kemomi/Btai-AR/眼镜板子/眼镜板子/_左镜腿主板下层/BOM_左镜腿主板下层V1.1_左镜腿主板下层_2026-10-14.xlsx

No. | Quantity | Comment | Designator | Footprint | Value | Manufacturer Part | Manufacturer | Supplier Part | Supplier | Add into BOM | Convert to PCB | 3D Model Title | Device | Name | Symbol | Unique ID | Category | Primary Category | Secondary Category | Category3 | Category4 | Category5 | Pin Count | drawing:Y Region Count | drawing:X Region Count | drawing:Width | drawing:Version | drawing:Title Block Position | drawing:Title Block | drawing:Symbol | drawing:Size | drawing:Reviewed | drawing:Region Start | drawing:Part Number | drawing:Page Size | drawing:Name | drawing:Height | drawing:Footprint | drawing:Drawed | drawing:Description | drawing:Device | drawing:Company | drawing:Color | drawing:Border | drawing:Blade Width
1 | 1 | 10NF | C1 | C0201 | 10NF | GRM033R61E104KE14D | muRata(村田) |  | LCSC | yes |  | C0201_L0.6-W0.3-H0.3 | GRM033R61E104KE14D | 10NF |  | gge14823 |  |  |  |  |  |  | 2
2 | 6 | 10UF | C2,C5,C7,C8,C29,C37 | C0402 | 10UF | CL05B104KO5NNNC | SAMSUNG(三星) |  | LCSC | yes |  | C0402_L1.0-W0.5-H0.5 | CL05B104KO5NNNC | 10UF |  | gge187,gge188,gge14821,gge14824,gge14824_0,gge14838 |  |  |  |  |  |  | 2
3 | 5 | 22UF | C3,C4,C23,C24,C208 | C0603 | 22UF |  |  |  |  | yes |  | C0603_L1.6-W0.8-H0.8 | CAP_0603 | 22UF |  | gge14755,gge14755_0,gge14755_1,gge14828,gge14829 |  |  |  |  |  |  | 2
4 | 16 | 100nF | C6,C9,C12,C14,C15,C16,C17,C20,C25,C26,C27,C28,C30,C31,C44,C45 | C0201 | 100nF | GRM033R61E104KE14D | muRata(村田) | C76939 | LCSC | yes |  | C0201_L0.6-W0.3-H0.3 | GRM033R61E104KE14D | 100nF |  | gge189,gge14782,gge14782_0,gge14783,gge14783_0,gge14842,gge14843,gge14844,gge14845,gge14849,gge14853_0,gge14854,gge14855,gge14859,gge14860,gge14864 |  |  |  |  |  |  | 2
5 | 5 | 1UF | C10,C11,C13,C21,C22 | C0201 | 1UF | GRM033R61E104KE14D | muRata(村田) |  | LCSC | yes |  | C0201_L0.6-W0.3-H0.3 | GRM033R61E104KE14D | 1UF |  | gge190,gge14832,gge14834,gge14850,gge14851 |  |  |  |  |  |  | 2
6 | 2 | 2.7PF | C18,C19 | C0201 | 2.7PF | GRM033R61E104KE14D | muRata(村田) |  | LCSC | yes |  | C0201_L0.6-W0.3-H0.3 | GRM033R61E104KE14D | 2.7PF |  | gge14846,gge14847 |  |  |  |  |  |  | 2
7 | 6 | 22uF | C72,C73,C74,C75,C76,C77 | C0603-NSK | 22uF |  |  |  |  | yes |  | C0603_L1.6-W0.8-H0.8 | CAP_0603 | 22uF |  | gge208_6,gge208_7,gge209_2,gge209_3,gge210_2,gge210_3 |  |  |  |  |  |  | 2
8 | 1 | GT-B0354FSV06-16B1202 | CN2 | CONN-SMD_16P-P0.35_GT-B0354FSV06-16B1202 |  | GT-B0354FSV06-16B1202 | G-Switch(品赞) | C53222297 | LCSC | yes |  | CONN-SMD_16P-P0.35_GT-B0354FSV06-16B1202 | GT-B0354FSV06-16B1202 | GT-B0354FSV06-16B1202 |  | gge14891 |  |  |  |  |  |  | 22
9 | 1 | X0813FVS-06A-LPV01 | CN4 | CONN-SMD_XKB_X0813FVS-06A-LPV01 |  | X0813FVS-06A-LPV01 | XKB Connection(中国星坤) | C3020508 | LCSC | yes |  | CONN-SMD_XKB_X0813FVS-06A-LPV01 | X0813FVS-06A-LPV01 | X0813FVS-06A-LPV01 |  | gge4_6 |  |  |  |  |  |  | 10
10 | 1 | 1uH | L1 | IND-SMD_L2.0-W1.6-B | 1uH | FTC201610S1R0MBCA | cjiang(长江微电) | C5832342 | LCSC | yes |  | IND-SMD_L2.0-W1.6-B | FTC201610S1R0MBCA | 1uH |  | gge14827 |  |  |  |  |  |  | 2
11 | 1 | 2nH | L2 | L0201 | 2nH | SDCL0603Q2N0CT02B01 | Sunlord(顺络) | C370136 | LCSC | yes |  | L0201-RD | SDCL0603Q2N0CT02B01 | 2nH |  | gge14848 |  |  |  |  |  |  | 2
12 | 1 | 10uH | L3 | L0603 | 10uH | XRTC160808S100MBCA | XR(祥如) | C39846679 | LCSC | yes |  | L0603_L1.6-W0.8-H0.5_BEAD | XRTC160808S100MBCA | 10uH |  | gge194 |  |  |  |  |  |  | 2
13 | 3 | 2.2uH | L4,L5,L6 | IND-SMD_L2.0-W1.6 | 2.2uH | CKCS201610-2.2uH/M | CENKER(岑科) | C354533 | LCSC | yes |  | IND-SMD_L2.0-W1.6-H1.1 | CKCS201610-2.2uH/M | 2.2uH |  | gge4_3,gge4_4,gge4_5 |  |  |  |  |  |  | 2
14 | 1 | 2.2UH | L16 | IND-SMD_L2.0-W1.6 | 2.2UH | WPN201610H100MT | Sunlord(顺络) |  | LCSC | yes |  | IND-SMD_L2.0-W1.6-H1.1 | WPN201610H100MT | 2.2UH |  | gge14832_1 |  |  |  |  |  |  | 2
15 | 1 | LED_0603-R | LED8 | LED_0603 |  |  |  |  |  | yes |  | LED-0603_R | LED_0603-R |  |  | gge14754 |  |  |  |  |  |  | 2
16 | 1 | LED_0402-R | LED10 | LED_0402 |  |  |  |  |  | yes |  | LED0402-FD_YELLOW | LED_0402-R |  |  | gge38_4 |  |  |  |  |  |  | 2
17 | 1 | WMM7027ATSN1-4/TR | MIC6 | MIC-SMD_4P-L2.8-W1.9-P1.84-TL |  | WMM7027ATSN1-4/TR | WILLSEMI(韦尔) | C2931973 | LCSC | yes |  | MIC-SMD_4P-L2.8-W1.9-H1.0-P1.84-TL | WMM7027ATSN1-4/TR | WMM7027ATSN1-4/TR |  | gge14751_3 |  |  |  |  |  |  | 4
18 | 1 | 316K | R1 | R0201 | 316K | 0201WMF1002TEE | UNI-ROYAL(厚声) |  | LCSC | yes |  | R0201_L0.6-W0.3-H0.3 | 0201WMF1002TEE | 316K |  | gge14825 |  |  |  |  |  |  | 2
19 | 1 | 100K | R2 | R0201 | 100K | 0201WMF1002TEE | UNI-ROYAL(厚声) |  | LCSC | yes |  | R0201_L0.6-W0.3-H0.3 | 0201WMF1002TEE | 100K |  | gge14826 |  |  |  |  |  |  | 2
20 | 1 | 0R | R3 | R0201 | 0R | 0201WMF1002TEE | UNI-ROYAL(厚声) |  | LCSC | yes |  | R0201_L0.6-W0.3-H0.3 | 0201WMF1002TEE | 0R |  | gge14856 |  |  |  |  |  |  | 2
21 | 1 | 100kΩ | R4 | R0201 | 100kΩ | 0201WMF1002TEE | UNI-ROYAL(厚声) |  | LCSC | yes |  | R0201_L0.6-W0.3-H0.3 | 0201WMF1002TEE | 100kΩ |  | gge14863 |  |  |  |  |  |  | 2
22 | 1 | 1M | R11 | R0201 | 1M | 0201WMF1002TEE | UNI-ROYAL(厚声) |  | LCSC | yes |  | R0201_L0.6-W0.3-H0.3 | 0201WMF1002TEE | 1M |  | gge14831 |  |  |  |  |  |  | 2
23 | 1 | 470R | R12 | R0201 | 470R | 0201WMF1002TEE | UNI-ROYAL(厚声) |  | LCSC | yes |  | R0201_L0.6-W0.3-H0.3 | 0201WMF1002TEE | 470R |  | gge14833 |  |  |  |  |  |  | 2
24 | 3 | 4.7K | R13,R14,R15 | R0201 | 4.7K | 0201WMF1002TEE | UNI-ROYAL(厚声) |  | LCSC | yes |  | R0201_L0.6-W0.3-H0.3 | 0201WMF1002TEE | 4.7K |  | gge14835,gge14836,gge14837 |  |  |  |  |  |  | 2
25 | 1 | 500R | R20 | R0201 | 500R | 0201WMF1002TEE | UNI-ROYAL(厚声) |  | LCSC | yes |  | R0201_L0.6-W0.3-H0.3 | 0201WMF1002TEE | 500R |  | gge14816 |  |  |  |  |  |  | 2
26 | 1 | 2K | R21 | R0201 | 2K | 0201WMF1002TEE | UNI-ROYAL(厚声) |  | LCSC | yes |  | R0201_L0.6-W0.3-H0.3 | 0201WMF1002TEE | 2K |  | gge14817 |  |  |  |  |  |  | 2
27 | 1 | 1K | R22 | R0201 | 1K | 0201WMF1002TEE | UNI-ROYAL(厚声) |  | LCSC | yes |  | R0201_L0.6-W0.3-H0.3 | 0201WMF1002TEE | 1K |  | gge14819 |  |  |  |  |  |  | 2
28 | 1 | 680K | R36 | R0201 NSK | 680K |  |  |  |  | yes |  | R0201_L0.6-W0.3-H0.3 | Res_0201 | 680K |  | gge159_1 |  |  |  |  |  |  | 2
29 | 2 | 150K | R37,R38 | R0201 NSK | 150K |  |  |  |  | yes |  | R0201_L0.6-W0.3-H0.3 | Res_0201 | 150K |  | gge161_1,gge164_1 |  |  |  |  |  |  | 2
30 | 2 | 100K | R39,R41 | R0201 NSK | 100K |  |  |  |  | yes |  | R0201_L0.6-W0.3-H0.3 | Res_0201 | 100K |  | gge162_1,gge166_1 |  |  |  |  |  |  | 2
31 | 1 | 75K | R40 | R0201 NSK | 75K |  |  |  |  | yes |  | R0201_L0.6-W0.3-H0.3 | Res_0201 | 75K |  | gge167_1 |  |  |  |  |  |  | 2
32 | 1 | 10K | R42 | R0201 NSK | 10K |  |  |  |  | yes |  | R0201_L0.6-W0.3-H0.3 | Res_0201 | 10K |  | gge144_2 |  |  |  |  |  |  | 2
33 | 1 | HC-PBB40C-40DP-0.4V-02 | U1 | CONN-SMD_40P-P0.40_HCTL_HC-PBB40C-40DP-0.4V-02 |  | HC-PBB40C-40DP-0.4V-02 | HCTL(华灿天禄) | C19089232 | LCSC | yes |  | CONN-SMD_40P-P0.40_HCTL_HC-PBB40C-40DP-0.4V-02 | HC-PBB40C-40DP-0.4V-02 | HC-PBB40C-40DP-0.4V-02 |  | gge14890 |  |  |  |  |  |  | 44
34 | 1 | HC-PBB40C-30DP-0.4V-02 | U2 | CONN-SMD_30P-P0.40_HCTL_HC-PBB40C-30DP-0.4V-02 |  | HC-PBB40C-30DP-0.4V-02 | HCTL(华灿天禄) | C19089230 | LCSC | yes |  | CONN-SMD_30P-P0.40_HCTL_HC-PBB40C-30DP-0.4V-02 | HC-PBB40C-30DP-0.4V-02 | HC-PBB40C-30DP-0.4V-02 |  | gge2 |  |  |  |  |  |  | 33
35 | 2 | ANT3216LL00R2400A | U3,U9 | ANT-SMD_L3.2-W1.6 |  | ANT3216LL00R2400A | YAGEO(国巨) | C293767 | LCSC | yes |  | ANT-SMD_L3.2-W1.6-H1.3 | ANT3216LL00R2400A | ANT3216LL00R2400A |  | gge14857,gge14858 |  |  |  |  |  |  | 2
36 | 1 | TPS61230ARNSR | U4 | VQFN-7_L2.1-W2.1-P0.50-BL |  | TPS61230ARNSR | TI(德州仪器) | C376005 | LCSC | yes |  | VQFN-7_L2.0-W2.0-H1.0-P0.50-BL | TPS61230ARNSR | TPS61230ARNSR |  | gge14822 |  |  |  |  |  |  | 7
37 | 1 | 9H03200083 | U5 | CRYSTAL-SMD_L1.6-W1.0 |  | 9H03200083 | TXC(晶技) | C5203623 | LCSC | yes |  | CRYSTAL-SMD_L1.6-W1.0 | 9H03200083 | 9H03200083 |  | gge192 |  |  |  |  |  |  | 2
38 | 1 | CH582F | U6 | QFN-28_L4.0-W4.0-P0.40-BL-EP2.8 |  | CH582F | WCH(南京沁恒) | C3001175 | LCSC | yes |  | QFN-28_L4.0-W4.0-P0.40-BL-EP2.8 | CH582F | CH582F |  | gge186 |  |  |  |  |  |  | 29
39 | 1 | CW2015CHBD | U8 | TDFN-8_L3.0-W2.0-P0.50-BL-EP |  | CW2015CHBD | Cellwise(赛微) | C881838 | LCSC | yes |  | TDFN-8_L3.0-W2.0-H0.8-P0.50 | CW2015CHBD | CW2015CHBD |  | gge14830 |  |  |  |  |  |  | 9
40 | 1 | EA3036CQBR | U10 | WQFN-20_L3.0-W3.0-P0.40-BL-EP |  | EA3036CQBR | everanalog(申风) | C570857 | LCSC | yes |  | WQFN-20_L3.0-W3.0-H0.8-P0.40 | EA3036CQBR | EA3036CQBR |  | gge158_1 |  |  |  |  |  |  | 21
41 | 2 | WAFER-MX1.25-3PWB | U11,U12 | CONN-SMD_3P-P1.25_WAFER-MX1.25-3PWB |  | WAFER-MX1.25-3PWB | XUNPU(讯普) | C3029360 | LCSC | yes |  |  | WAFER-MX1.25-3PWB | WAFER-MX1.25-3PWB |  | gge14861,gge14862 |  |  |  |  |  |  | 3
42 | 2 | XTP2038-300AD1CT | U13,U14 | UDFN-4_L1.0-W1.0-P0.65-TL |  | XTP2038-300AD1CT | XTX(芯天下) | C7422344 | LCSC | yes |  | UDFN-4_L1.0-W1.0-P0.65-TL | XTP2038-300AD1CT | XTP2038-300AD1CT |  | gge12_2,gge12_3 |  |  |  |  |  |  | 5
43 | 1 | JL7016G8 | U19 | QFN-32_L4.0-W4.0-P0.40-TL-EP2.7 |  | JL7016G8 | JL(杰理) | C22440782 | LCSC | yes |  | QFN-32_L4.0-W4.0-P0.40-TL-EP2.7 | JL7016G8 | JL7016G8 |  | gge60 |  |  |  |  |  |  | 33
44 | 1 | ETA6003Q3Q | U105 | QFN-16_L3.0-W3.0-P0.50-TL-EP1.7-2 |  | ETA6003Q3Q |  | C9900015321 | LCSC | yes |  | QFN-16_L3.0-W3.0-P0.50-TL-EP1.7-2 | ETA6003Q3Q | ETA6003Q3Q |  | gge14748 |  |  |  |  |  |  | 17
45 | 1 | 2.2uH | U106 | IND-SMD_L2.0-W1.6 | 2.2uH | FTC201612S2R2MBCA | cjiang(长江微电) | C18724414 | LCSC | yes |  | IND-SMD_L2.0-W1.6-H1.1 | FTC201612S2R2MBCA | 2.2uH |  | gge14758 |  |  |  |  |  |  | 2
46 | 1 | 32MHz | X4 | CRYSTAL-SMD_4P-L2.0-W1.6-BL | 32MHz | XL7EL89CKI-111YLC-32M | YXC(扬兴晶振) | C2965582 | LCSC | yes |  | CRYSTAL-SMD_4P-L2.0-W1.6-BL | XL7EL89CKI-111YLC-32M | 32MHz |  | gge14828_1 |  |  |  |  |  |  | 4
47 | 1 | 24MHz | X8 | CRYSTAL-SMD_4P-L2.0-W1.6-BL | 24MHz | XTM20024000JT00351001 | 同晶 | C37635323 | LCSC | yes |  | CRYSTAL-SMD_4P-L2.0-W1.6-BL | XTM20024000JT00351001 | 24MHz |  | gge48_4 |  |  |  |  |  |  | 4
