kemomi/Btai-AR/眼镜板子/眼镜板子/jbd_测试/BOM_jbd_测试V1.0_jbd_测试V1.0_2026-10-14.xlsx

No. | Quantity | Comment | Designator | Footprint | Value | Manufacturer Part | Manufacturer | Supplier Part | Supplier | Add into BOM | Convert to PCB | 3D Model Title | Device | Name | Symbol | Unique ID | Category | Primary Category | Secondary Category | Category3 | Category4 | Category5 | Pin Count | drawing:Y Region Count | drawing:X Region Count | drawing:Width | drawing:Version | drawing:Title Block Position | drawing:Title Block | drawing:Symbol | drawing:Size | drawing:Reviewed | drawing:Region Start | drawing:Part Number | drawing:Page Size | drawing:Name | drawing:Height | drawing:Footprint | drawing:Drawed | drawing:Description | drawing:Device | drawing:Company | drawing:Color | drawing:Border | drawing:Blade Width
1 | 1 | X3500FVS-40A-LPV01 | CN3 | CONN-SMD_40P-P0.35_XKB_X3500FVS-40A-LPV01 |  | X3500FVS-40A-LPV01 | XKB Connection(中国星坤) | C3020514 | LCSC | yes |  | CONN-SMD_40P-P0.35_XKB_X3500FVS-40A-LPV01 | X3500FVS-40A-LPV01 | X3500FVS-40A-LPV01 |  | gge14871 |  |  |  |  |  |  | 44
2 | 1 | X3500WVS-40A-LPV01 | CN4 | CONN-SMD_40P-P0.35_XKB_X3500WVS-40A-LPV01 |  | X3500WVS-40A-LPV01 | XKB Connection(中国星坤) | C3020515 | LCSC | yes |  | CONN-SMD_40P-P0.35_XKB_X3500WVS-40A-LPV01 | X3500WVS-40A-LPV01 | X3500WVS-40A-LPV01 |  | gge14872 |  |  |  |  |  |  | 44
3 | 1 | ZX-PZ2.54-1-15PZZ | U1 | HDR-TH_15P-P2.54-V-M |  | ZX-PZ2.54-1-15PZZ | Megastar(兆星) | C7501269 | LCSC | yes |  | HDR-TH_15P-P2.54-M-LI-1X15P | ZX-PZ2.54-1-15PZZ | ZX-PZ2.54-1-15PZZ |  | gge14873 |  |  |  |  |  |  | 15
