kemomi/Btai-AR/眼镜板子/眼镜板子/主电源排线/BOM_主电源FPC_1V1.1_主电源排线_1_2026-10-14.xlsx

No. | Quantity | Comment | Designator | Footprint | Value | Manufacturer Part | Manufacturer | Supplier Part | Supplier | Add into BOM | Convert to PCB | 3D Model Title | Device | Name | Symbol | Unique ID | Category | Primary Category | Secondary Category | Category3 | Category4 | Category5 | Pin Count | drawing:Y Region Count | drawing:X Region Count | drawing:Width | drawing:Version | drawing:Title Block Position | drawing:Title Block | drawing:Symbol | drawing:Size | drawing:Reviewed | drawing:Region Start | drawing:Part Number | drawing:Page Size | drawing:Name | drawing:Height | drawing:Footprint | drawing:Drawed | drawing:Description | drawing:Device | drawing:Company | drawing:Color | drawing:Border | drawing:Blade Width
1 | 1 | X0813WVS-06A-LPV01 | CN3 | CONN-SMD_XKB_X0813WVS-06A-LPV01 |  | X0813WVS-06A-LPV01 | XKB Connection(中国星坤) | C3020509 | LCSC | yes |  | CONN-SMD_XKB_X0813WVS-06A-LPV01 | X0813WVS-06A-LPV01 | X0813WVS-06A-LPV01 |  | gge14811 |  |  |  |  |  |  | 10
2 | 1 | PZ150V-05P | H1 | HDR-TH_PZ150V-05P |  | PZ150V-05P | XFCN(兴飞) | C7496731 | LCSC | yes |  | HDR-TH_PZ150V-05P | PZ150V-05P | PZ150V-05P |  | gge14827 |  |  |  |  |  |  | 5
