kemomi/Btai-AR/眼镜板子/眼镜板子/左侧单目光波导排线/BOM_左侧单目光波导排线V1.2_左侧单目光波导排线V1.2_2026-10-14.xlsx

No. | Quantity | Comment | Designator | Footprint | Value | Manufacturer Part | Manufacturer | Supplier Part | Supplier | Add into BOM | Convert to PCB | 3D Model Title | Device | Name | Symbol | Unique ID | Category | Primary Category | Secondary Category | Category3 | Category4 | Category5 | Pin Count | drawing:Y Region Count | drawing:X Region Count | drawing:Width | drawing:Version | drawing:Title Block Position | drawing:Title Block | drawing:Symbol | drawing:Size | drawing:Reviewed | drawing:Region Start | drawing:Part Number | drawing:Page Size | drawing:Name | drawing:Height | drawing:Footprint | drawing:Drawed | drawing:Description | drawing:Device | drawing:Company | drawing:Color | drawing:Border | drawing:Blade Width
1 | 1 | 505066-1422 | CN1 | CONN-SMD_5050661422 |  | 505066-1422 | MOLEX | C5346838 | LCSC | yes |  | CONN-SMD_5050661422 | 505066-1422 | 505066-1422 |  | gge14760_1 |  |  |  |  |  |  | 18
2 | 1 | 5050701422 | CN6 | CONN-SMD_14P-P0.35_5050701422 |  | 5050701422 | MOLEX | C6071717 | LCSC | yes |  | CONN-SMD_14P-P0.35_5050701422 | 5050701422_C6071717 | 5050701422 |  | gge14895 |  |  |  |  |  |  | 18
