kemomi/Btai-AR/眼镜板子/眼镜板子/左镜腿主板上层/BOM_左镜腿主板上层V1.1_左镜腿主板上层_2026-10-14.xlsx

No. | Quantity | Comment | Designator | Footprint | Value | Manufacturer Part | Manufacturer | Supplier Part | Supplier | Add into BOM | Convert to PCB | 3D Model Title | Device | Name | Symbol | Unique ID | Category | Primary Category | Secondary Category | Category3 | Category4 | Category5 | Pin Count | drawing:Y Region Count | drawing:X Region Count | drawing:Width | drawing:Version | drawing:Title Block Position | drawing:Title Block | drawing:Symbol | drawing:Size | drawing:Reviewed | drawing:Region Start | drawing:Part Number | drawing:Page Size | drawing:Name | drawing:Height | drawing:Footprint | drawing:Drawed | drawing:Description | drawing:Device | drawing:Company | drawing:Color | drawing:Border | drawing:Blade Width
1 | 1 | KH-1608-H08 | ANT2 | ANT-SMD_L1.7-W0.9 |  | KH-1608-H08 | kinghelm(金航标) | C2925416 | LCSC | yes |  | ANT-SMD_L1.7-W0.9 | KH-1608-H08 | KH-1608-H08 |  | gge14865 |  |  |  |  |  |  | 2
2 | 11 | 100nF | C1,C2,C10,C26,C43,C44,C45,C48,C50,C51,C64 | C0201 | 100nF | GRM033R61E104KE14D | muRata(村田) | C76939 | LCSC | yes |  | C0201_L0.6-W0.3-H0.3 | GRM033R61E104KE14D | 100nF |  | gge14759,gge14782,gge14783,gge14786,gge14787,gge14790,gge14791,gge14878,gge14879,gge14880,gge14881 |  |  |  |  |  |  | 2
3 | 9 | 100nF | C3,C4,C53,C56,C57,C58,C59,C60,C61 | C0402-NSK | 100nF |  |  |  |  | yes |  | C0402_L1.0-W0.5-H0.5 | CAP_0402 | 100nF |  | gge214,gge216_0,gge216_1,gge217,gge218,gge219,gge220,gge221,gge222 |  |  |  |  |  |  | 2
4 | 3 | 1UF | C5,C49,C85 | C0201 | 1UF | GRM033R61E104KE14D | muRata(村田) |  | LCSC | yes |  | C0201_L0.6-W0.3-H0.3 | GRM033R61E104KE14D | 1UF |  | gge14802,gge14803,gge14804 |  |  |  |  |  |  | 2
5 | 2 | 4.7uF | C6,C29 | C0201 NSK | 4.7uF | CL03A104KQ3NNNC | SAMSUNG(三星) |  | LCSC | yes |  | C0201_L0.6-W0.3-H0.3 | CL03A104KQ3NNNC | 4.7uF |  | gge178,gge199 |  |  |  |  |  |  | 2
6 | 3 | 1uF | C7,C8,C9 | C0201 NSK | 1uF | CL03A104KQ3NNNC | SAMSUNG(三星) |  | LCSC | yes |  | C0201_L0.6-W0.3-H0.3 | CL03A104KQ3NNNC | 1uF |  | gge168,gge179,gge180 |  |  |  |  |  |  | 2
7 | 2 | 10uf | C11,C84 | C0402 | 10uf | CL05B104KO5NNNC | SAMSUNG(三星) |  | LCSC | yes |  | C0402_L1.0-W0.5-H0.5 | CL05B104KO5NNNC | 10uf |  | gge14885,gge14886 |  |  |  |  |  |  | 2
8 | 30 | 100nF | C12,C13,C14,C15,C16,C17,C19,C20,C21,C22,C23,C24,C25,C27,C28,C32,C33,C34,C35,C36,C37,C38,C39,C40,C41,C42,C46,C47,C62,C78 | C0201 NSK | 100nF | CL03A104KQ3NNNC | SAMSUNG(三星) | C160831 | LCSC | yes |  | C0201_L0.6-W0.3-H0.3 | CL03A104KQ3NNNC | 100nF |  | gge141_1,gge141_3,gge141_4,gge147_5,gge169,gge181,gge181_1,gge181_2,gge182,gge182_1,gge182_2,gge182_3,gge182_4,gge183,gge183_1,gge183_2,gge183_3,gge183_4,gge184,gge185,gge185_1,gge186_1,gge187,gge188,gge189,gge190,gge191,gge192,gge195,gge196 |  |  |  |  |  |  | 2
9 | 2 | 33pF | C30,C31 | C0201 NSK | 33pF | CL03A104KQ3NNNC | SAMSUNG(三星) |  | LCSC | yes |  | C0201_L0.6-W0.3-H0.3 | CL03A104KQ3NNNC | 33pF |  | gge204,gge205 |  |  |  |  |  |  | 2
10 | 2 | 10pF | C70,C71 | C0201 NSK | 10pF | CL03A104KQ3NNNC | SAMSUNG(三星) |  | LCSC | yes |  | C0201_L0.6-W0.3-H0.3 | CL03A104KQ3NNNC | 10pF |  | gge147_3,gge147_4 |  |  |  |  |  |  | 2
11 | 1 | 2.2uF | C79 | C0201 NSK | 2.2uF | CL03A104KQ3NNNC | SAMSUNG(三星) |  | LCSC | yes |  | C0201_L0.6-W0.3-H0.3 | CL03A104KQ3NNNC | 2.2uF |  | gge193_1 |  |  |  |  |  |  | 2
12 | 1 | 470nF | C80 | C0201 NSK | 470nF | CL03A104KQ3NNNC | SAMSUNG(三星) |  | LCSC | yes |  | C0201_L0.6-W0.3-H0.3 | CL03A104KQ3NNNC | 470nF |  | gge194_1 |  |  |  |  |  |  | 2
13 | 1 | DF37NC-30DS-0.4V(51) | CN2 | CONN-SMD_DF37NC-30DS-0.4V-51 |  | DF37NC-30DS-0.4V(51) | HRS(广濑) | C424634 | LCSC | yes |  | CONN-SMD_DF37NC-30DS-0.4V-51 | DF37NC-30DS-0.4V(51) | DF37NC-30DS-0.4V(51) |  | gge598 |  |  |  |  |  |  | 30
14 | 1 | X3500FVS-40A-LPV01 | CN3 | CONN-SMD_40P-P0.35_XKB_X3500FVS-40A-LPV01 |  | X3500FVS-40A-LPV01 | XKB Connection(中国星坤) | C3020514 | LCSC | yes |  | CONN-SMD_40P-P0.35_XKB_X3500FVS-40A-LPV01 | X3500FVS-40A-LPV01 | X3500FVS-40A-LPV01 |  | gge14871 |  |  |  |  |  |  | 44
15 | 1 | X0813FVS-06A-LPV01 | CN4 | CONN-SMD_XKB_X0813FVS-06A-LPV01 |  | X0813FVS-06A-LPV01 | XKB Connection(中国星坤) | C3020508 | LCSC | yes |  | CONN-SMD_XKB_X0813FVS-06A-LPV01 | X0813FVS-06A-LPV01 | X0813FVS-06A-LPV01 |  | gge4_6 |  |  |  |  |  |  | 10
16 | 2 | PESD3V3Z1BSFYL-ES | D2,D9 | WLCSP-2_L0.6-W0.3-BI |  | PESD3V3Z1BSFYL-ES | ElecSuper(静芯) | C22464605 | LCSC | yes |  | WLCSP-2_L0.6-W0.3-BI | PESD3V3Z1BSFYL-ES | PESD3V3Z1BSFYL-ES |  | gge14731_2,gge14731_3 |  |  |  |  |  |  | 2
17 | 2 | ESD5V0L | D5,D10 | DFN1006-2L_L1.0-W0.6-P0.65-RD |  | ESD5V0L | YANGJIE(扬杰) | C20600744 | LCSC | yes |  | DFN1006-2L_L1.0-W0.6-P0.65-RD | ESD5V0L | ESD5V0L |  | gge14814_1,gge14814_2 |  |  |  |  |  |  | 2
18 | 1 | MIC-4013-G-G00 | MIC1 | MIC-SMD_BD4.0-4013_SMDA |  | MIC-4013-G-G00 | SAMZO(三佐) | C42371093 | LCSC | yes |  | MIC-SMD_BD4.0-4013_SMDA | MIC-4013-G-G00 | MIC-4013-G-G00 |  | gge206 |  |  |  |  |  |  | 3
19 | 3 | 4.7K | R1,R24,R25 | R0201 | 4.7K | 0201WMF1002TEE | UNI-ROYAL(厚声) |  | LCSC | yes |  | R0201_L0.6-W0.3-H0.3 | 0201WMF1002TEE | 4.7K |  | gge14874,gge14875,gge14882 |  |  |  |  |  |  | 2
20 | 3 | 1R | R2,R3,R10 | R0201 | 1R | 0201WMF1002TEE | UNI-ROYAL(厚声) |  | LCSC | yes |  | R0201_L0.6-W0.3-H0.3 | 0201WMF1002TEE | 1R |  | gge14882_0,gge14882_1,gge14882_2 |  |  |  |  |  |  | 2
21 | 4 | 33 | R4,R5,R20,R21 | R0201 NSK | 33 |  |  |  |  | yes |  | R0201_L0.6-W0.3-H0.3 | Res_0201 | 33 |  | gge170,gge171,gge200,gge201 |  |  |  |  |  |  | 2
22 | 2 | 10K | R6,R7 | R0201 | 10K | 0201WMF1002TEE | UNI-ROYAL(厚声) |  | LCSC | yes |  | R0201_L0.6-W0.3-H0.3 | 0201WMF1002TEE | 10K |  | gge14876,gge14877 |  |  |  |  |  |  | 2
23 | 2 | 2K | R8,R9 | R0201 NSK | 2K |  |  |  |  | yes |  | R0201_L0.6-W0.3-H0.3 | Res_0201 | 2K |  | gge201_1,gge201_2 |  |  |  |  |  |  | 2
24 | 2 | 5.1K | R12,R13 | R0201 NSK | 5.1K |  |  |  |  | yes |  | R0201_L0.6-W0.3-H0.3 | Res_0201 | 5.1K |  | gge145_2,gge145_3 |  |  |  |  |  |  | 2
25 | 2 | 100R | R15,R16 | R0201 | 100R | 0201WMF1002TEE | UNI-ROYAL(厚声) |  | LCSC | yes |  | R0201_L0.6-W0.3-H0.3 | 0201WMF1002TEE | 100R |  | gge14761,gge14888 |  |  |  |  |  |  | 2
26 | 2 | 1.5K | R18,R19 | R0201 NSK | 1.5K |  |  |  |  | yes |  | R0201_L0.6-W0.3-H0.3 | Res_0201 | 1.5K |  | gge197,gge198 |  |  |  |  |  |  | 2
27 | 2 | 1K | R22,R23 | R0201 NSK | 1K |  |  |  |  | yes |  | R0201_L0.6-W0.3-H0.3 | Res_0201 | 1K |  | gge202,gge203 |  |  |  |  |  |  | 2
28 | 1 | NC | R28 | R0201 NSK | NC |  |  |  |  | yes |  | R0201_L0.6-W0.3-H0.3 | Res_0201 | NC |  | gge174 |  |  |  |  |  |  | 2
29 | 2 | 0 | R29,R30 | R0201 NSK | 0 |  |  |  |  | yes |  | R0201_L0.6-W0.3-H0.3 | Res_0201 | 0 |  | gge172,gge173 |  |  |  |  |  |  | 2
30 | 2 | 10K | R43,R45 | R0201 NSK | 10K |  |  |  |  | yes |  | R0201_L0.6-W0.3-H0.3 | Res_0201 | 10K |  | gge144_3,gge148_1 |  |  |  |  |  |  | 2
31 | 1 | TS-1088-AR02016 | SW1 | SW-SMD_L3.9-W3.0-P4.45 |  | TS-1088-AR02016 | XUNPU(讯普) | C720477 | LCSC | yes |  | SW-SMD_L3.9-W2.9-H2.0-LS4.8 | TS-1088-AR02016 | TS-1088-AR02016 |  | gge14887 |  |  |  |  |  |  | 2
32 | 1 | SGM5223YWQ10/TR | U1 | UTQFN-10L_L1.8-W1.4-P0.40-BL |  | SGM5223YWQ10/TR | SGMICRO(圣邦微) | C201207 | LCSC | yes |  | UTQFN-10L_L1.8-W1.4-H0.8-P0.40-BL | SGM5223YWQ10/TR | SGM5223YWQ10/TR |  | gge10 |  |  |  |  |  |  | 10
33 | 1 | HC-PBB40C-40DS-0.4V-2.0-02 | U2 | CONN-SMD_40P-P0.40_HC-PBB40C-40DS-0.4V-2.0-02 |  | HC-PBB40C-40DS-0.4V-2.0-02 | HCTL(华灿天禄) | C19089258 | LCSC | yes |  | CONN-SMD_40P-P0.40_HC-PBB40C-40DS-0.4V-2.0-02 | HC-PBB40C-40DS-0.4V-2.0-02 | HC-PBB40C-40DS-0.4V-2.0-02 |  | gge14889 |  |  |  |  |  |  | 40
34 | 1 | V821X2-XXX | U5 | QFN-88_L9.0-W9.0-P0.35-BL-EP5.26 |  |  |  |  |  | yes |  | QFN-88_L9.0-W9.0-P0.35-BL-EP5.26 | V821X2-XXX | V821X2-XXX |  | gge102 |  |  |  |  |  |  | 89
35 | 1 | XTP2038-120AD1CT | U7 | UDFN-4_L1.0-W1.0-P0.65-TL |  | XTP2038-120AD1CT | XTX(芯天下) | C7422344 | LCSC | yes |  | UDFN-4_L1.0-W1.0-P0.65-TL | XTP2038-300AD1CT | XTP2038-120AD1CT |  | gge12_5 |  |  |  |  |  |  | 5
36 | 1 | PY25Q256HB | U11 | WSON-8_L6.0-W5.0-P1.27-BL-EP |  | PY25Q256HB | PUYA(普冉) | C559229 | LCSC | yes |  | WSON-8_L6.0-W5.0-H0.7-P1.27 | P25Q128L-WXH-IR | PY25Q256HB |  | gge14866 |  |  |  |  |  |  | 9
37 | 1 | XTP2038-280AD1CT | U14 | UDFN-4_L1.0-W1.0-P0.65-TL |  | XTP2038-280AD1CT | XTX(芯天下) | C7422344 | LCSC | yes |  | UDFN-4_L1.0-W1.0-P0.65-TL | XTP2038-300AD1CT | XTP2038-280AD1CT |  | gge12_2 |  |  |  |  |  |  | 5
38 | 1 | KLM8G1GETF-B041 | U16 | FBGA-153_L13.0-W11.5-P0.50_KLMAG1JETD-B041 |  | KLM8G1GETF-B041 | SAMSUNG(三星半导体) | C499918 | LCSC | yes |  | FBGA-153_L13.0-W11.5-H1.1-P0.50_KLMAG1JETD-B041 | KLM8G1GETF-B041 | KLM8G1GETF-B041 |  | gge1_1 |  |  |  |  |  |  | 153
39 | 1 | HC-PBB40C-30DS-0.4V-2.0-02 | U17 | CONN-SMD_30P-P0.40_HC-PBB40C-30DS-0.4V-2.0-02 |  | HC-PBB40C-30DS-0.4V-2.0-02 | HCTL(华灿天禄) | C19089256 | LCSC | yes |  | CONN-SMD_30P-P0.40_HC-PBB40C-30DS-0.4V-2.0-02 | HC-PBB40C-30DS-0.4V-2.0-02 | HC-PBB40C-30DS-0.4V-2.0-02 |  | gge14872 |  |  |  |  |  |  | 30
40 | 1 | XTP2038-180AD1CT | U18 | UDFN-4_L1.0-W1.0-P0.65-TL |  | XTP2038-180AD1CT | XTX(芯天下) | C7422344 | LCSC | yes |  | UDFN-4_L1.0-W1.0-P0.65-TL | XTP2038-300AD1CT | XTP2038-180AD1CT |  | gge12_4 |  |  |  |  |  |  | 5
41 | 1 | LSM6DSOXTR | U27 | LGA-14L_L3.0-W2.5-P0.50-TL |  | LSM6DSOXTR | ST(意法半导体) | C481766 | LCSC | yes |  | LGA-14_L2.5-W3.0-H0.9-P0.50 | LSM6DSOXTR | LSM6DSOXTR |  | gge590 |  |  |  |  |  |  | 14
42 | 1 | GT-USB-7095D | USB2 | TYPE-C-SMD_GT-USB-7095D |  | GT-USB-7095D | G-Switch(品赞) | C22387148 | LCSC | yes |  | TYPE-C-SMD_GT-USB-7095D | GT-USB-7095D | GT-USB-7095D |  | gge2 |  |  |  |  |  |  | 20
43 | 1 | 40MHz | X2 | osc-smd_4p-l2.0-w1.6-bl | 40MHz | Q22FA12800489 | EPSON(爱普生) |  | LCSC | yes |  | OSC-SMD_4P-L2.0-W1.6-H0.8 | Q22FA12800489 | 40MHz |  | gge40_1 |  |  |  |  |  |  | 4
