kemomi/Btai-AR/眼镜板子/眼镜板子/电池磁吸保护板/BOM_电池磁吸保护板V1.1_电池磁吸保护板_2026-10-14.xlsx

No. | Quantity | Comment | Designator | Footprint | Value | Manufacturer Part | Manufacturer | Supplier Part | Supplier | Add into BOM | Convert to PCB | 3D Model Title | Device | Name | Symbol | Unique ID | Category | Primary Category | Secondary Category | Category3 | Category4 | Category5 | Pin Count | drawing:Y Region Count | drawing:X Region Count | drawing:Width | drawing:Version | drawing:Title Block Position | drawing:Title Block | drawing:Symbol | drawing:Size | drawing:Reviewed | drawing:Region Start | drawing:Part Number | drawing:Page Size | drawing:Name | drawing:Height | drawing:Footprint | drawing:Drawed | drawing:Description | drawing:Device | drawing:Company | drawing:Color | drawing:Border | drawing:Blade Width
1 | 3 | BWCD-L5.0W2.0H2.5 | +,-,G | CONN-SMD_BWCD-L5.0W2.0H2.5 |  | BWCD-L5.0W2.0H2.5 | BAT WIRELESS(蝙蝠无线) | C2826549 | LCSC | yes |  | CONN-SMD_BWCD-L5.0W2.0H2.5 | BWCD-L5.0W2.0H2.5 | BWCD-L5.0W2.0H2.5 |  | gge1,gge1_1,gge1_2 |  |  |  |  |  |  | 1
2 | 1 | 100nF | C35 | C0201 | 100nF | GRM033R61E104KE14D | muRata(村田) | C76939 | LCSC | yes |  | C0201_L0.6-W0.3-H0.3 | GRM033R61E104KE14D | 100nF |  | gge14818 |  |  |  |  |  |  | 2
3 | 1 | AP6683 | U7 | DFN-4_L1.0-W1.0-P0.65-BL-EP |  | AP6683 | ALLPOWER(铨力) | C2849565 | LCSC | yes |  | DFN-4_L1.0-W1.0-H0.5-P0.65-BL-EP | AP6683 | AP6683 |  | gge14729 |  |  |  |  |  |  | 5
