kemomi/Btai-AR/眼镜板子/眼镜板子/触摸排线/BOM_触摸_按键排线V1.1_触摸排线_2026-10-14.xlsx

No. | Quantity | Comment | Designator | Footprint | Value | Manufacturer Part | Manufacturer | Supplier Part | Supplier | Add into BOM | Convert to PCB | 3D Model Title | Device | Name | Symbol | Unique ID | Category | Primary Category | Secondary Category | Category3 | Category4 | Category5 | Pin Count | drawing:Y Region Count | drawing:X Region Count | drawing:Width | drawing:Version | drawing:Title Block Position | drawing:Title Block | drawing:Symbol | drawing:Size | drawing:Reviewed | drawing:Region Start | drawing:Part Number | drawing:Page Size | drawing:Name | drawing:Height | drawing:Footprint | drawing:Drawed | drawing:Description | drawing:Device | drawing:Company | drawing:Color | drawing:Border | drawing:Blade Width
1 | 3 | 10PF | C4,C6,C28 | C0201 | 10PF | GRM033R61E104KE14D | muRata(村田) |  | LCSC | yes |  | C0201_L0.6-W0.3-H0.3 | GRM033R61E104KE14D | 10PF |  | gge14803,gge14803_0,gge14803_1 |  |  |  |  |  |  | 2
2 | 3 | 100nF | C5,C7,C29 | C0201 | 100nF | GRM033R61E104KE14D | muRata(村田) | C76939 | LCSC | yes |  | C0201_L0.6-W0.3-H0.3 | GRM033R61E104KE14D | 100nF |  | gge14804,gge14804_0,gge14804_1 |  |  |  |  |  |  | 2
3 | 1 | GT-B0354MSV05-06B1202 | CN1 | CONN-SMD_GT-B0354MSV05-10B1202 |  | GT-B0354MSV05-06B1202 | G-Switch(品赞) | C53222286 | LCSC | yes |  | CONN-SMD_GT-B0354MSV05-10B1202 | GT-B0354MSV05-10B1202 | GT-B0354MSV05-06B1202 |  | gge1_4 |  |  |  |  |  |  | 12
4 | 3 | 2K | R6,R7,R16 | R0201 | 2K | 0201WMF1002TEE | UNI-ROYAL(厚声) |  | LCSC | yes |  | R0201_L0.6-W0.3-H0.3 | 0201WMF1002TEE | 2K |  | gge14802,gge14802_0,gge14802_1 |  |  |  |  |  |  | 2
5 | 3 | touch | TP1,TP2,TP3 | touch |  |  |  |  |  | yes |  |  | touch |  |  | gge14826,gge14826_1,gge14826_2 |  |  |  |  |  |  | 1
6 | 3 | PT2051AD4 | U4,U5,U14 | DFN-4_L1.0-W1.0-P0.65-BL-EP-A |  | PT2051AD4 | PinTENG(品腾) | C2914243 | LCSC | yes |  | DFN-4_L1.0-W1.0-P0.65-BL-EP-A | PT2051AD4 | PT2051AD4 |  | gge14726,gge14726_0,gge14726_1 |  |  |  |  |  |  | 5
