kemomi/Btai-AR/眼镜板子/眼镜板子/钢网-主板/BOM_钢网-主板_2026-10-14.xlsx

No. | Quantity | Comment | Designator | Footprint | Value | Manufacturer Part | Manufacturer | Supplier Part | Supplier | Add into BOM | Convert to PCB | 3D Model Title | Device | Name | Symbol | Unique ID | Category | Primary Category | Secondary Category | Category3 | Category4 | Category5 | Pin Count | drawing:Y Region Count | drawing:X Region Count | drawing:Width | drawing:Version | drawing:Title Block Position | drawing:Title Block | drawing:Symbol | drawing:Size | drawing:Reviewed | drawing:Region Start | drawing:Part Number | drawing:Page Size | drawing:Name | drawing:Height | drawing:Footprint | drawing:Drawed | drawing:Description | drawing:Device | drawing:Company | drawing:Color | drawing:Border | drawing:Blade Width
1 | 1 | KH-1608-H08 | ANT2 | ANT-SMD_L1.7-W0.9 |  | KH-1608-H08 | kinghelm(金航标) | C2925416 | LCSC | yes |  | ANT-SMD_L1.7-W0.9 | KH-1608-H08 | KH-1608-H08 |  | gge14865 |  |  |  |  |  |  | 2
2 | 30 | 100nF | C1,C2,C10,C26,C43,C44,C45,C48,C50,C51,C52,C54,C63,C64,C67,C68,C69,C81,C82,C83,C86,C87,C88,C89,C90,C95,C98,C108,C110,C112 | C0201 | 100nF | GRM033R61E104KE14D | muRata(村田) | C76939 | LCSC | yes |  | C0201_L0.6-W0.3-H0.3 | GRM033R61E104KE14D | 100nF |  | gge189_1,gge14759,gge14782,gge14782_0,gge14782_1,gge14783,gge14783_0,gge14783_1,gge14786,gge14787,gge14790,gge14791,gge14804_0,gge14804_1,gge14804_2,gge14842,gge14843,gge14844,gge14845,gge14849,gge14853_0,gge14854,gge14855,gge14859,gge14860,gge14864,gge14878,gge14879,gge14880,gge14881 |  |  |  |  |  |  | 2
3 | 9 | 100nF | C3,C4,C53,C56,C57,C58,C59,C60,C61 | C0402-NSK | 100nF |  |  |  |  | yes |  | C0402_L1.0-W0.5-H0.5 | CAP_0402 | 100nF |  | gge214,gge216_0,gge216_1,gge217,gge218,gge219,gge220,gge221,gge222 |  |  |  |  |  |  | 2
4 | 8 | 1UF | C5,C49,C65,C66,C85,C91,C92,C93 | C0201 | 1UF | GRM033R61E104KE14D | muRata(村田) |  | LCSC | yes |  | C0201_L0.6-W0.3-H0.3 | GRM033R61E104KE14D | 1UF |  | gge190_1,gge14802,gge14803,gge14804,gge14832,gge14834,gge14850,gge14851 |  |  |  |  |  |  | 2
5 | 2 | 4.7uF | C6,C29 | C0201 NSK | 4.7uF | CL03A104KQ3NNNC | SAMSUNG(三星) |  | LCSC | yes |  | C0201_L0.6-W0.3-H0.3 | CL03A104KQ3NNNC | 4.7uF |  | gge178,gge199 |  |  |  |  |  |  | 2
6 | 3 | 1uF | C7,C8,C9 | C0201 NSK | 1uF | CL03A104KQ3NNNC | SAMSUNG(三星) |  | LCSC | yes |  | C0201_L0.6-W0.3-H0.3 | CL03A104KQ3NNNC | 1uF |  | gge168,gge179,gge180 |  |  |  |  |  |  | 2
7 | 2 | 10uf | C11,C84 | C0402 | 10uf | CL05B104KO5NNNC | SAMSUNG(三星) |  | LCSC | yes |  | C0402_L1.0-W0.5-H0.5 | CL05B104KO5NNNC | 10uf |  | gge14885,gge14886 |  |  |  |  |  |  | 2
8 | 30 | 100nF | C12,C13,C14,C15,C16,C17,C19,C20,C21,C22,C23,C24,C25,C27,C28,C32,C33,C34,C35,C36,C37,C38,C39,C40,C41,C42,C46,C47,C62,C78 | C0201 NSK | 100nF | CL03A104KQ3NNNC | SAMSUNG(三星) | C160831 | LCSC | yes |  | C0201_L0.6-W0.3-H0.3 | CL03A104KQ3NNNC | 100nF |  | gge141_1,gge141_3,gge141_4,gge147_5,gge169,gge181,gge181_1,gge181_2,gge182,gge182_1,gge182_2,gge182_3,gge182_4,gge183,gge183_1,gge183_2,gge183_3,gge183_4,gge184,gge185,gge185_1,gge186_1,gge187,gge188,gge189,gge190,gge191,gge192,gge195,gge196 |  |  |  |  |  |  | 2
9 | 2 | 2.7PF | C18,C55 | C0201 | 2.7PF | GRM033R61E104KE14D | muRata(村田) |  | LCSC | yes |  | C0201_L0.6-W0.3-H0.3 | GRM033R61E104KE14D | 2.7PF |  | gge14846,gge14847 |  |  |  |  |  |  | 2
10 | 2 | 33pF | C30,C31 | C0201 NSK | 33pF | CL03A104KQ3NNNC | SAMSUNG(三星) |  | LCSC | yes |  | C0201_L0.6-W0.3-H0.3 | CL03A104KQ3NNNC | 33pF |  | gge204,gge205 |  |  |  |  |  |  | 2
11 | 2 | 10pF | C70,C71 | C0201 NSK | 10pF | CL03A104KQ3NNNC | SAMSUNG(三星) |  | LCSC | yes |  | C0201_L0.6-W0.3-H0.3 | CL03A104KQ3NNNC | 10pF |  | gge147_3,gge147_4 |  |  |  |  |  |  | 2
12 | 6 | 22uF | C72,C73,C74,C75,C76,C77 | C0603-NSK | 22uF |  |  |  |  | yes |  | C0603_L1.6-W0.8-H0.8 | CAP_0603 | 22uF |  | gge208_6,gge208_7,gge209_2,gge209_3,gge210_2,gge210_3 |  |  |  |  |  |  | 2
13 | 1 | 2.2uF | C79 | C0201 NSK | 2.2uF | CL03A104KQ3NNNC | SAMSUNG(三星) |  | LCSC | yes |  | C0201_L0.6-W0.3-H0.3 | CL03A104KQ3NNNC | 2.2uF |  | gge193_1 |  |  |  |  |  |  | 2
14 | 1 | 470nF | C80 | C0201 NSK | 470nF | CL03A104KQ3NNNC | SAMSUNG(三星) |  | LCSC | yes |  | C0201_L0.6-W0.3-H0.3 | CL03A104KQ3NNNC | 470nF |  | gge194_1 |  |  |  |  |  |  | 2
15 | 5 | 22UF | C94,C97,C105,C106,C208 | C0603 | 22UF |  |  |  |  | yes |  | C0603_L1.6-W0.8-H0.8 | CAP_0603 | 22UF |  | gge14755,gge14755_0,gge14755_1,gge14828,gge14829 |  |  |  |  |  |  | 2
16 | 1 | 10NF | C96 | C0201 | 10NF | GRM033R61E104KE14D | muRata(村田) |  | LCSC | yes |  | C0201_L0.6-W0.3-H0.3 | GRM033R61E104KE14D | 10NF |  | gge14823 |  |  |  |  |  |  | 2
17 | 6 | 10UF | C99,C100,C101,C102,C103,C104 | C0402 | 10UF | CL05B104KO5NNNC | SAMSUNG(三星) |  | LCSC | yes |  | C0402_L1.0-W0.5-H0.5 | CL05B104KO5NNNC | 10UF |  | gge187_1,gge188_1,gge14821,gge14824,gge14824_0,gge14838 |  |  |  |  |  |  | 2
18 | 3 | 10PF | C107,C109,C111 | C0201 | 10PF | GRM033R61E104KE14D | muRata(村田) |  | LCSC | yes |  | C0201_L0.6-W0.3-H0.3 | GRM033R61E104KE14D | 10PF |  | gge14803_0,gge14803_1,gge14803_2 |  |  |  |  |  |  | 2
19 | 1 | GT-B0354FSV06-16B1202 | CN1 | CONN-SMD_16P-P0.35_GT-B0354FSV06-16B1202 |  | GT-B0354FSV06-16B1202 | G-Switch(品赞) | C53222297 | LCSC | yes |  | CONN-SMD_16P-P0.35_GT-B0354FSV06-16B1202 | GT-B0354FSV06-16B1202 | GT-B0354FSV06-16B1202 |  | gge14891 |  |  |  |  |  |  | 22
20 | 1 | DF37NC-30DS-0.4V(51) | CN2 | CONN-SMD_DF37NC-30DS-0.4V-51 |  | DF37NC-30DS-0.4V(51) | HRS(广濑) | C424634 | LCSC | yes |  | CONN-SMD_DF37NC-30DS-0.4V-51 | DF37NC-30DS-0.4V(51) | DF37NC-30DS-0.4V(51) |  | gge598 |  |  |  |  |  |  | 31
21 | 1 | X3500FVS-40A-LPV01 | CN3 | CONN-SMD_40P-P0.35_XKB_X3500FVS-40A-LPV01 |  | X3500FVS-40A-LPV01 | XKB Connection(中国星坤) | C3020514 | LCSC | yes |  | CONN-SMD_40P-P0.35_XKB_X3500FVS-40A-LPV01 | X3500FVS-40A-LPV01 | X3500FVS-40A-LPV01 |  | gge14871 |  |  |  |  |  |  | 44
22 | 2 | X0813FVS-06A-LPV01 | CN4,CN5 | CONN-SMD_XKB_X0813FVS-06A-LPV01 |  | X0813FVS-06A-LPV01 | XKB Connection(中国星坤) | C3020508 | LCSC | yes |  | CONN-SMD_XKB_X0813FVS-06A-LPV01 | X0813FVS-06A-LPV01 | X0813FVS-06A-LPV01 |  | gge4_6,gge4_7 |  |  |  |  |  |  | 10
23 | 1 | GT-B0354MSV05-06B1202 | CN6 | CONN-SMD_GT-B0354MSV05-10B1202 |  | GT-B0354MSV05-06B1202 | G-Switch(品赞) | C53222286 | LCSC | yes |  | CONN-SMD_GT-B0354MSV05-10B1202 | GT-B0354MSV05-10B1202 | GT-B0354MSV05-06B1202 |  | gge1_4 |  |  |  |  |  |  | 12
24 | 2 | PESD3V3Z1BSFYL-ES | D2,D9 | WLCSP-2_L0.6-W0.3-BI |  | PESD3V3Z1BSFYL-ES | ElecSuper(静芯) | C22464605 | LCSC | yes |  | WLCSP-2_L0.6-W0.3-BI | PESD3V3Z1BSFYL-ES | PESD3V3Z1BSFYL-ES |  | gge14731_2,gge14731_3 |  |  |  |  |  |  | 2
25 | 2 | ESD5V0L | D5,D10 | DFN1006-2L_L1.0-W0.6-P0.65-RD |  | ESD5V0L | YANGJIE(扬杰) | C20600744 | LCSC | yes |  | DFN1006-2L_L1.0-W0.6-P0.65-RD | ESD5V0L | ESD5V0L |  | gge14814_1,gge14814_2 |  |  |  |  |  |  | 2
26 | 1 | 1uH | L1 | IND-SMD_L2.0-W1.6-B | 1uH | FTC201610S1R0MBCA | cjiang(长江微电) | C5832342 | LCSC | yes |  | IND-SMD_L2.0-W1.6-B | FTC201610S1R0MBCA | 1uH |  | gge14827 |  |  |  |  |  |  | 2
27 | 1 | 2nH | L2 | L0201 | 2nH | SDCL0603Q2N0CT02B01 | Sunlord(顺络) | C370136 | LCSC | yes |  | L0201-RD | SDCL0603Q2N0CT02B01 | 2nH |  | gge14848 |  |  |  |  |  |  | 2
28 | 1 | 10uH | L3 | L0603 | 10uH | XRTC160808S100MBCA | XR(祥如) | C39846679 | LCSC | yes |  | L0603_L1.6-W0.8-H0.5_BEAD | XRTC160808S100MBCA | 10uH |  | gge194 |  |  |  |  |  |  | 2
29 | 3 | 2.2uH | L4,L5,L6 | IND-SMD_L2.0-W1.6 | 2.2uH | CKCS201610-2.2uH/M | CENKER(岑科) | C354533 | LCSC | yes |  | IND-SMD_L2.0-W1.6-H1.1 | CKCS201610-2.2uH/M | 2.2uH |  | gge4_3,gge4_4,gge4_5 |  |  |  |  |  |  | 2
30 | 1 | 2.2UH | L16 | IND-SMD_L2.0-W1.6 | 2.2UH | WPN201610H100MT | Sunlord(顺络) |  | LCSC | yes |  | IND-SMD_L2.0-W1.6-H1.1 | WPN201610H100MT | 2.2UH |  | gge14832_1 |  |  |  |  |  |  | 2
31 | 1 | LED_0603-R | LED8 | LED_0603 |  |  |  |  |  | yes |  | LED-0603_R | LED_0603-R |  |  | gge14754 |  |  |  |  |  |  | 2
32 | 1 | LED_0402-R | LED10 | LED_0402 |  |  |  |  |  | yes |  |  | LED_0402-R |  |  | gge38_4 |  |  |  |  |  |  | 2
33 | 1 | MIC-4013-G-G00 | MIC1 | MIC-SMD_BD4.0-4013_SMDA |  | MIC-4013-G-G00 | SAMZO(三佐) | C42371093 | LCSC | yes |  | MIC-SMD_BD4.0-4013_SMDA | MIC-4013-G-G00 | MIC-4013-G-G00 |  | gge206 |  |  |  |  |  |  | 0
34 | 1 | WMM7027ATSN1-4/TR | MIC6 | MIC-SMD_4P-L2.8-W1.9-P1.84-TL |  | WMM7027ATSN1-4/TR | WILLSEMI(韦尔) | C2931973 | LCSC | yes |  | MIC-SMD_4P-L2.8-W1.9-H1.0-P1.84-TL | WMM7027ATSN1-4/TR | WMM7027ATSN1-4/TR |  | gge14751_3 |  |  |  |  |  |  | 4
35 | 6 | 4.7K | R1,R14,R24,R25,R31,R32 | R0201 | 4.7K | 0201WMF1002TEE | UNI-ROYAL(厚声) |  | LCSC | yes |  | R0201_L0.6-W0.3-H0.3 | 0201WMF1002TEE | 4.7K |  | gge14835,gge14836,gge14837,gge14874,gge14875,gge14882 |  |  |  |  |  |  | 2
36 | 3 | 1R | R2,R3,R10 | R0201 | 1R | 0201WMF1002TEE | UNI-ROYAL(厚声) |  | LCSC | yes |  | R0201_L0.6-W0.3-H0.3 | 0201WMF1002TEE | 1R |  | gge14882_0,gge14882_1,gge14882_2 |  |  |  |  |  |  | 2
37 | 4 | 33 | R4,R5,R20,R21 | R0201 NSK | 33 |  |  |  |  | yes |  | R0201_L0.6-W0.3-H0.3 | Res_0201 | 33 |  | gge170,gge171,gge200,gge201 |  |  |  |  |  |  | 2
38 | 2 | 10K | R6,R7 | R0201 | 10K | 0201WMF1002TEE | UNI-ROYAL(厚声) |  | LCSC | yes |  | R0201_L0.6-W0.3-H0.3 | 0201WMF1002TEE | 10K |  | gge14876,gge14877 |  |  |  |  |  |  | 2
39 | 2 | 2K | R8,R9 | R0201 NSK | 2K |  |  |  |  | yes |  | R0201_L0.6-W0.3-H0.3 | Res_0201 | 2K |  | gge201_1,gge201_2 |  |  |  |  |  |  | 2
40 | 1 | 1M | R11 | R0201 | 1M | 0201WMF1002TEE | UNI-ROYAL(厚声) |  | LCSC | yes |  | R0201_L0.6-W0.3-H0.3 | 0201WMF1002TEE | 1M |  | gge14831 |  |  |  |  |  |  | 2
41 | 2 | 5.1K | R12,R13 | R0201 NSK | 5.1K |  |  |  |  | yes |  | R0201_L0.6-W0.3-H0.3 | Res_0201 | 5.1K |  | gge145_2,gge145_3 |  |  |  |  |  |  | 2
42 | 2 | 100R | R15,R16 | R0201 | 100R | 0201WMF1002TEE | UNI-ROYAL(厚声) |  | LCSC | yes |  | R0201_L0.6-W0.3-H0.3 | 0201WMF1002TEE | 100R |  | gge14761,gge14888 |  |  |  |  |  |  | 2
43 | 1 | 1K | R17 | R0201 | 1K | 0201WMF1002TEE | UNI-ROYAL(厚声) |  | LCSC | yes |  | R0201_L0.6-W0.3-H0.3 | 0201WMF1002TEE | 1K |  | gge14819 |  |  |  |  |  |  | 2
44 | 2 | 1.5K | R18,R19 | R0201 NSK | 1.5K |  |  |  |  | yes |  | R0201_L0.6-W0.3-H0.3 | Res_0201 | 1.5K |  | gge197,gge198 |  |  |  |  |  |  | 2
45 | 2 | 1K | R22,R23 | R0201 NSK | 1K |  |  |  |  | yes |  | R0201_L0.6-W0.3-H0.3 | Res_0201 | 1K |  | gge202,gge203 |  |  |  |  |  |  | 2
46 | 1 | 100kΩ | R26 | R0201 | 100kΩ | 0201WMF1002TEE | UNI-ROYAL(厚声) |  | LCSC | yes |  | R0201_L0.6-W0.3-H0.3 | 0201WMF1002TEE | 100kΩ |  | gge14863 |  |  |  |  |  |  | 2
47 | 1 | 0R | R27 | R0201 | 0R | 0201WMF1002TEE | UNI-ROYAL(厚声) |  | LCSC | yes |  | R0201_L0.6-W0.3-H0.3 | 0201WMF1002TEE | 0R |  | gge14856 |  |  |  |  |  |  | 2
48 | 1 | NC | R28 | R0201 NSK | NC |  |  |  |  | yes |  | R0201_L0.6-W0.3-H0.3 | Res_0201 | NC |  | gge174 |  |  |  |  |  |  | 2
49 | 2 | 0 | R29,R30 | R0201 NSK | 0 |  |  |  |  | yes |  | R0201_L0.6-W0.3-H0.3 | Res_0201 | 0 |  | gge172,gge173 |  |  |  |  |  |  | 2
50 | 1 | 470R | R33 | R0201 | 470R | 0201WMF1002TEE | UNI-ROYAL(厚声) |  | LCSC | yes |  | R0201_L0.6-W0.3-H0.3 | 0201WMF1002TEE | 470R |  | gge14833 |  |  |  |  |  |  | 2
51 | 1 | 316K | R34 | R0201 | 316K | 0201WMF1002TEE | UNI-ROYAL(厚声) |  | LCSC | yes |  | R0201_L0.6-W0.3-H0.3 | 0201WMF1002TEE | 316K |  | gge14825 |  |  |  |  |  |  | 2
52 | 1 | 100K | R35 | R0201 | 100K | 0201WMF1002TEE | UNI-ROYAL(厚声) |  | LCSC | yes |  | R0201_L0.6-W0.3-H0.3 | 0201WMF1002TEE | 100K |  | gge14826 |  |  |  |  |  |  | 2
53 | 1 | 680K | R36 | R0201 NSK | 680K |  |  |  |  | yes |  | R0201_L0.6-W0.3-H0.3 | Res_0201 | 680K |  | gge159_1 |  |  |  |  |  |  | 2
54 | 2 | 150K | R37,R38 | R0201 NSK | 150K |  |  |  |  | yes |  | R0201_L0.6-W0.3-H0.3 | Res_0201 | 150K |  | gge161_1,gge164_1 |  |  |  |  |  |  | 2
55 | 2 | 100K | R39,R41 | R0201 NSK | 100K |  |  |  |  | yes |  | R0201_L0.6-W0.3-H0.3 | Res_0201 | 100K |  | gge162_1,gge166_1 |  |  |  |  |  |  | 2
56 | 1 | 75K | R40 | R0201 NSK | 75K |  |  |  |  | yes |  | R0201_L0.6-W0.3-H0.3 | Res_0201 | 75K |  | gge167_1 |  |  |  |  |  |  | 2
57 | 3 | 10K | R42,R43,R45 | R0201 NSK | 10K |  |  |  |  | yes |  | R0201_L0.6-W0.3-H0.3 | Res_0201 | 10K |  | gge144_2,gge144_3,gge148_1 |  |  |  |  |  |  | 2
58 | 1 | 500R | R44 | R0201 | 500R | 0201WMF1002TEE | UNI-ROYAL(厚声) |  | LCSC | yes |  | R0201_L0.6-W0.3-H0.3 | 0201WMF1002TEE | 500R |  | gge14816 |  |  |  |  |  |  | 2
59 | 4 | 2K | R46,R47,R48,R49 | R0201 | 2K | 0201WMF1002TEE | UNI-ROYAL(厚声) |  | LCSC | yes |  | R0201_L0.6-W0.3-H0.3 | 0201WMF1002TEE | 2K |  | gge14802_0,gge14802_1,gge14802_2,gge14817 |  |  |  |  |  |  | 2
60 | 1 | TS-1088-AR02016 | SW1 | SW-SMD_L3.9-W3.0-P4.45 |  | TS-1088-AR02016 | XUNPU(讯普) | C720477 | LCSC | yes |  | SW-SMD_L3.9-W2.9-H2.0-LS4.8 | TS-1088-AR02016 | TS-1088-AR02016 |  | gge14887 |  |  |  |  |  |  | 2
61 | 1 | SGM5223YWQ10/TR | U1 | UTQFN-10L_L1.8-W1.4-P0.40-BL |  | SGM5223YWQ10/TR | SGMICRO(圣邦微) | C201207 | LCSC | yes |  | UTQFN-10L_L1.8-W1.4-H0.8-P0.40-BL | SGM5223YWQ10/TR | SGM5223YWQ10/TR |  | gge10 |  |  |  |  |  |  | 10
62 | 1 | HC-PBB40C-40DS-0.4V-2.0-02 | U2 | CONN-SMD_40P-P0.40_HC-PBB40C-40DS-0.4V-2.0-02 |  | HC-PBB40C-40DS-0.4V-2.0-02 | HCTL(华灿天禄) | C19089258 | LCSC | yes |  | CONN-SMD_40P-P0.40_HC-PBB40C-40DS-0.4V-2.0-02 | HC-PBB40C-40DS-0.4V-2.0-02 | HC-PBB40C-40DS-0.4V-2.0-02 |  | gge14889 |  |  |  |  |  |  | 40
63 | 2 | ANT3216LL00R2400A | U3,U9 | ANT-SMD_L3.2-W1.6 |  | ANT3216LL00R2400A | YAGEO(国巨) | C293767 | LCSC | yes |  | ANT-SMD_L3.2-W1.6-H1.3 | ANT3216LL00R2400A | ANT3216LL00R2400A |  | gge14857,gge14858 |  |  |  |  |  |  | 2
64 | 1 | TPS61230ARNSR | U4 | VQFN-7_L2.1-W2.1-P0.50-BL |  | TPS61230ARNSR | TI(德州仪器) | C376005 | LCSC | yes |  | VQFN-7_L2.0-W2.0-H1.0-P0.50-BL | TPS61230ARNSR | TPS61230ARNSR |  | gge14822 |  |  |  |  |  |  | 7
65 | 1 | V821X2-XXX | U5 | QFN-88_L9.0-W9.0-P0.35-BL-EP5.26 |  |  |  |  |  | yes |  | QFN-88_L9.0-W9.0-P0.35-BL-EP5.26 | V821X2-XXX | V821X2-XXX |  | gge102 |  |  |  |  |  |  | 89
66 | 1 | CH582F | U6 | QFN-28_L4.0-W4.0-P0.40-BL-EP2.8 |  | CH582F | WCH(南京沁恒) | C3001175 | LCSC | yes |  | QFN-28_L4.0-W4.0-P0.40-BL-EP2.8 | CH582F | CH582F |  | gge186 |  |  |  |  |  |  | 29
67 | 1 | XTP2038-120AD1CT | U7 | UDFN-4_L1.0-W1.0-P0.65-TL |  | XTP2038-120AD1CT | XTX(芯天下) | C7422344 | LCSC | yes |  | UDFN-4_L1.0-W1.0-P0.65-TL | XTP2038-300AD1CT | XTP2038-120AD1CT |  | gge12_5 |  |  |  |  |  |  | 5
68 | 1 | CW2015CHBD | U8 | TDFN-8_L3.0-W2.0-P0.50-BL-EP |  | CW2015CHBD | Cellwise(赛微) | C881838 | LCSC | yes |  | TDFN-8_L3.0-W2.0-H0.8-P0.50 | CW2015CHBD | CW2015CHBD |  | gge14830 |  |  |  |  |  |  | 9
69 | 1 | EA3036CQBR | U10 | WQFN-20_L3.0-W3.0-P0.40-BL-EP |  | EA3036CQBR | everanalog(申风) | C570857 | LCSC | yes |  | WQFN-20_L3.0-W3.0-H0.8-P0.40 | EA3036CQBR | EA3036CQBR |  | gge158_1 |  |  |  |  |  |  | 21
70 | 1 | PY25Q256HB | U11 | WSON-8_L6.0-W5.0-P1.27-BL-EP |  | PY25Q256HB | PUYA(普冉) | C559229 | LCSC | yes |  | WSON-8_L6.0-W5.0-H0.7-P1.27 | P25Q128L-WXH-IR | PY25Q256HB |  | gge14866 |  |  |  |  |  |  | 0
71 | 2 | WAFER-MX1.25-3PWB | U12,U15 | CONN-SMD_3P-P1.25_WAFER-MX1.25-3PWB |  | WAFER-MX1.25-3PWB | XUNPU(讯普) | C3029360 | LCSC | yes |  |  | WAFER-MX1.25-3PWB | WAFER-MX1.25-3PWB |  | gge14861,gge14862 |  |  |  |  |  |  | 3
72 | 2 | XTP2038-300AD1CT | U13,U20 | UDFN-4_L1.0-W1.0-P0.65-TL |  | XTP2038-300AD1CT | XTX(芯天下) | C7422344 | LCSC | yes |  | UDFN-4_L1.0-W1.0-P0.65-TL | XTP2038-300AD1CT | XTP2038-300AD1CT |  | gge12_3,gge12_6 |  |  |  |  |  |  | 5
73 | 1 | XTP2038-280AD1CT | U14 | UDFN-4_L1.0-W1.0-P0.65-TL |  | XTP2038-280AD1CT | XTX(芯天下) | C7422344 | LCSC | yes |  | UDFN-4_L1.0-W1.0-P0.65-TL | XTP2038-300AD1CT | XTP2038-280AD1CT |  | gge12_2 |  |  |  |  |  |  | 5
74 | 1 | KLM8G1GETF-B041 | U16 | FBGA-153_L13.0-W11.5-P0.50_KLMAG1JETD-B041 |  | KLM8G1GETF-B041 | SAMSUNG(三星半导体) | C499918 | LCSC | yes |  | FBGA-153_L13.0-W11.5-H1.1-P0.50_KLMAG1JETD-B041 | KLM8G1GETF-B041 | KLM8G1GETF-B041 |  | gge1_1 |  |  |  |  |  |  | 153
75 | 1 | HC-PBB40C-30DS-0.4V-2.0-02 | U17 | CONN-SMD_30P-P0.40_HC-PBB40C-30DS-0.4V-2.0-02 |  | HC-PBB40C-30DS-0.4V-2.0-02 | HCTL(华灿天禄) | C19089256 | LCSC | yes |  | CONN-SMD_30P-P0.40_HC-PBB40C-30DS-0.4V-2.0-02 | HC-PBB40C-30DS-0.4V-2.0-02 | HC-PBB40C-30DS-0.4V-2.0-02 |  | gge14872 |  |  |  |  |  |  | 30
76 | 1 | XTP2038-180AD1CT | U18 | UDFN-4_L1.0-W1.0-P0.65-TL |  | XTP2038-180AD1CT | XTX(芯天下) | C7422344 | LCSC | yes |  | UDFN-4_L1.0-W1.0-P0.65-TL | XTP2038-300AD1CT | XTP2038-180AD1CT |  | gge12_4 |  |  |  |  |  |  | 5
77 | 1 | JL7016G8 | U19 | QFN-32_L4.0-W4.0-P0.40-TL-EP2.7 |  | JL7016G8 | JL(杰理) | C22440782 | LCSC | yes |  | QFN-32_L4.0-W4.0-P0.40-TL-EP2.7 | JL7016G8 | JL7016G8 |  | gge60 |  |  |  |  |  |  | 33
78 | 1 | 9H03200083 | U21 | CRYSTAL-SMD_L1.6-W1.0 |  | 9H03200083 | TXC(晶技) | C5203623 | LCSC | yes |  | CRYSTAL-SMD_L1.6-W1.0 | 9H03200083 | 9H03200083 |  | gge192_1 |  |  |  |  |  |  | 2
79 | 1 | HC-PBB40C-40DP-0.4V-02 | U22 | CONN-SMD_40P-P0.40_HCTL_HC-PBB40C-40DP-0.4V-02 |  | HC-PBB40C-40DP-0.4V-02 | HCTL(华灿天禄) | C19089232 | LCSC | yes |  | CONN-SMD_40P-P0.40_HCTL_HC-PBB40C-40DP-0.4V-02 | HC-PBB40C-40DP-0.4V-02 | HC-PBB40C-40DP-0.4V-02 |  | gge14890 |  |  |  |  |  |  | 44
80 | 1 | HC-PBB40C-30DP-0.4V-02 | U23 | CONN-SMD_30P-P0.40_HCTL_HC-PBB40C-30DP-0.4V-02 |  | HC-PBB40C-30DP-0.4V-02 | HCTL(华灿天禄) | C19089230 | LCSC | yes |  | CONN-SMD_30P-P0.40_HCTL_HC-PBB40C-30DP-0.4V-02 | HC-PBB40C-30DP-0.4V-02 | HC-PBB40C-30DP-0.4V-02 |  | gge2_1 |  |  |  |  |  |  | 33
81 | 3 | PT2051AD4 | U24,U25,U26 | DFN-4_L1.0-W1.0-P0.65-BL-EP-A |  | PT2051AD4 | PinTENG(品腾) | C2914243 | LCSC | yes |  | DFN-4_L1.0-W1.0-P0.65-BL-EP-A | PT2051AD4 | PT2051AD4 |  | gge14726,gge14726_0,gge14726_1 |  |  |  |  |  |  | 5
82 | 1 | LSM6DSOXTR | U27 | LGA-14L_L3.0-W2.5-P0.50-TL |  | LSM6DSOXTR | ST(意法半导体) | C481766 | LCSC | yes |  | LGA-14_L2.5-W3.0-H0.9-P0.50 | LSM6DSOXTR | LSM6DSOXTR |  | gge590 |  |  |  |  |  |  | 14
83 | 3 | touch | U28,U29,U30 | touch |  |  |  |  |  | yes |  |  | touch |  |  | gge14826_1,gge14826_2,gge14826_3 |  |  |  |  |  |  | 1
84 | 1 | ETA6003Q3Q | U105 | QFN-16_L3.0-W3.0-P0.50-TL-EP1.7-2 |  | ETA6003Q3Q |  | C9900015321 | LCSC | yes |  | QFN-16_L3.0-W3.0-P0.50-TL-EP1.7-2 | ETA6003Q3Q | ETA6003Q3Q |  | gge14748 |  |  |  |  |  |  | 17
85 | 1 | 2.2uH | U106 | IND-SMD_L2.0-W1.6 | 2.2uH | FTC201612S2R2MBCA | cjiang(长江微电) | C18724414 | LCSC | yes |  | IND-SMD_L2.0-W1.6-H1.1 | FTC201612S2R2MBCA | 2.2uH |  | gge14758 |  |  |  |  |  |  | 2
86 | 1 | GT-USB-7095D | USB2 | TYPE-C-SMD_GT-USB-7095D |  | GT-USB-7095D | G-Switch(品赞) | C22387148 | LCSC | yes |  | TYPE-C-SMD_GT-USB-7095D | GT-USB-7095D | GT-USB-7095D |  | gge2 |  |  |  |  |  |  | 20
87 | 1 | 40MHz | X2 | osc-smd_4p-l2.0-w1.6-bl | 40MHz | Q22FA12800489 | EPSON(爱普生) |  | LCSC | yes |  | OSC-SMD_4P-L2.0-W1.6-H0.8 | Q22FA12800489 | 40MHz |  | gge40_1 |  |  |  |  |  |  | 4
88 | 1 | 32MHz | X4 | CRYSTAL-SMD_4P-L2.0-W1.6-BL | 32MHz | XL7EL89CKI-111YLC-32M | YXC(扬兴晶振) | C2965582 | LCSC | yes |  | CRYSTAL-SMD_4P-L2.0-W1.6-BL | XL7EL89CKI-111YLC-32M | 32MHz |  | gge14828_1 |  |  |  |  |  |  | 4
89 | 1 | 24MHz | X8 | CRYSTAL-SMD_4P-L2.0-W1.6-BL | 24MHz | XTM20024000JT00351001 | 同晶 | C37635323 | LCSC | yes |  | CRYSTAL-SMD_4P-L2.0-W1.6-BL | XTM20024000JT00351001 | 24MHz |  | gge48_4 |  |  |  |  |  |  | 4
