kemomi/Btai-AR/BOM_光波导AR眼镜_Btai1.xlsx

Sheet: sheet
ID | Name | Designator | Footprint | Quantity | Manufacturer Part | Manufacturer | Supplier | Supplier Part
1 | GT-B0354MSV05-06B1202 | CN1 | CONN-SMD_GT-B0354MSV05-10B1202 | 1 | GT-B0354MSV05-06B1202 | G-Switch(品赞) | LCSC | C53222286

Sheet: Sheet1
ID | Name | Designator | Footprint | Quantity | Manufacturer Part | Manufacturer | Supplier | Supplier Part
1 | GT-B0354MSV05-06B1202 | CN1,CN5,CN10,CN11,CN12 | CONN-SMD_GT-B0354MSV05-10B1202 | 5 | GT-B0354MSV05-06B1202 | G-Switch(品赞) | LCSC | C53222286
2 | BWCD-L5.0W2.0H2.5 | -,+,G,-1,+1,G1,-2,+2,G2,U32,U33,U34,U49,U50,U51 | CONN-SMD_BWCD-L5.0W2.0H2.5 | 15 | BWCD-L5.0W2.0H2.5 | BAT WIRELESS(蝙蝠无线) | LCSC | C2826549
3 | AP6683 | U7,U2,U3,U30,U47 | DFN-4_L1.0-W1.0-P0.65-BL-EP | 5 | AP6683 | ALLPOWER(铨力) | LCSC | C2849565
4 | 100nF | C35,C4,C1,C5,C3,C82,C81,C8,C14,C63,C52,C18,C13,C15,C17,C11,C7,C175,C174,C2,C6,C29,C16,C20,C22,C31,C33,C36,C37,C38,C41,C42,C64,C46,C50,C55,C56,C57,C60,C61,C62,C68,C72 | C0201 | 43 | GRM033R61E104KE14D | muRata(村田) | LCSC | C76939
5 | DF37NC-30DS-0.4V(51) | CN2 | CONN-SMD_DF37NC-30DS-0.4V-51 | 1 | DF37NC-30DS-0.4V(51) | HRS(广濑) | LCSC | C424634
6 | DF37C-30DP-0.4V(51) | CN3 | CONN-SMD_DF37C-30DP-0.4V-51 | 1 | DF37C-30DP-0.4V(51) | HRS(广濑) | LCSC | C324722
7 | GT-B0354MSV05-16B1202 | GT-B0354MSV05-10B1202,GT-B0354MSV05-10B1 | GT-B0354MSV05-10B1202 | 2
8 | X0813WVS-06A-LPV01 | CN4 | CONN-SMD_XKB_X0813WVS-06A-LPV01 | 1 | X0813WVS-06A-LPV01 | XKB Connection(中国星坤) | LCSC | C3020509
9 | PZ150V-05P | H1 | HDR-TH_PZ150V-05P | 1 | PZ150V-05P | XFCN(兴飞) | LCSC | C7496731
10 | X3500WVS-40A-LPV01 | CN6,CN13,CN14 | CONN-SMD_40P-P0.35_XKB_X3500WVS-40A-LPV01 | 3 | X3500WVS-40A-LPV01 | XKB Connection(中国星坤) | LCSC | C3020515
11 | 10kΩ | R2,R9,R8,R1,R3,R19,R23,R42 | R0201 | 8 | 0201WMF1002TEE | UNI-ROYAL(厚声) | LCSC | C473048
12 | 10UF | C25,C45,C49,C67,C71 | C0402 | 5 | CL05B104KO5NNNC | SAMSUNG(三星) | LCSC
13 | 10uH | L1 | L0603 | 1 | SLM1608100MIT | Sunltech(顺磁) | LCSC | C2831366
14 | K3-1386S-F1 | SW3 | SW-SMD_K3-1386S-F1 | 1 | K3-1386S-F1 | 韩国韩荣 | LCSC | C502345
15 | 10K | R15,R31,R33,R48,R49 | R0201 | 5 | 0201WMF1002TEE | UNI-ROYAL(厚声) | LCSC
16 | 0R | R14,R7 | R0201 | 2 | 0201WMF1002TEE | UNI-ROYAL(厚声) | LCSC
17 | 47K | R12,R13 | R0201 | 2 | 0201WMF1002TEE | UNI-ROYAL(厚声) | LCSC
18 | 33NF | C24,C23 | C0201 | 2 | GRM033R61E104KE14D | muRata(村田) | LCSC
19 | GT-B0354FSV06-06B1202 | CN7 | CONN-SMD_6P-P0.35_GT-B0354FSV06-06B1202 | 1 | GT-B0354FSV06-06B1202 | G-Switch(品赞) | LCSC | C53222295
20 | 22PF | C27,C26 | C0201 | 2 | GRM033R61E104KE14D | muRata(村田) | LCSC
21 | AW8010AFCR | U102 | FC-9_L1.5-W1.5-R3-C3-P0.50-BL | 1 | AW8010AFCR | AWINIC(艾为) | LCSC | C164085
22 | PESD3V3Z1BSFYL-ES | D4,D1 | WLCSP-2_L0.6-W0.3-BI | 2 | PESD3V3Z1BSFYL-ES | ElecSuper(静芯) | LCSC | C22464605
23 | K3-1392M-E1 | SW1 | SW-SMD_K3-1392M-E1 | 1 | K3-1392M-E1 | 韩国韩荣 | LCSC | C2911491
24 | 505066-1422 | CN8,CN9,CN16 | CONN-SMD_5050661422 | 3 | 505066-1422 | MOLEX | LCSC | C5346838
25 | 1K | R22,R27 | R0201 | 2 | 0201WMF1002TEE | UNI-ROYAL(厚声) | LCSC
26 | LED_0603-R | LED8 | LED_0603 | 1
27 | XTP2038-120AD1CT | U9 | UDFN-4_L1.0-W1.0-P0.65-TL | 1 | XTP2038-120AD1CT | XTX(芯天下) | LCSC | C7422344
28 | LM27761DSGR | U1 | WSON-8_L2.0-W2.0-P0.65-BL-EP | 1 | LM27761DSGR | TI(德州仪器) | LCSC | C129351
29 | 158K | R5 | R0201 | 1 | 0201WMF1002TEE | UNI-ROYAL(厚声) | LCSC
30 | RS0108YTQC20 | U103 | QFN-20_L3.0-W3.0-P0.40-BL-EP1.7 | 1 | RS0108YTQC20 | RUNIC(润石) | LCSC | C5129983
31 | XTP2038-250AD1CT | U15 | UDFN-4_L1.0-W1.0-P0.65-TL | 1 | XTP2038-250AD1CT | XTX(芯天下) | LCSC | C7422344
32 | 4.7UF | C227,C223,C226 | C0402 | 3 | CL05B104KO5NNNC | SAMSUNG(三星) | LCSC
33 | 10NF | C9,C10 | C0201 | 2 | GRM033R61E104KE14D | muRata(村田) | LCSC
34 | 33R | R10 | R0201 | 1 | 0201WMF1002TEE | UNI-ROYAL(厚声) | LCSC
35 | 100K | R4 | R0201 | 1 | 0201WMF1002TEE | UNI-ROYAL(厚声) | LCSC
36 | 24MHz | X5 | OSC-SMD_4P-L2.0-W1.6-BL_SIT1602BI | 1 | OT201624MJBA4SL | YXC(扬兴晶振) | LCSC | C725986
37 | 4.7K | R26,R32,R17,R25,R24,R45,R46 | R0201 | 7 | 0201WMF1002TEE | UNI-ROYAL(厚声) | LCSC
38 | BH1750FVI-TR | U52 | WSOF-6_L2.6-W1.6-P0.50-TL-EP | 1 | BH1750FVI-TR | ROHM(罗姆) | LCSC | C78960
39 | touch | CH1,CH2,CH3,CH1,CH2,CH3,U21,U22,U24,U38,U39,U41 | touch | 12
40 | PT2051AD4 | U14,U4,U5,U12,U13,U16,U25,U26,U28,U42,U43,U45 | DFN-4_L1.0-W1.0-P0.65-BL-EP-A | 12 | PT2051AD4 | PinTENG(品腾) | LCSC | C2914243
41 | 10PF | C28,C12,C19,C21,C30,C32,C39,C40,C43,C58,C59,C65 | C0201 | 12 | GRM033R61E104KE14D | muRata(村田) | LCSC
42 | 2K | R16,R6,R11,R18,R20,R21,R28,R29,R30,R43,R44,R47 | R0201 | 12 | 0201WMF1002TEE | UNI-ROYAL(厚声) | LCSC
43 | 100nF | C34,C54 | C0402 | 2 | CL05B104KO5NNNC | SAMSUNG(三星) | LCSC | C1525
44 | T3C4QR | SW2,SW4 | SW-SMD_L3.0-W2.0-LS3.5 | 2 | T3C4QR | Diptronics(圜达) | LCSC | C483795
45 | XL-1010RGBC-2812B | U17,U36 | LED-SMD_4P-L1.0-W1.0-TL_XL-1010RGBC-WS2812B | 2 | XL-1010RGBC-2812B | XINGLIGHT(成兴光) | LCSC | C5349953
46 | ANT3216LL00R2400A | U18,U37 | ANT-SMD_L3.2-W1.6 | 2 | ANT3216LL00R2400A | YAGEO(国巨) | LCSC | C293767
47 | LSM6DSOXTR | U23,U40 | LGA-14L_L3.0-W2.5-P0.50-TL | 2 | LSM6DSOXTR | ST(意法半导体) | LCSC | C481766
48 | CH582F | U27,U44 | QFN-28_L4.0-W4.0-P0.40-BL-EP2.8 | 2 | CH582F | WCH(南京沁恒) | LCSC | C3001175
49 | 1UF | C44,C47,C48,C66,C69,C70 | C0201 | 6 | GRM033R61E104KE14D | muRata(村田) | LCSC
50 | 32MHz | X4,X1 | CRYSTAL-SMD_4P-L2.0-W1.6-BL | 2 | XL7EL89CKI-111YLC-32M | YXC(扬兴晶振) | LCSC | C2965582
51 | 32.768kHz | X3,X2 | OSC-SMD_L3.2-W1.5 | 2 | X321532768KGD2SI | YXC(扬兴晶振) | LCSC | C620155
52 | 10uH | L3,L2 | L0603 | 2 | XRTC160808S100MBCA | XR(祥如) | LCSC | C39846679
53 | MG6228D4-33 | U29,U46 | DFN-4_L1.0-W1.0-P0.65-BL-EP | 2 | MG6228D4-33 | Megain(美佳音) | LCSC | C48678124
54 | WAFER-MX1.25-3PWB | U31,U48 | CONN-SMD_3P-P1.25_WAFER-MX1.25-3PWB | 2 | WAFER-MX1.25-3PWB | XUNPU(讯普) | LCSC | C3029360
55 | HC-FPC-05-09-6RLTAG | FPC3 | FPC-SMD_6P-P0.50_HC-FPC-05-09-6RLTAG | 1 | HC-FPC-05-09-6RLTAG | HCTL(华灿天禄) | LCSC | C5213748
56 | F0502-B-24-10G-R | FPC4 | FPC-SMD_F0502-B-24-10G-R | 1 | F0502-B-24-10G-R | XFCN(兴飞) | LCSC | C512913
57 | 10K | R34,R39 | R0603 | 2
58 | 10R | R35,R41 | R0603 | 2
59 | FPC10-S1.0-10AH2.5 | U35 | FPC-SMD_10P-P1.00_XYECONN_FPC10-S1.0-10AH2.5 | 1 | FPC10-S1.0-10AH2.5 | XYECONN(辛译) | LCSC | C19269874
60 | 4.7K | R36,R37 | R0402 | 2 | 0402WGF1002TCE | UNI-ROYAL(厚声) | LCSC
61 | 1K | R38,R40 | R0603 | 2
62 | 100nF | C51,C53 | C0603 | 2
63 | S8050_SOT_NPN | Q1,Q2 | S8050_SOT-23 | 2
64 | 5050701422 | CN15 | CONN-SMD_14P-P0.35_5050701422 | 1 | 5050701422 | MOLEX | LCSC | C6071717
