kemomi/Btai-AR/眼镜板子/眼镜板子/右镜腿小板V1.1_右镜腿小板/BOM_右镜腿小板V1.1_右镜腿小板_2026-10-14.xlsx

No. | Quantity | Comment | Designator | Footprint | Value | Manufacturer Part | Manufacturer | Supplier Part | Supplier | Add into BOM | Convert to PCB | 3D Model Title | Device | Name | Symbol | Unique ID | Category | Primary Category | Secondary Category | Category3 | Category4 | Category5 | Pin Count | drawing:Y Region Count | drawing:X Region Count | drawing:Width | drawing:Version | drawing:Title Block Position | drawing:Title Block | drawing:Symbol | drawing:Size | drawing:Reviewed | drawing:Region Start | drawing:Part Number | drawing:Page Size | drawing:Name | drawing:Height | drawing:Footprint | drawing:Drawed | drawing:Description | drawing:Device | drawing:Company | drawing:Color | drawing:Border | drawing:Blade Width
1 | 5 | 100nF | C1,C2,C8,C17,C18 | C0201 | 100nF | GRM033R61E104KE14D | muRata(村田) | C76939 | LCSC | yes |  | C0201_L0.6-W0.3-H0.3 | GRM033R61E104KE14D | 100nF |  | gge14786,gge14787,gge14806,gge14808,gge14810 |  |  |  |  |  |  | 2
2 | 2 | 33NF | C23,C24 | C0201 | 33NF | GRM033R61E104KE14D | muRata(村田) |  | LCSC | yes |  | C0201_L0.6-W0.3-H0.3 | GRM033R61E104KE14D | 33NF |  | gge14794,gge14795 |  |  |  |  |  |  | 2
3 | 1 | 10UF | C25 | C0402 | 10UF | CL05B104KO5NNNC | SAMSUNG(三星) |  | LCSC | yes |  | C0402_L1.0-W0.5-H0.5 | CL05B104KO5NNNC | 10UF |  | gge14796 |  |  |  |  |  |  | 2
4 | 2 | 22PF | C26,C27 | C0201 | 22PF | GRM033R61E104KE14D | muRata(村田) |  | LCSC | yes |  | C0201_L0.6-W0.3-H0.3 | GRM033R61E104KE14D | 22PF |  | gge14797,gge14798 |  |  |  |  |  |  | 2
5 | 1 | 1UF | C109 | C0402 | 1UF | CL05B104KO5NNNC | SAMSUNG(三星) |  | LCSC | yes |  | C0402_L1.0-W0.5-H0.5 | CL05B104KO5NNNC | 1UF |  | gge422 |  |  |  |  |  |  | 2
6 | 1 | GT-B0354FSV06-16B1202 | CN1 | CONN-SMD_16P-P0.35_GT-B0354FSV06-16B1202 |  | GT-B0354FSV06-16B1202 | G-Switch(品赞) | C53222297 | LCSC | yes |  | CONN-SMD_16P-P0.35_GT-B0354FSV06-16B1202 | GT-B0354FSV06-16B1202 | GT-B0354FSV06-16B1202 |  | gge14891 |  |  |  |  |  |  | 22
7 | 3 | GT-B0354FSV06-06B1202 | CN2,CN3,CN5 | CONN-SMD_6P-P0.35_GT-B0354FSV06-06B1202 |  | GT-B0354FSV06-06B1202 | G-Switch(品赞) | C53222295 | LCSC | yes |  | CONN-SMD_6P-P0.35_2153600064 | GT-B0354FSV06-06B1202 | GT-B0354FSV06-06B1202 |  | gge14894,gge14894_0,gge14894_1 |  |  |  |  |  |  | 12
8 | 3 | PESD3V3Z1BSFYL-ES | D1,D2,D4 | WLCSP-2_L0.6-W0.3-BI |  | PESD3V3Z1BSFYL-ES | ElecSuper(静芯) | C22464605 | LCSC | yes |  | WLCSP-2_L0.6-W0.3-BI | PESD3V3Z1BSFYL-ES | PESD3V3Z1BSFYL-ES |  | gge14731,gge14731_0,gge14731_1 |  |  |  |  |  |  | 2
9 | 1 | 10uH | L1 | L0603 | 10uH | SLM1608100MIT | Sunltech(顺磁) | C2831366 | LCSC | yes |  | L0603_L1.6-W0.8-H0.5_BEAD | SLM1608100MIT | 10uH |  | gge14801 |  |  |  |  |  |  | 2
10 | 2 | 2.2K | R1,R2 | R0201 | 2.2K | 0201WMF1002TEE | UNI-ROYAL(厚声) |  | LCSC | yes |  | R0201_L0.6-W0.3-H0.3 | 0201WMF1002TEE | 2.2K |  | gge423,gge424 |  |  |  |  |  |  | 2
11 | 3 | 10kΩ | R3,R4,R8 | R0201 | 10kΩ | 0201WMF1002TEE | UNI-ROYAL(厚声) | C473048 | LCSC | yes |  | R0201_L0.6-W0.3-H0.3 | 0201WMF1002TEE | 10kΩ |  | gge14805,gge14807,gge14809 |  |  |  |  |  |  | 2
12 | 2 | 47K | R12,R13 | R0201 | 47K | 0201WMF1002TEE | UNI-ROYAL(厚声) |  | LCSC | yes |  | R0201_L0.6-W0.3-H0.3 | 0201WMF1002TEE | 47K |  | gge14792,gge14793 |  |  |  |  |  |  | 2
13 | 1 | 0R | R14 | R0201 | 0R | 0201WMF1002TEE | UNI-ROYAL(厚声) |  | LCSC | yes |  | R0201_L0.6-W0.3-H0.3 | 0201WMF1002TEE | 0R |  | gge14799 |  |  |  |  |  |  | 2
14 | 1 | 10K | R15 | R0201 | 10K | 0201WMF1002TEE | UNI-ROYAL(厚声) |  | LCSC | yes |  | R0201_L0.6-W0.3-H0.3 | 0201WMF1002TEE | 10K |  | gge14800 |  |  |  |  |  |  | 2
15 | 3 | TCF3QR | SW1,SW2,SW3 | KEY-SMD_TCF3QR |  | TCF3QR | Diptronics(圜达) | C495937 | LCSC | yes |  | KEY-SMD_TCF3QR | TCF3QR | TCF3QR |  | gge14895,gge14896,gge14897 |  |  |  |  |  |  | 3
16 | 2 | BW0031AG-L3.5W1.0H3.0 | U1,U2 | ANT-SMD_L3.5-W1.0_BW0031AG |  | BW0031AG-L3.5W1.0H3.0 | BAT WIRELESS(蝙蝠无线) | C2826528 | LCSC | yes |  | ANT-SMD_L3.5-W1.0_BW0031AG | BW0031AG-L3.5W1.0H3.0 | BW0031AG-L3.5W1.0H3.0 |  | gge14892,gge14893 |  |  |  |  |  |  | 1
17 | 1 | XTP2038-180AD1CT | U18 | UDFN-4_L1.0-W1.0-P0.65-TL |  | XTP2038-180AD1CT | XTX(芯天下) | C7422344 | LCSC | yes |  | UDFN-4_L1.0-W1.0-P0.65-TL | XTP2038-300AD1CT | XTP2038-180AD1CT |  | gge12_4 |  |  |  |  |  |  | 5
18 | 1 | DRV2605YZFR | U77 | DSBGA-9_L1.5-W1.5-R3-C3-P0.50-BL |  | DRV2605YZFR | TI(德州仪器) | C81079 | LCSC | yes |  | DSBGA-9_L1.5-W1.5-H0.6-R3-C3-P0.50-BL | DRV2605YZFR | DRV2605YZFR |  | gge418 |  |  |  |  |  |  | 8
19 | 1 | AW8010AFCR | U102 | FC-9_L1.5-W1.5-R3-C3-P0.50-BL |  | AW8010AFCR | AWINIC(艾为) | C164085 | LCSC | yes |  | FC-9_L1.5-W1.5-H0.55-R3-C3-P0.51-BL | AW8010AFCR | AW8010AFCR |  | gge14711 |  |  |  |  |  |  | 9
