kemomi/Btai-AR/3D模型/右镜腿V1.5.STEP

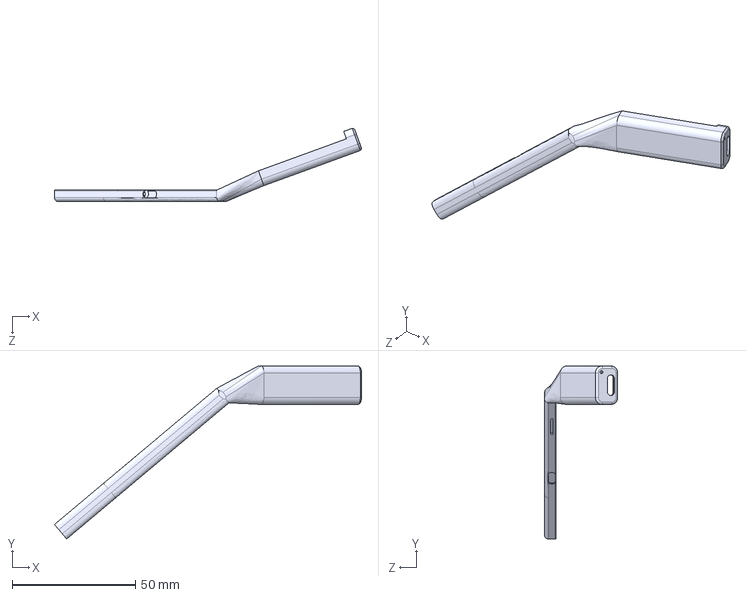
[picture p1: CAD file, 2026-10-20]
3D模型/右镜腿V1.5.STEP
124.7 x 70.3 x 29.8 mm
