kemomi/Btai-AR/3D模型/左镜腿V1.5.STEP

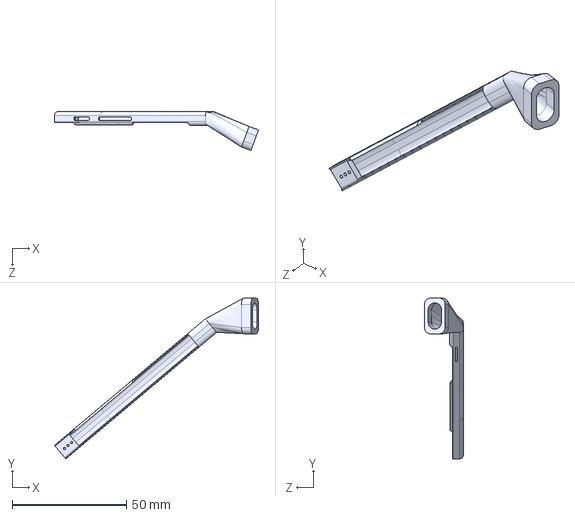
[picture p2: CAD file, 2026-10-20]
3D模型/左镜腿V1.5.STEP
89.2 x 70.3 x 17.1 mm
