kemomi/Btai-AR/3D模型/右镜腿盖V1.6.STEP

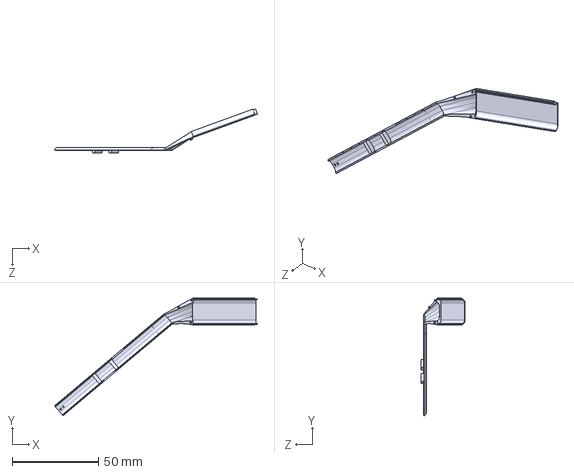
[picture p3: CAD file, 2026-10-20]
3D模型/右镜腿盖V1.6.STEP
117.8 x 68.3 x 25.7 mm
