kemomi/Btai-AR/3D模型/镜尾电池仓V1.1.STEP

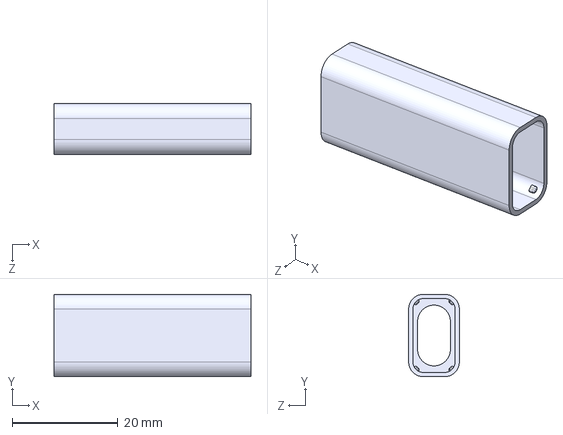
[picture p4: CAD file, 2026-10-20]
3D模型/镜尾电池仓V1.1.STEP
37.3 x 15.6 x 9.60 mm
