kemomi/Btai-AR/3D模型/左镜腿镜盖v1.0.STEP

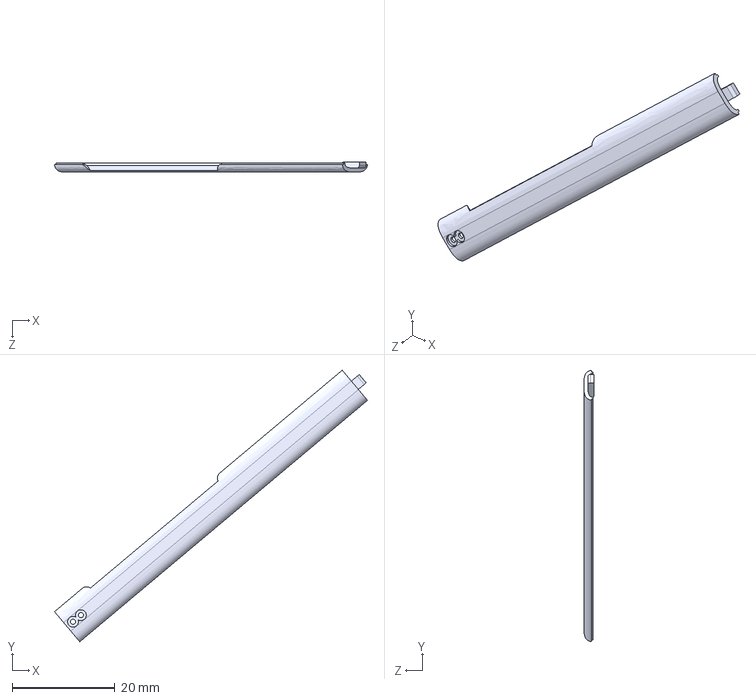
[picture p5: CAD file, 2026-10-20]
3D模型/左镜腿镜盖v1.0.STEP
60.8 x 52.8 x 2.00 mm
