kemomi/Btai-AR/3D模型/滑动按键V1.4.STEP

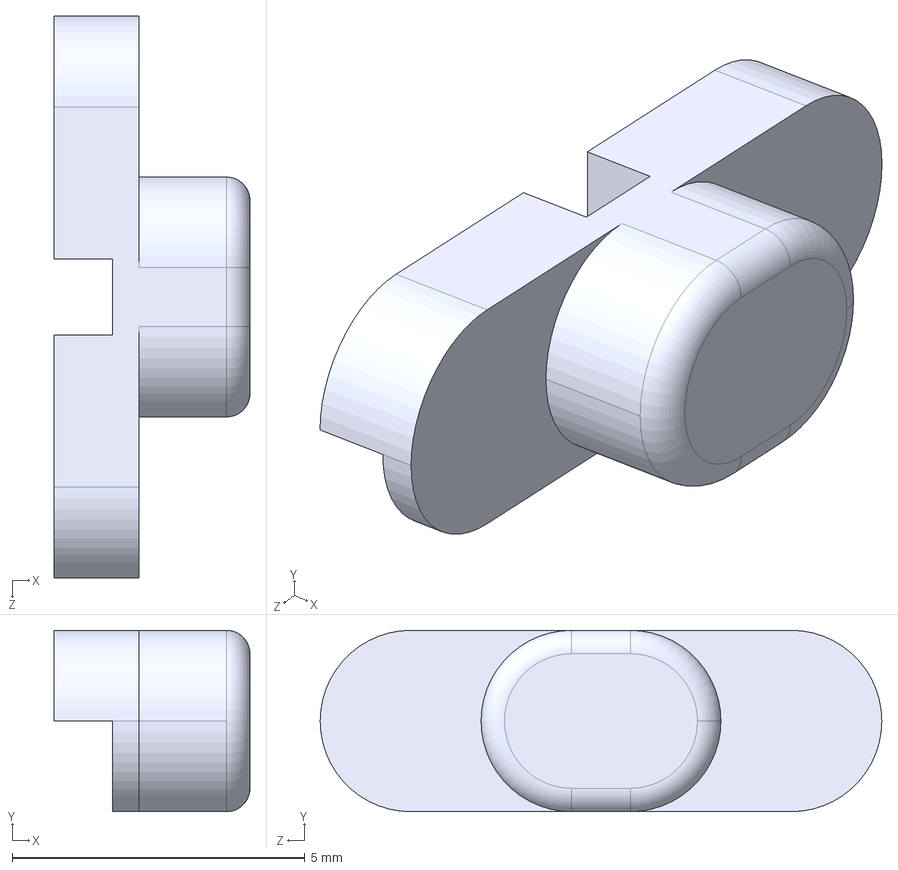
[picture p6: CAD file, 2026-10-20]
3D模型/滑动按键V1.4.STEP
3.35 x 3.10 x 9.60 mm
