kemomi/Btai-AR/3D模型/镜架前框盖.STEP

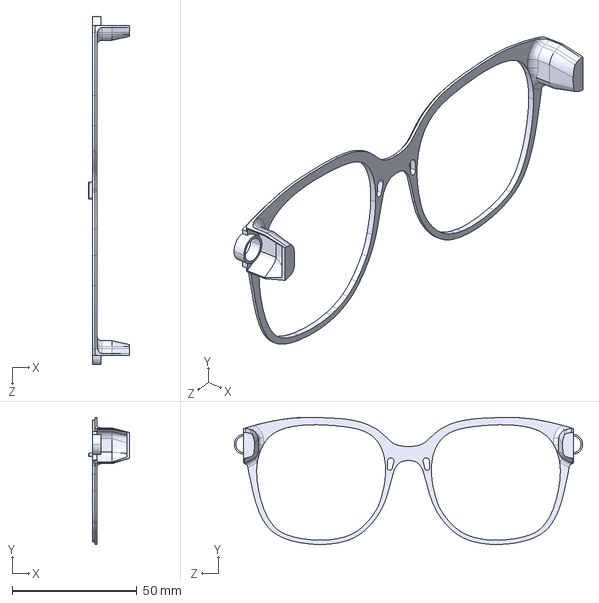
[picture p7: CAD file, 2026-10-20]
3D模型/镜架前框盖.STEP
16.3 x 50.8 x 139.5 mm
