kemomi/Btai-AR/3D模型/电池仓盖V1.1.STEP

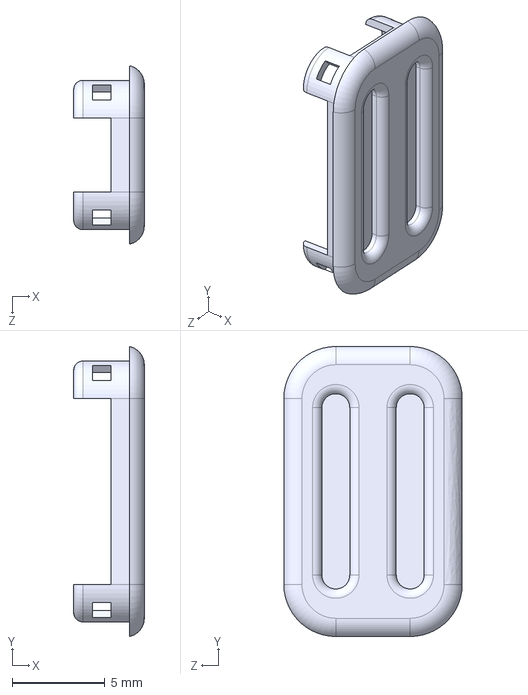
[picture p8: CAD file, 2026-10-20]
3D模型/电池仓盖V1.1.STEP
3.80 x 15.6 x 9.60 mm
