kemomi/Btai-AR/3D模型/镜架前框.STEP

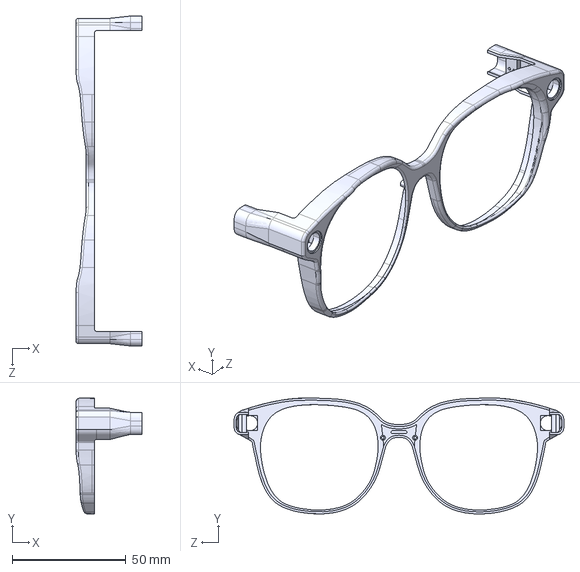
[picture p9: CAD file, 2026-10-20]
3D模型/镜架前框.STEP
28.9 x 50.8 x 144.8 mm
