kemomi/Btai-AR/PDF_光波导AR眼镜_Btai1_PCB/SCH_Schematic11_2026-10-13.pdf

# 1.Microled

1.8V1.8V

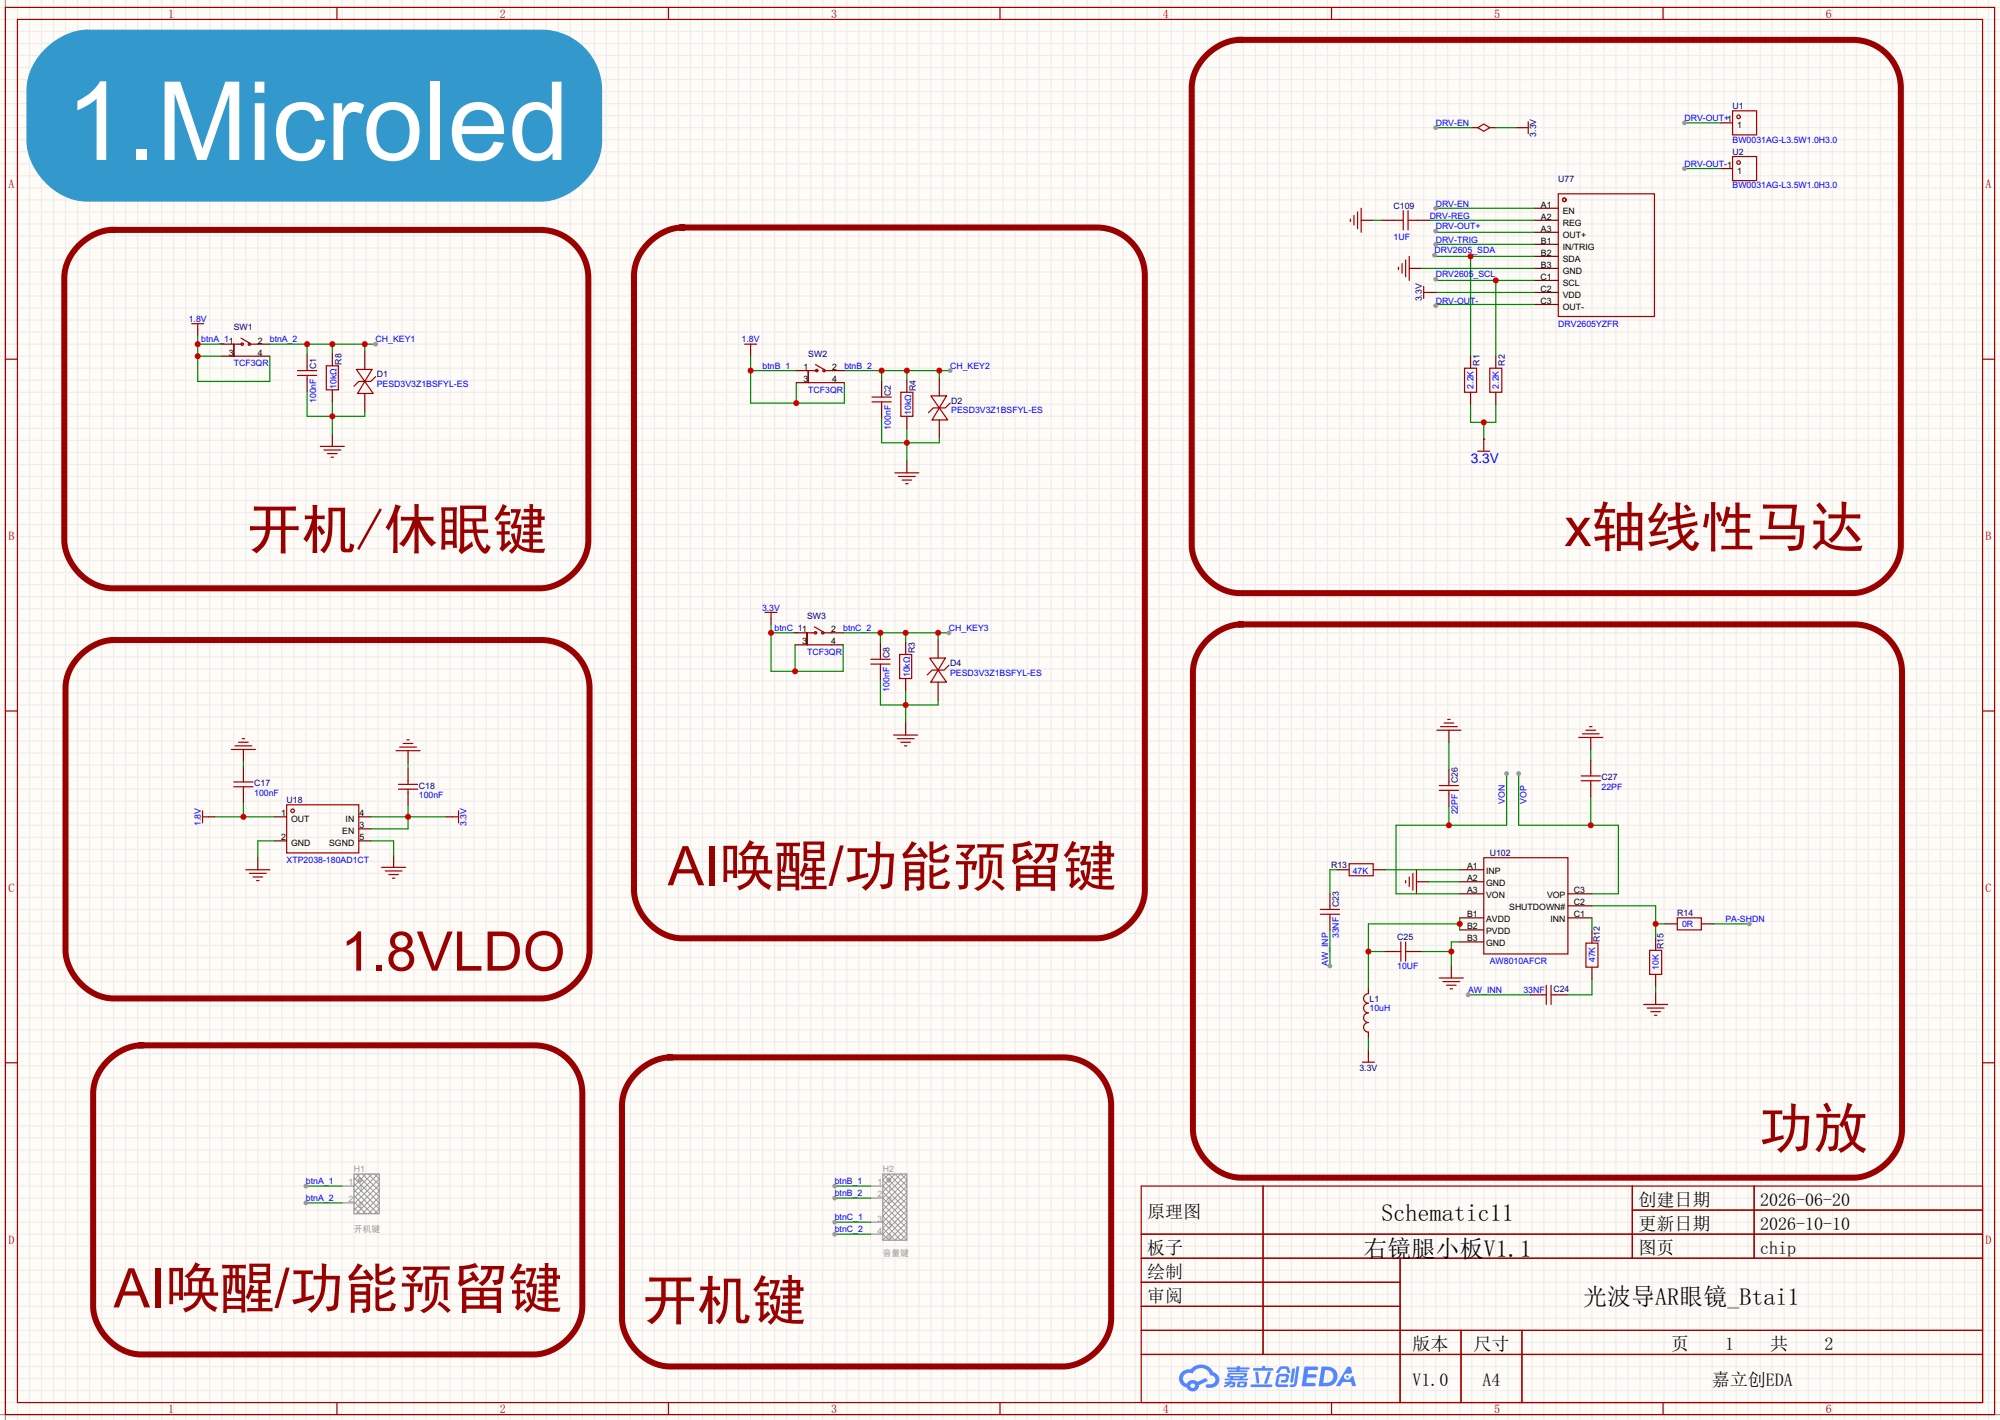
[picture p10: page 1]

DRV-OUT+ | OUT+ A3
DRV-TRIG | IN/TRIG B1
DRV2605_SDA | SDA B2

GND B3

DRV2605_SCL | SCL C1

VDD C2

DRV-OUT-

GND A2
VON A3

AVDD B1
PVDD B2

AW_INN

# 2.连接器

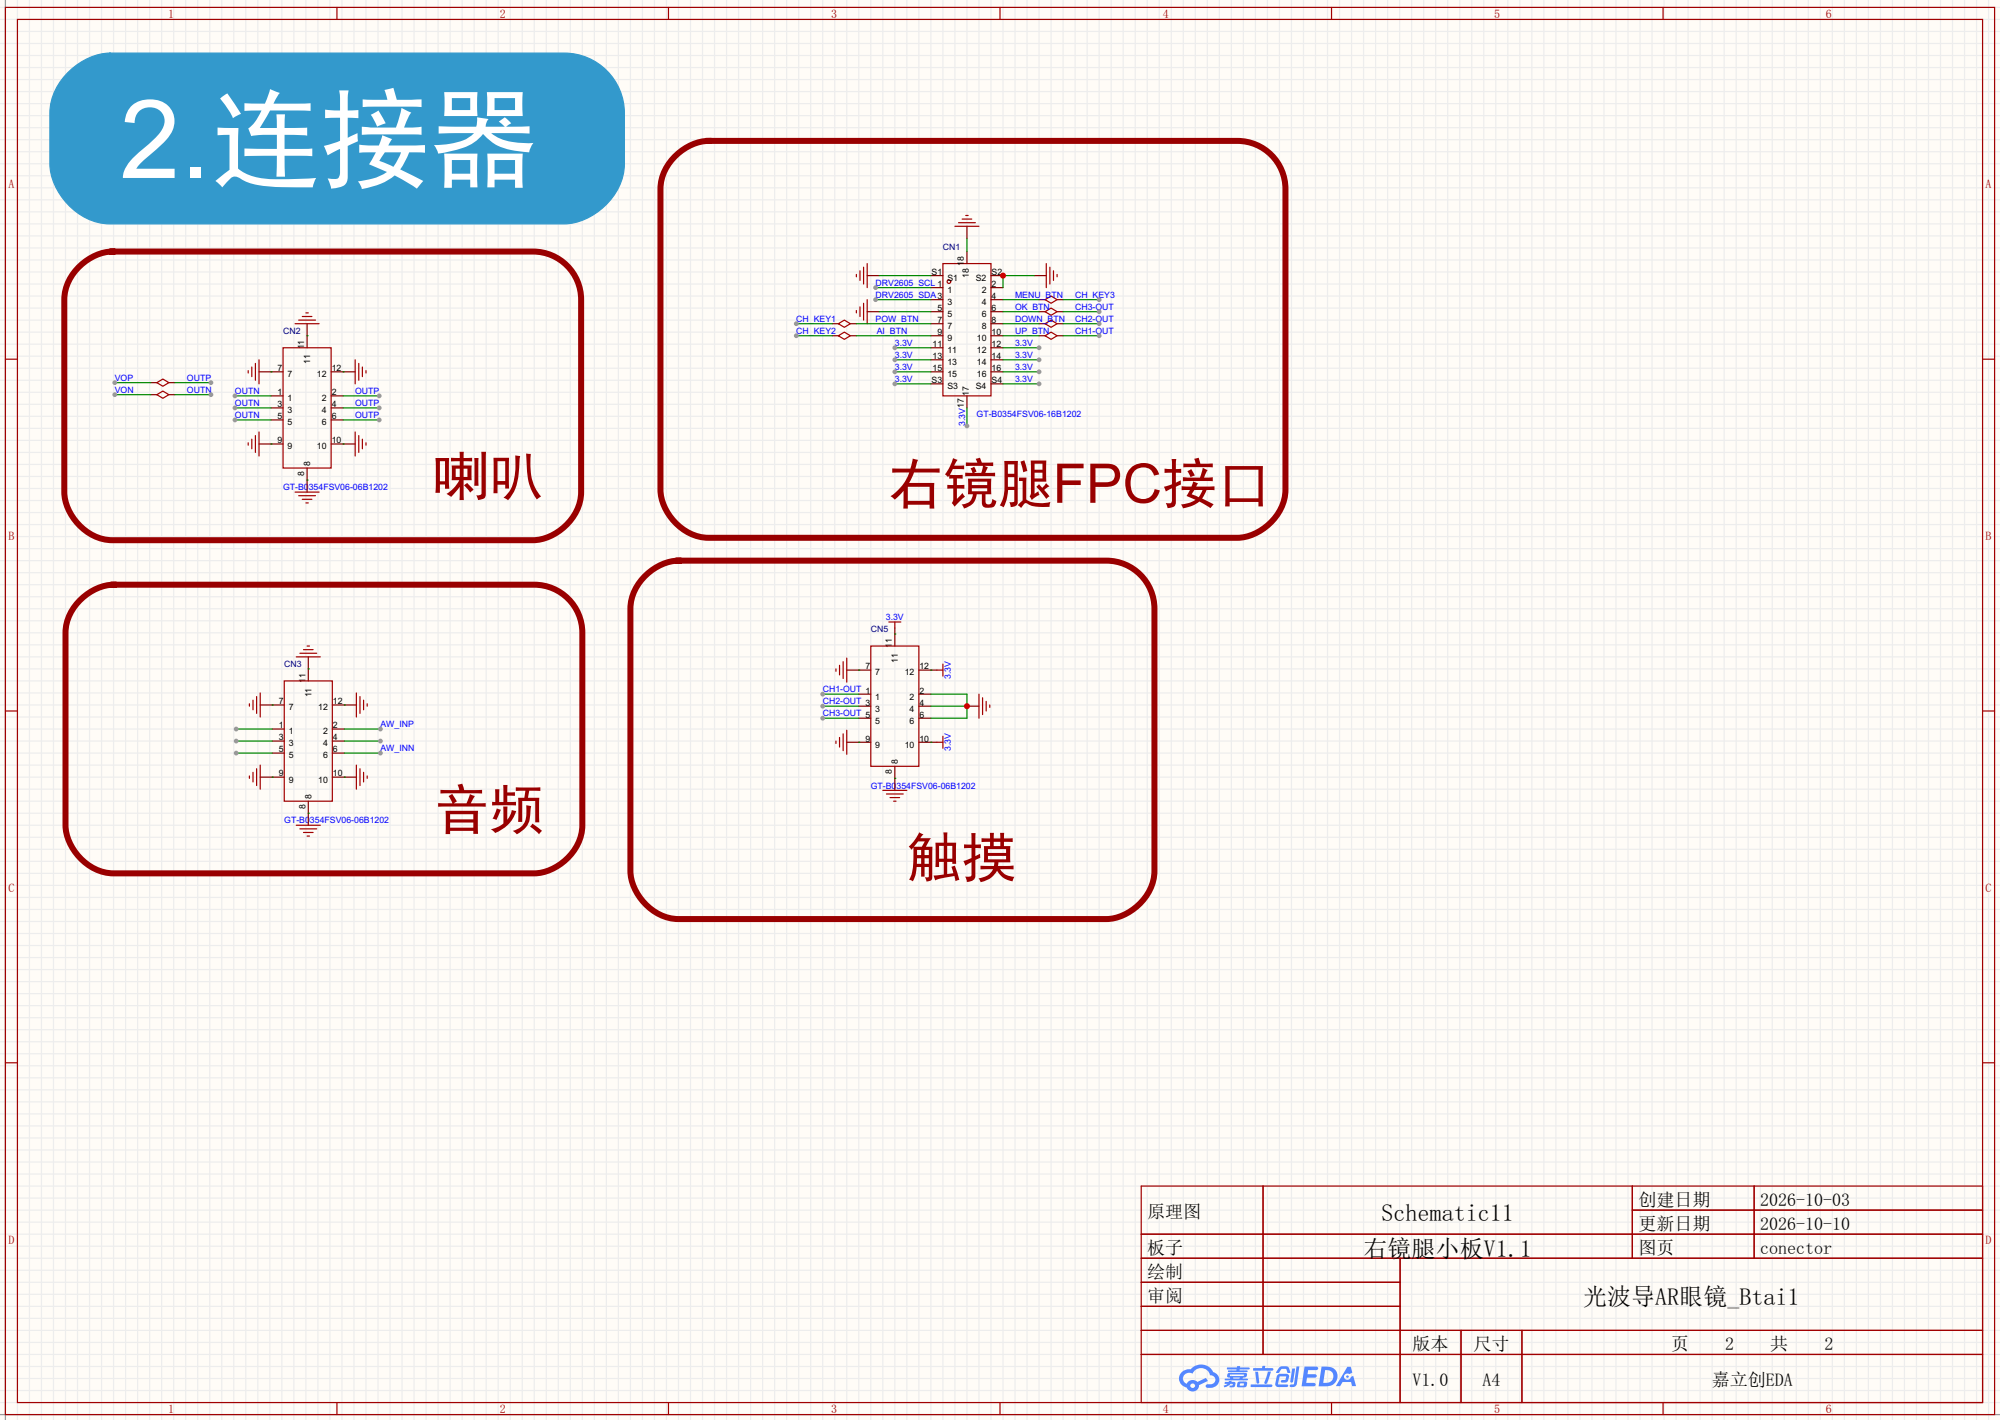
[picture p11: page 2]
