kemomi/Btai-AR/PDF_光波导AR眼镜_Btai1_PCB/SCH_Schematic13_2026-10-13.pdf

# 1.开关/按钮

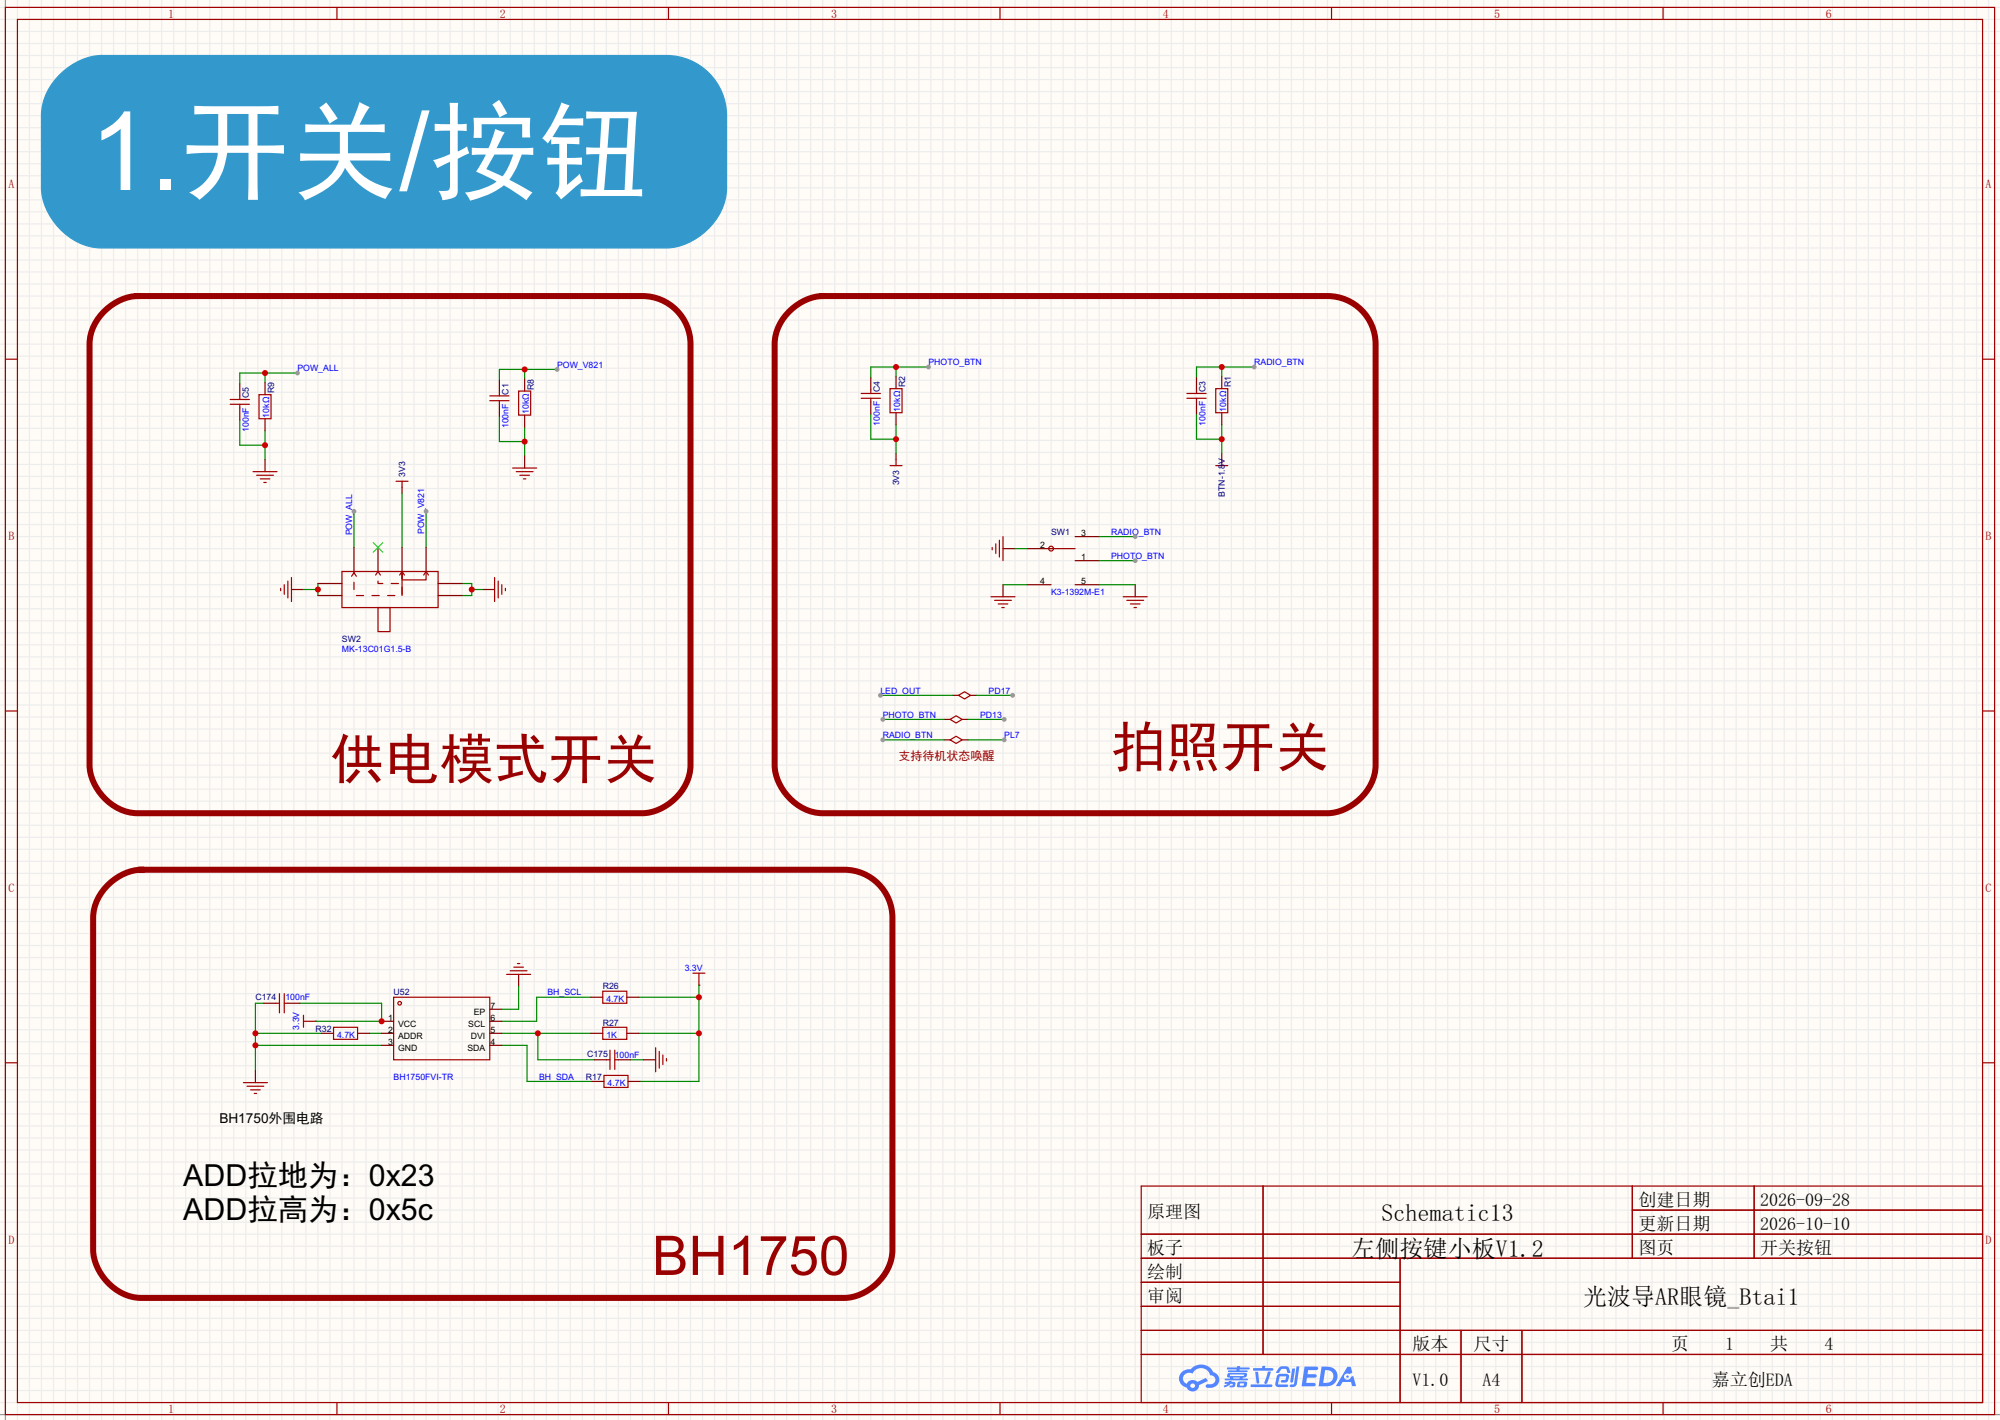
[picture p12: page 1]

喇叭

# 2.conector

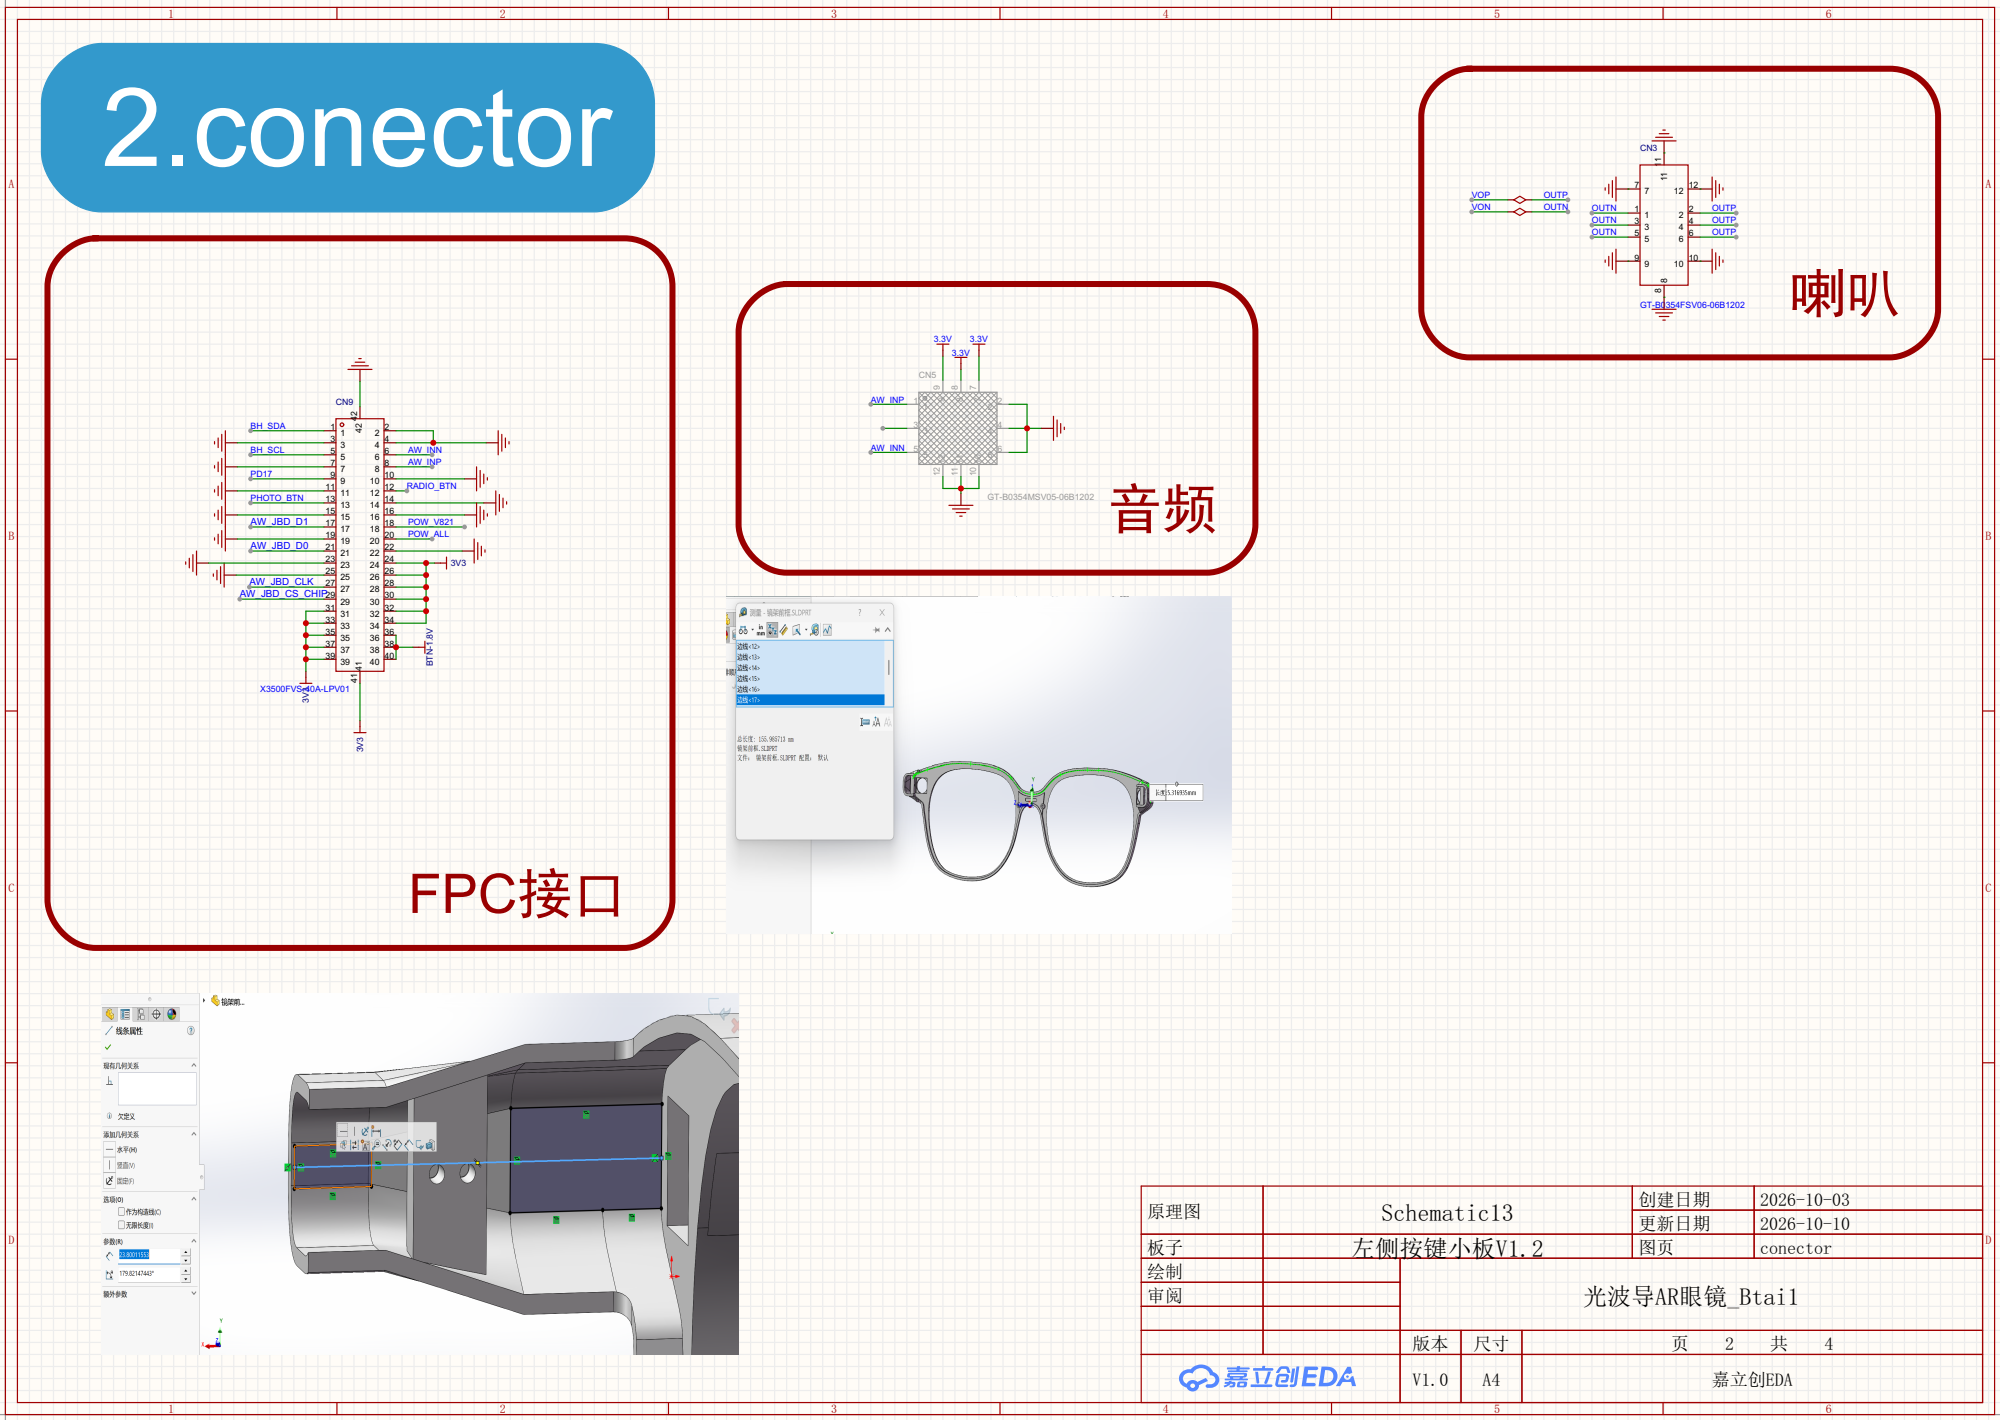
[picture p13: page 2]

BH_SCL | 5 7

PHOTO_BTN

AW_JBD_D1

AW_JBD_D0

# 3.Audio

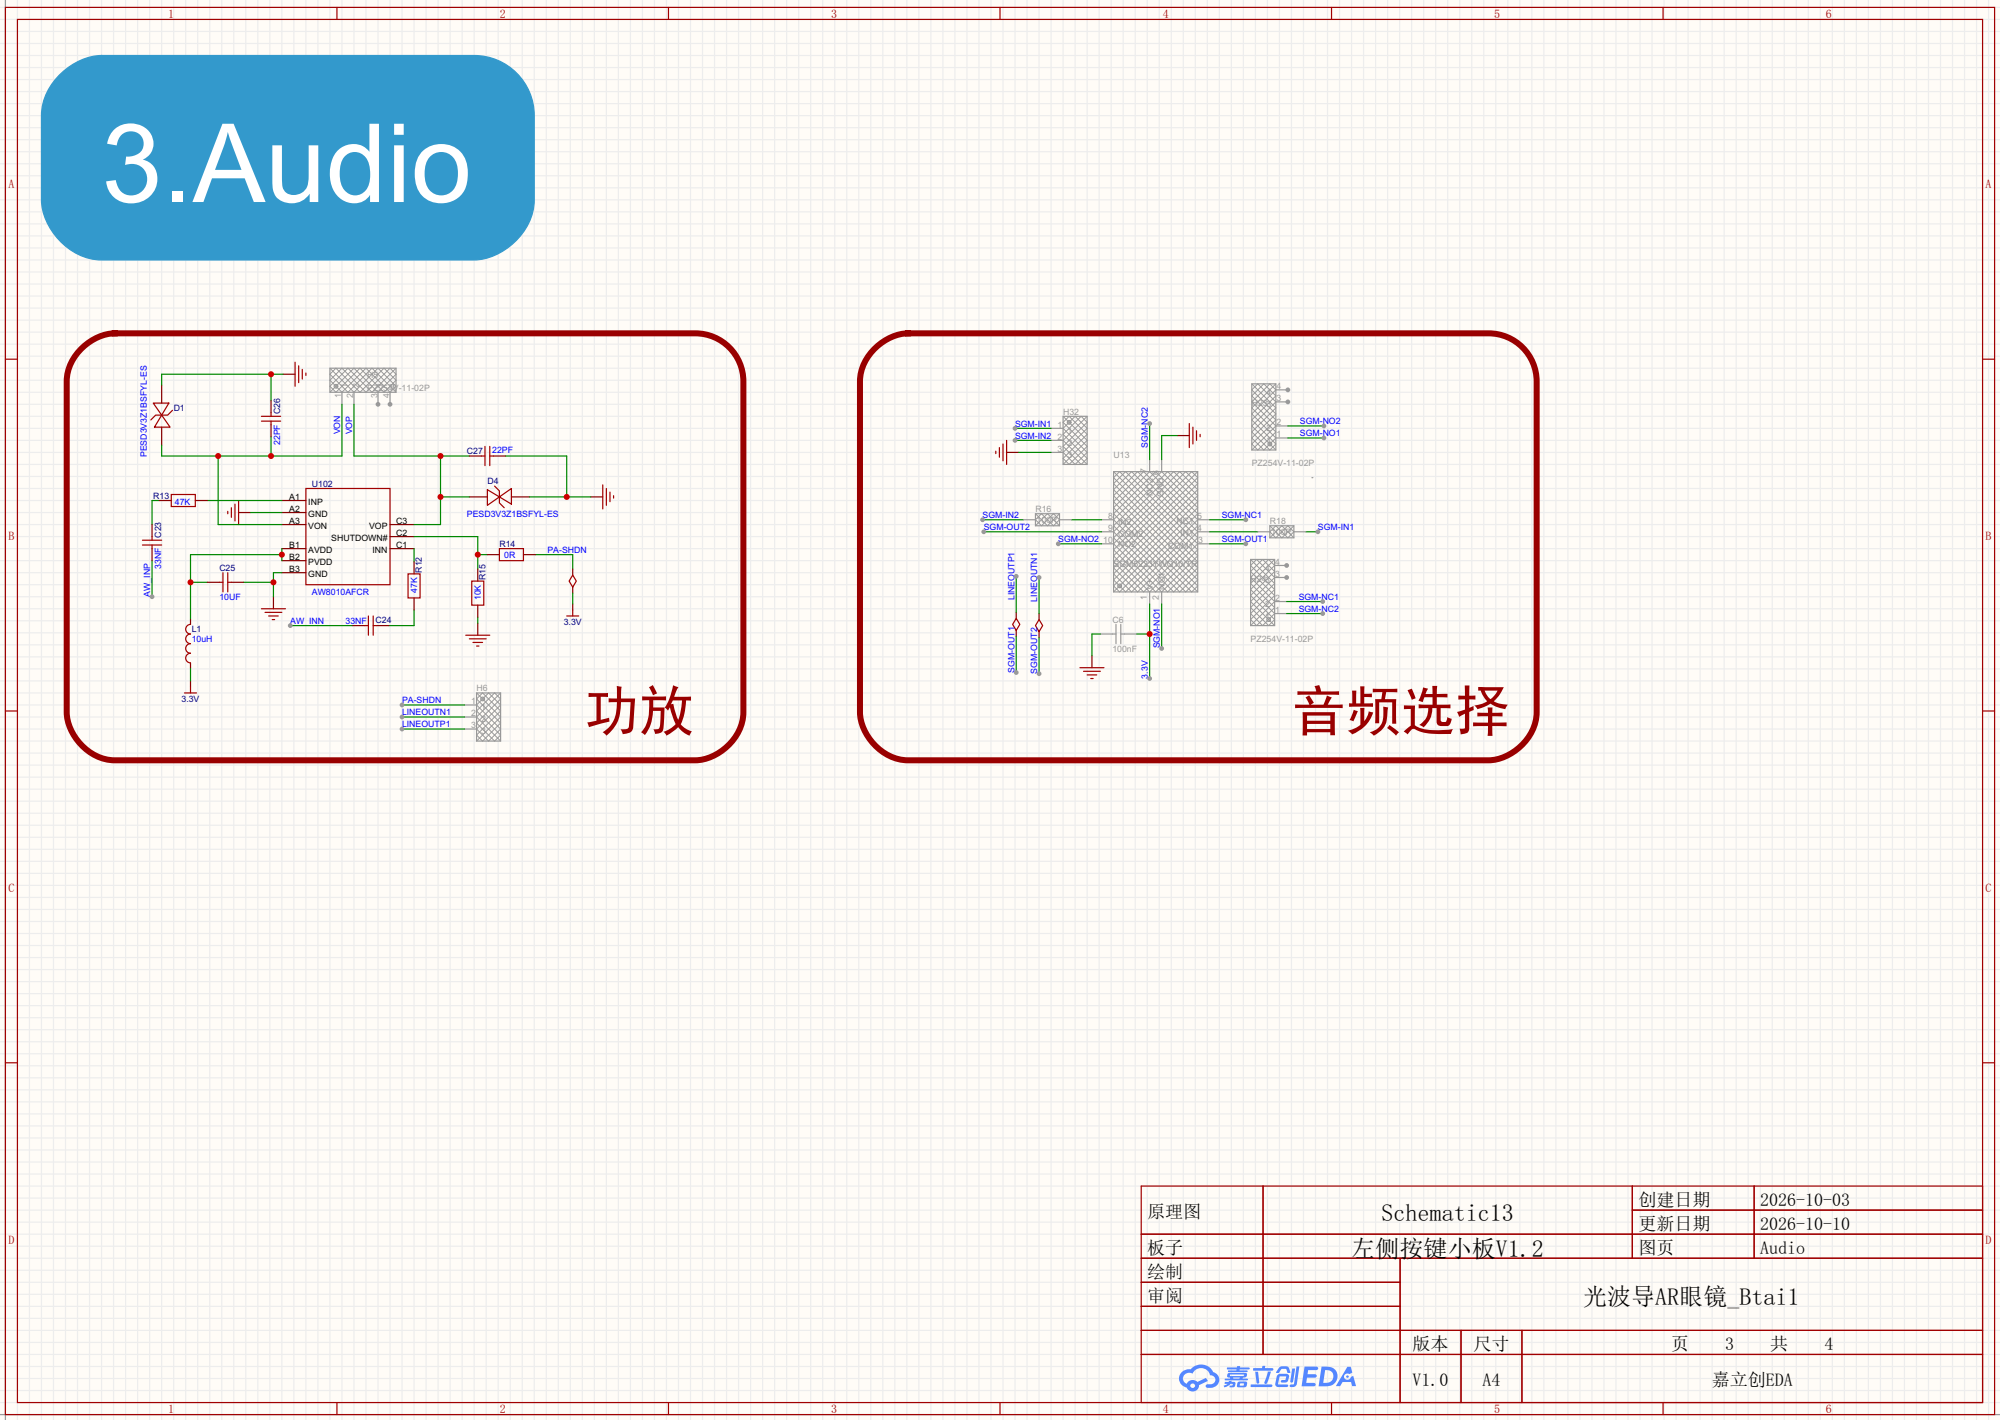
[picture p14: page 3]

2.5V
500MA

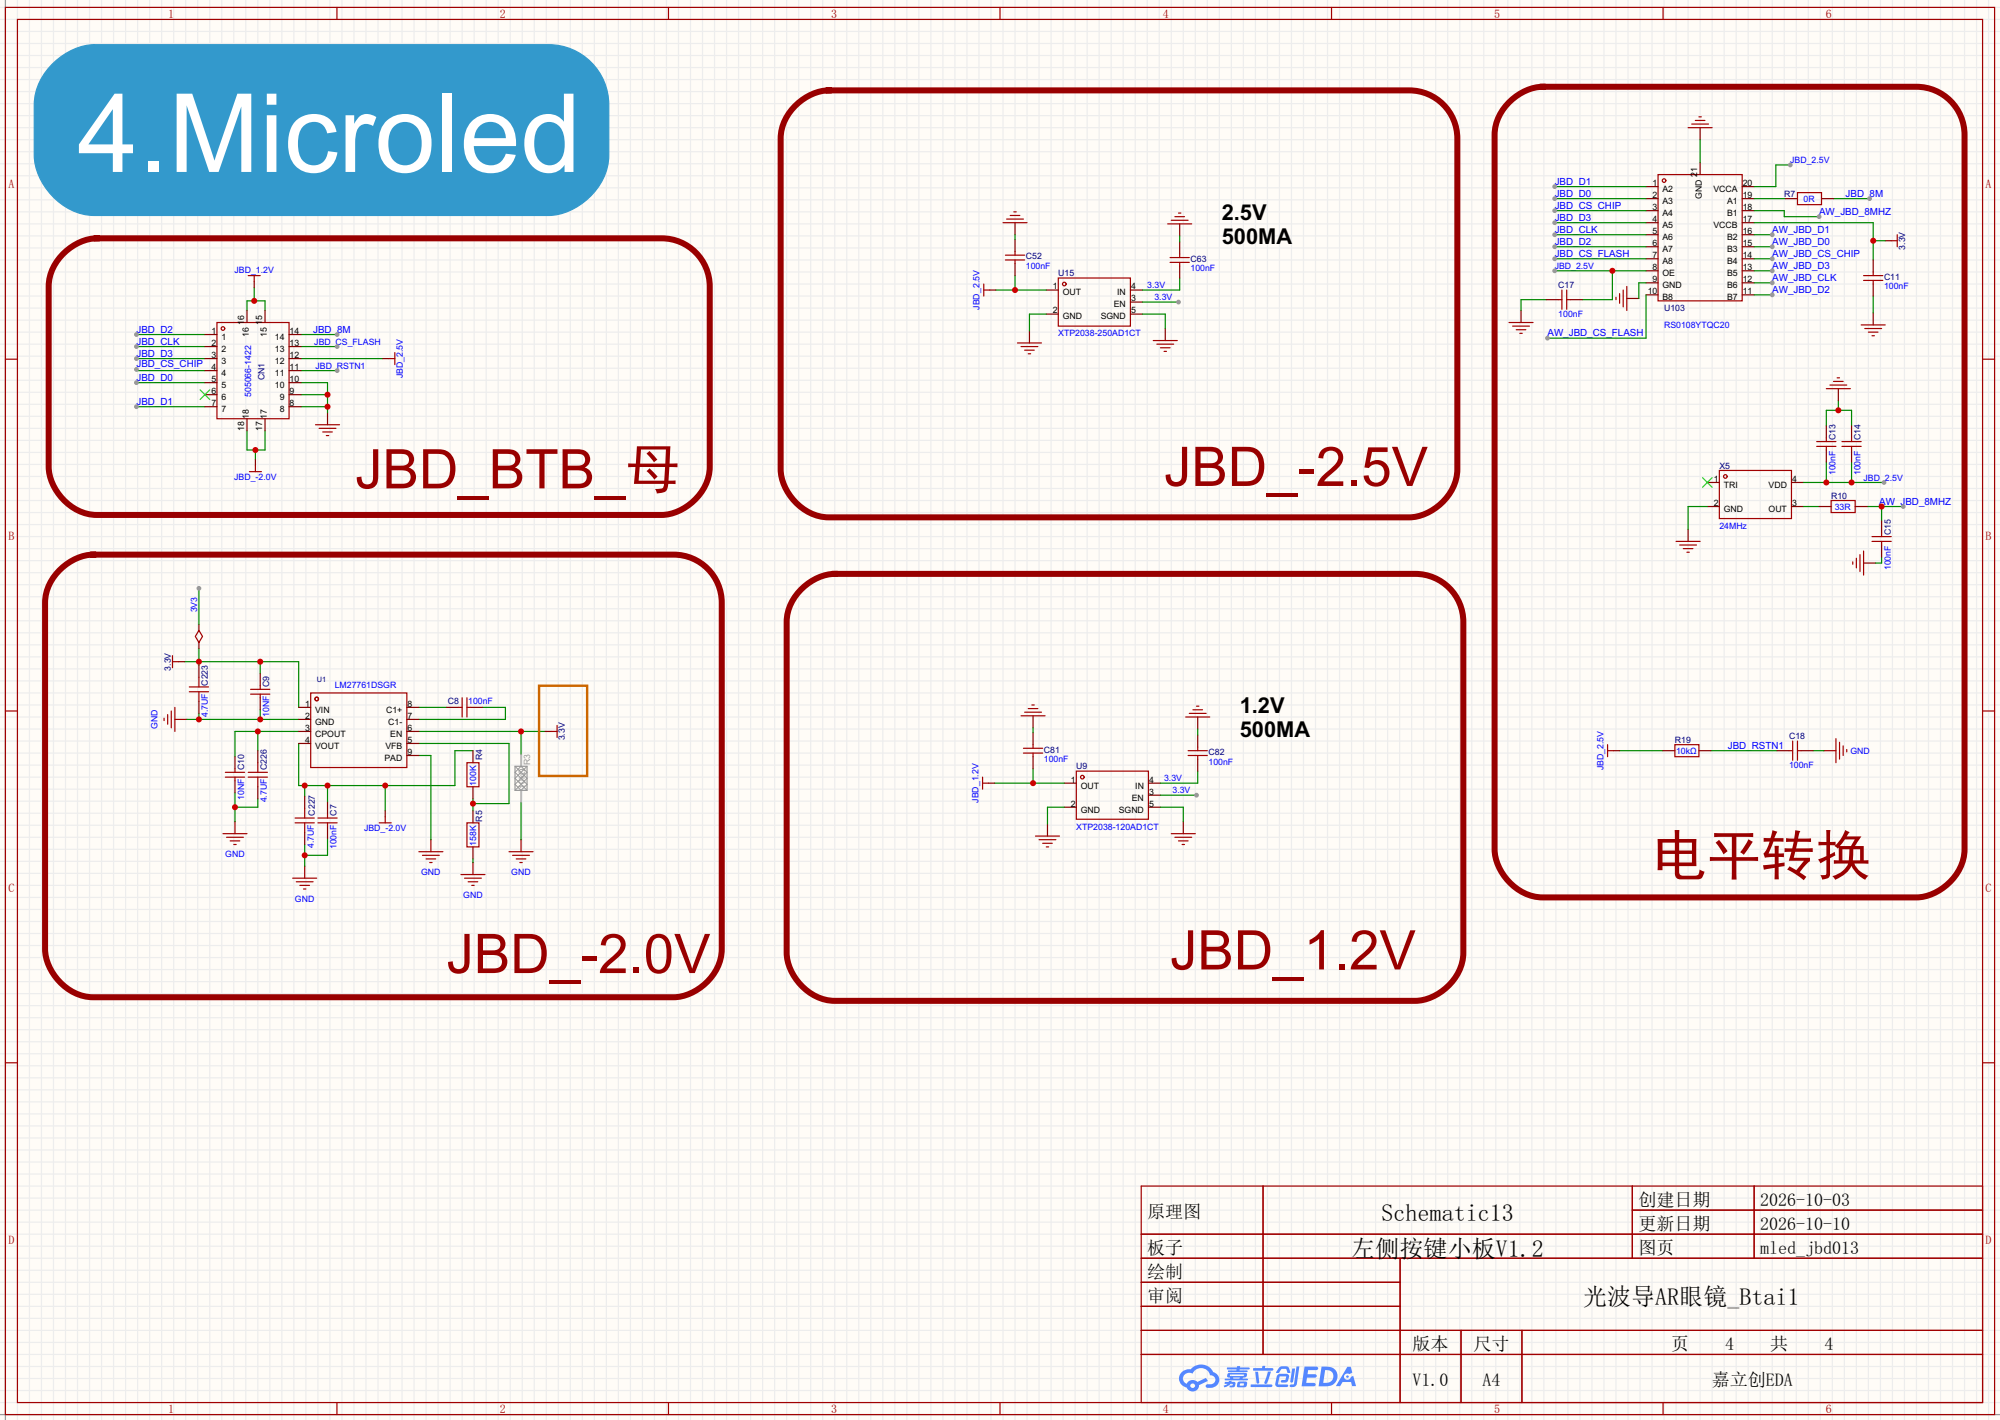
[picture p15: page 4]

JBD_D3
JBD_CLK JBD_D2 JBD_CS_FLASH

JBD_2.5V

VIN 1 GND 2 CPOUT 3 VOUT 4
