kemomi/Btai-AR/PDF_光波导AR眼镜_Btai1_PCB/SCH_Schematic1_1_2026-10-13.pdf

# 1.CPU_V821

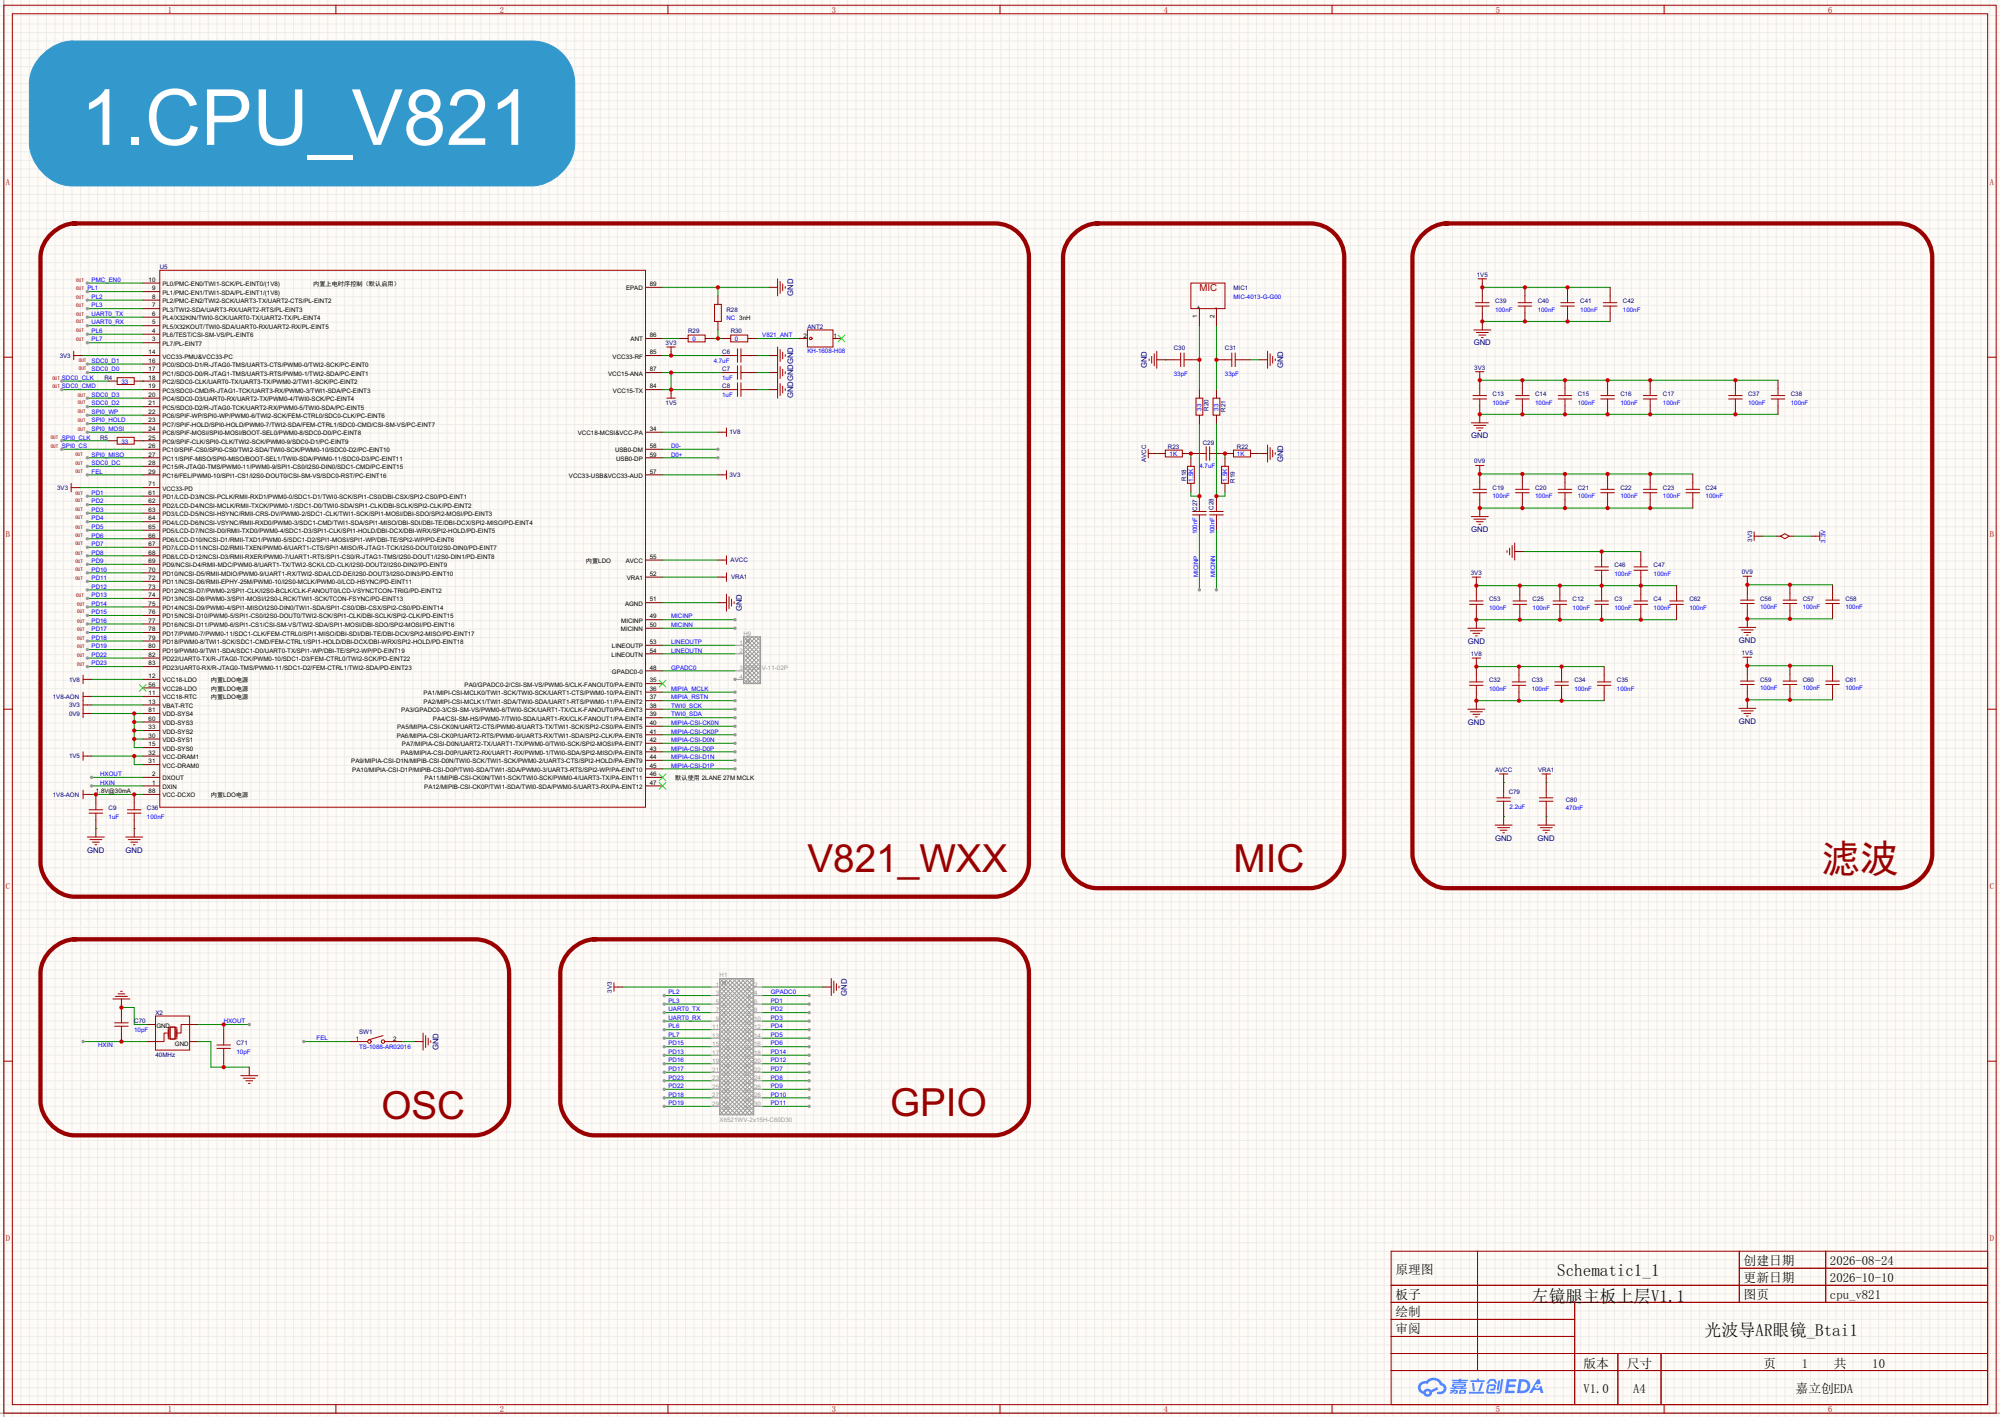
[picture p16: page 1]

OUT | | PMC_EN0 | | | | | | | | | | | | | | | | | | | | | | | 1V5
OUT | | | | | PL0/PMC-EN0/TWI1-SCK/PL-EINT0/(1V8) 10 | 内置上电时序控制（默认启用） | | EPAD | 89 | | | | | | | | | | | | MIC | | MIC1
PL1
PL2 | | | PL2/PMC-EN2/TWI2-SCK/UART3-TX/UART2-CTS/PL-EINT2 8
OUT | | | | | | | | | | | | | | | | | | | | | | | | | | C39 | C40 | C41 | C42
PL3
UART0_TX
UART0_RX
PL6
PL7 | | | PL7/PL-EINT7 3

OUT | | | | | PL1/PMC-EN1/TWI1-SDA/PL-EINT1/(1V8) 9 | | | | | | | | | | | | | | | | | | MIC-4013-G-G00

OUT | | | | | PL3/TWI2-SDA/UART3-RX/UART2-RTS/PL-EINT3 7 | | | | | | | | | | R28 | | | | | | | | | | | 100nF | 100nF | 100nF | 100nF
OUT | | | | | PL4/X32KIN/TWI0-SCK/UART0-TX/UART2-TX/PL-EINT4 6 | | | | | | | | | | NC | 3nH
OUT | | | | | PL5/X32KOUT/TWI0-SDA/UART0-RX/UART2-RX/PL-EINT5 5 | | | | | | R29 | | | | R30 | | | ANT2
OUT | | | | | PL6/TEST/CSI-SM-VS/PL-EINT6 4 | | | ANT | 86 | | | 0 | | | | 0 | V821_ANT | 2 | 1

3V3 | | | | | | | | | | C30 | | C31 | | GND

3V3 | | | | | | | | | VCC33-RF | | 85 | | | | | C6 | | | | KH-1608-H08

OUT | SDC0_D1 | | | | | | | | | | | 4.7uF
OUT | SDC0_D0 | | | | | VCC15-ANA | | 87 | | | | | C7 | | | | | | 33pF | | 33pF | | 3V3

OUT | SDC0_CLK | | | | R4 | 33 | | | | | | | | | | 1uF
OUT | SDC0_CMD | | | | | | | | VCC15-TX | | 84 | | | | | C8

OUT | SDC0_D2 | | | | | | | | 1V5 | | | | | | | | | 100nF | 100nF | 100nF | 100nF | 100nF | 100nF | 100nF
OUT | SPI0_HOLD | | | | | | | | | | | | | 4.7uF ³³R²⁰ 33
OUT | SPI0_WP

OUT | SPI0_MOSI | | | | VCC18-MCSI&VCC-PA | | | 34 | | | 1V8

OUT | SPI0_CLK | | | R5 | 33 | | | | | | | | | | | | | | GND
OUT | SPI0_CS | | | | | | | USB0-DM | | 58 | | D0- | | R23 | | | C29 | R22

OUT | SPI0_MISO | | | | | | USB0-DP | 59 | | D0+ | | | 1K | | | 1K
OUT | SDC0_DC | | | | | | | | | | | | | | | | 0V9

OUT | FEL | | | VCC33-USB&VCC33-AUD | | | | 57 | | | 3V3

OUT | | | | | | | | | | | | | | | | | | | | | | | | 100nF | | | 100nF | | | 100nF | | 100nF | | 100nF | | 100nF
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
PD10
OUT | | | | | | | | | | | | | | | | | | | VRA1GND
PD11
PD12
PD13
OUT | | | | | | | | | | | | | | | AGND | 51 | | | | | | | C53 | | | C25 | | | C12 | | C3 | | C4 | | C62 | | | | C56 | C57 | C58
PD14
OUT | | | | | | | | | | | | | | | | | | | | | | | 100nF | | | 100nF | | | 100nF | | 100nF | | 100nF | | 100nF | | | | 100nF | 100nF | 100nF
PD15
OUT | | | | | | | | | | | | | | MICINP | | 49 | MICINP
PD16
OUT | | | | | | | | | | | | | | MICINN | | 50 | MICINN
PD17
OUT | | | | | | | | | | | | | | | | | | | | | H9
PD18
OUT | | | | | | | | | | | | | LINEOUTP | | | 53 | LINEOUTP | | | 1 | 1 | GND | | | | | | | | | | | | | | | GND
PD19
OUT | | | | | | | | | | | | | LINEOUTN | | | 54 | LINEOUTN | | | 2 | 2 | 1V8 | | | | | | | | | | | | | | | | 1V5
PD22
PD23
OUT | | | | | | | | | | | | | GPADC0-0 | | | 48 | GPADC0 | | | 3 | PZ254V-11-02P
1V8 | | | | | | | 内置LDO电源 | | | | | PA0/GPADC0-2/CSI-SM-VS/PWM0-5/CLK-FANOUT0/PA-EINT0 | | | | | 35 | | | | 4 | 3 4 | | C32 | | | C33 | | | C34 | | C35 | | | | | | | | C59 | C60 | C61

OUT

B | | | OUT | | | | | | | | | | | | | | | | | | | | | | GND | | | | | | | | | | | | | | | | | | | | B

OUT | | | | | | | | | | | | 内置LDO | | | AVCC | 55 | | | AVCC
OUT | | | | | | | | | | | | | | | | | | | | | | | | | | | | | | | C46 | | C47
OUT | | | | | | | | | | | | | | | VRA1 | 52 | | | | | | 3V3 | | | | | | | | | 100nF | | 100nF | | | | | 0V9

VBAT-RTC 13 VCC18-RTC 11 VCC28-LDO 56 VCC18-LDO 12 | 内置LDO电源 | | | | | | | | | | | MIPIA_MCLK | | | | | | 100nF | | | 100nF | | | 100nF | | 100nF | | | | | | | | 100nF | 100nF | 100nF

1V8-AON | | | | | | | | 内置LDO电源 | | | PA1/MIPI-CSI-MCLK0/TWI1-SCK/TWI0-SCK/UART1-CTS/PWM0-10/PA-EINT1 | | | | | | | 36
3V3 | | | | | | | | | | PA2/MIPI-CSI-MCLK1/TWI1-SDA/TWI0-SDA/UART1-RTS/PWM0-11/PA-EINT2 | | | | | | | 37
0V9 | | | | | | | | | PA3/GPADC0-3/CSI-SM-VS/PWM0-6/TWI0-SCK/UART1-TX/CLK-FANOUT0/PA-EINT3 | | | | | | | | 38

MIPIA_RSTN
TWI0_SCK
TWI0_SDA

VDD-SYS0 15 VDD-SYS1 30 VDD-SYS2 33 VDD-SYS3 60 VDD-SYS4 81 | | | PA5/MIPIA-CSI-CK0N/UART2-CTS/PWM0-8/UART3-TX/TWI1-SCK/SPI2-CS0/PA-EINT5 | | PA4/CSI-SM-HS/PWM0-7/TWI0-SDA/UART1-RX/CLK-FANOUT1/PA-EINT4 | | | | | | 39 | | | | | | GND | | | | | | | | | | | | | | | GND

40 | MIPIA-CSI-CK0N
PA6/MIPIA-CSI-CK0P/UART2-RTS/PWM0-9/UART3-RX/TWI1-SDA/SPI2-CLK/PA-EINT6 | | | | | | | | 41
PA7/MIPIA-CSI-D0N/UART2-TX/UART1-TX/PWM0-0/TWI0-SCK/SPI2-MOSI/PA-EINT7 | | | | | | | | 42

MIPIA-CSI-CK0P
MIPIA-CSI-D0N
MIPIA-CSI-D0P
MIPIA-CSI-D1N

1V5 | | | | | | VCC-DRAM0 31 VCC-DRAM1 32 | | | PA8/MIPIA-CSI-D0P/UART2-RX/UART1-RX/PWM0-1/TWI0-SDA/SPI2-MISO/PA-EINT8 | | | | | | | | 43

PA9/MIPIA-CSI-D1N/MIPIB-CSI-D0N/TWI0-SCK/TWI1-SCK/PWM0-2/UART3-CTS/SPI2-HOLD/PA-EINT9 PA10/MIPIA-CSI-D1P/MIPIB-CSI-D0P/TWI0-SDA/TWI1-SDA/PWM0-3/UART3-RTS/SPI2-WP/PA-EINT10 | | | | | | | | | 44
45 | MIPIA-CSI-D1P

HXOUT | | | | | | | | | | | | | | | | | | | | | | AVCC | | | VRA1
HXIN
1.8V@30mA

DXOUT 2 | | | | PA11/MIPIB-CSI-CK0N/TWI1-SCK/TWI0-SCK/PWM0-4/UART3-TX/PA-EINT11 | | | | | | | 46 | | 默认使用 2LANE 27M MCLK
VCC-DCXO 88 DXIN 1 | | | | PA12/MIPIB-CSI-CK0P/TWI1-SDA/TWI0-SDA/PWM0-5/UART3-RX/PA-EINT12 | | | | | | | 47

1V8-AON | | | | | | | | 内置LDO电源 | | | | | | | | | | | | | | | | | | | C79 | | | C80

C9 | C36 | | | | | | | | | | | | | | | | | | | | | 2.2uF | | | 470nF
1uF | 100nF

GND | GND

H1

PL2 | 3 | 1 | 2 | 4 | GPADC0
PL3 | 5 | 3 | 4 | 6 | PD1

X2 | | | | | | | | UART0_TX | 7 | 5 | 6 | 8 | PD2
C70 | | | HXOUT | | | | | | UART0_RX | 9 | 7 | 8 10 | 10 | PD3

PL6 | | 9 11 11 | 12 | 12 | PD4
PD18 | | 27 27 | 28 | 28 | PD10 | GPIO
PD22 | | 25 25 | 26 | 26 | PD9

FEL | SW1 1 | | 2 | PL7 | | 13 13 | 14 | 14 | PD5
OSC | | PD19 | | 29 29 | 30 | 30 | PD11

HXIN | | | | | | | TS-1088-AR02016

GND | | C71 | | | | | PD15 | | | | | PD6
40MHz | | | 10pF | | | | | PD13 | | 17 17 | 18 16 | 18 15 15 16 | PD14

PD16 | | 19 19 | 20 | 20 | PD12
PD17 | | 21 21 | 22 | 22 | PD7
PD23 | | 23 23 | 24 | 24 | PD8

创建日期 | 2026-08-24
更新日期 | 2026-10-10

板子 | 左镜腿主板上层V1.1 | | 图页 | cpu_v821
绘制
审阅 | | 光波导AR眼镜_Btai1

### GND

# 2.Emmc/Flash

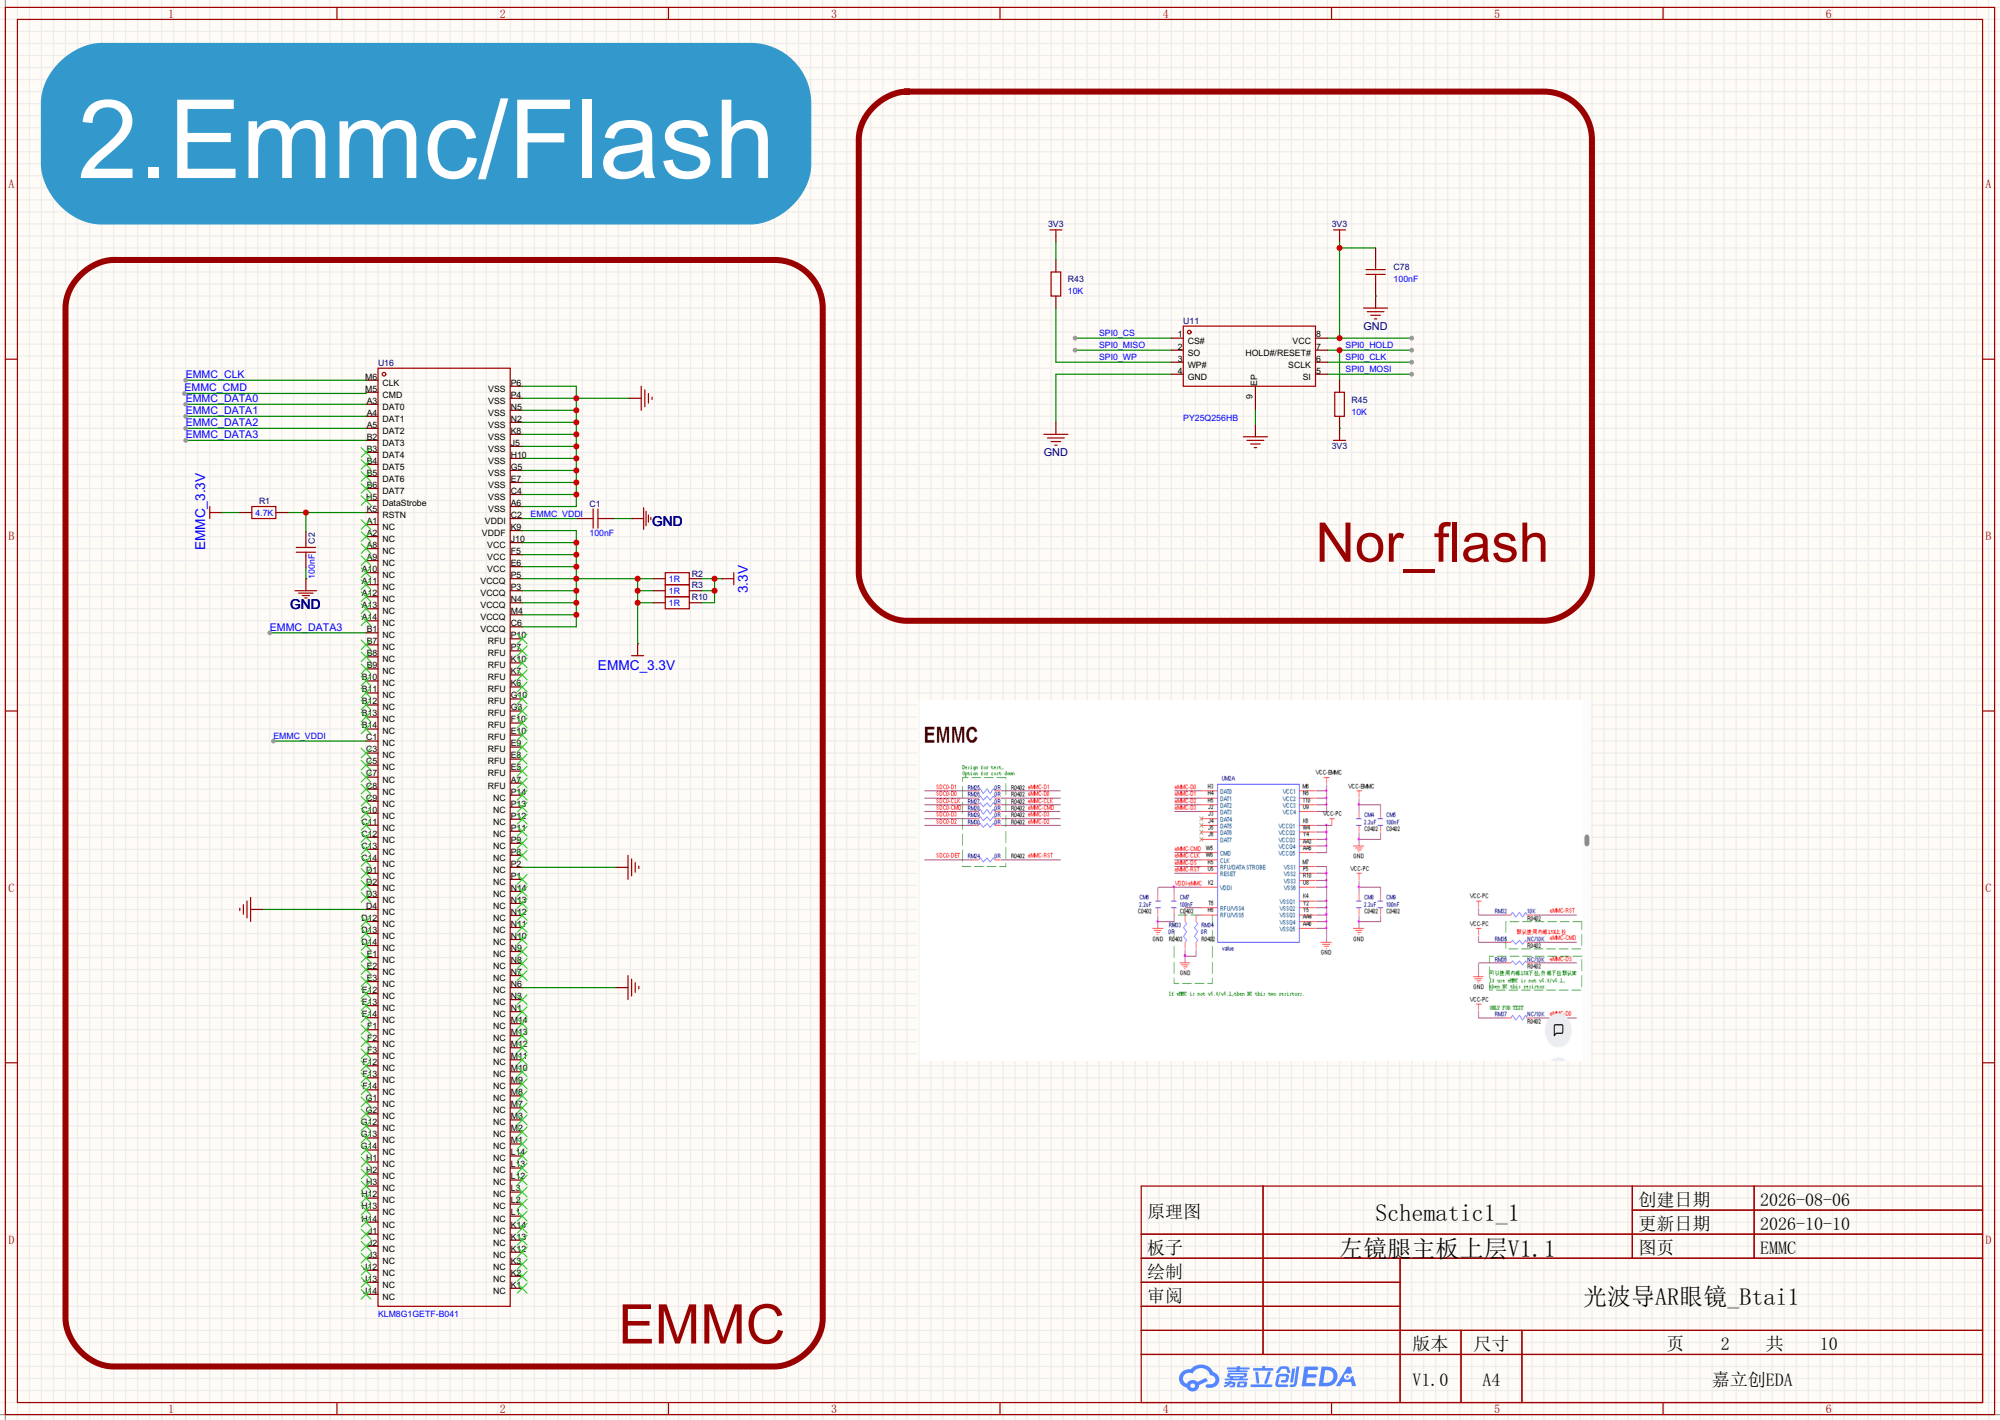
[picture p17: page 2]

# 3.power_main

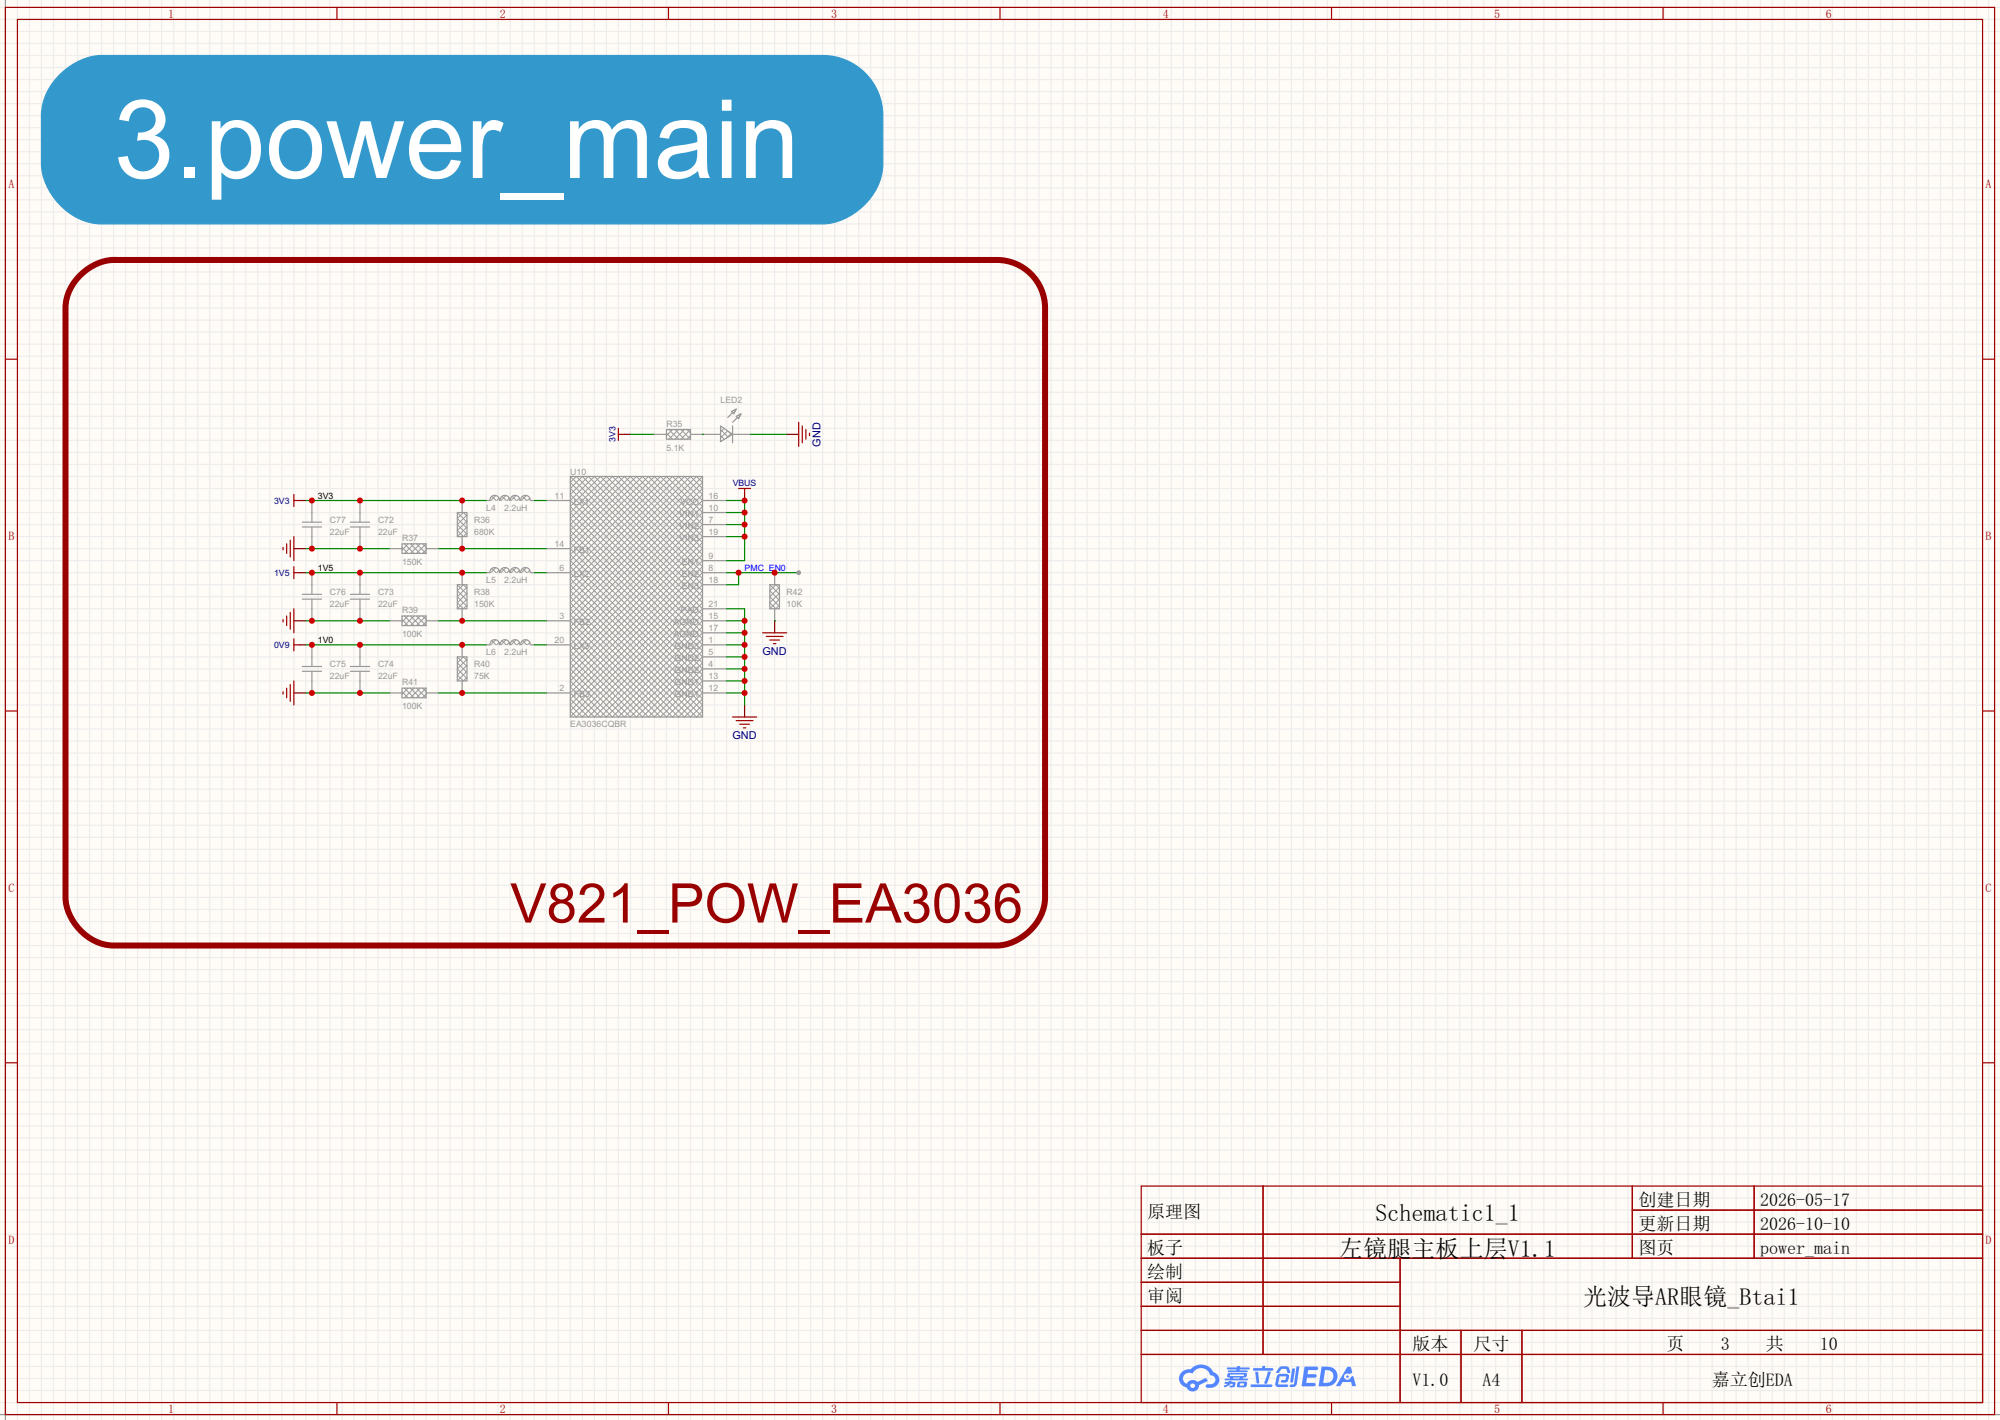
[picture p18: page 3]

# 4.JL7016G8

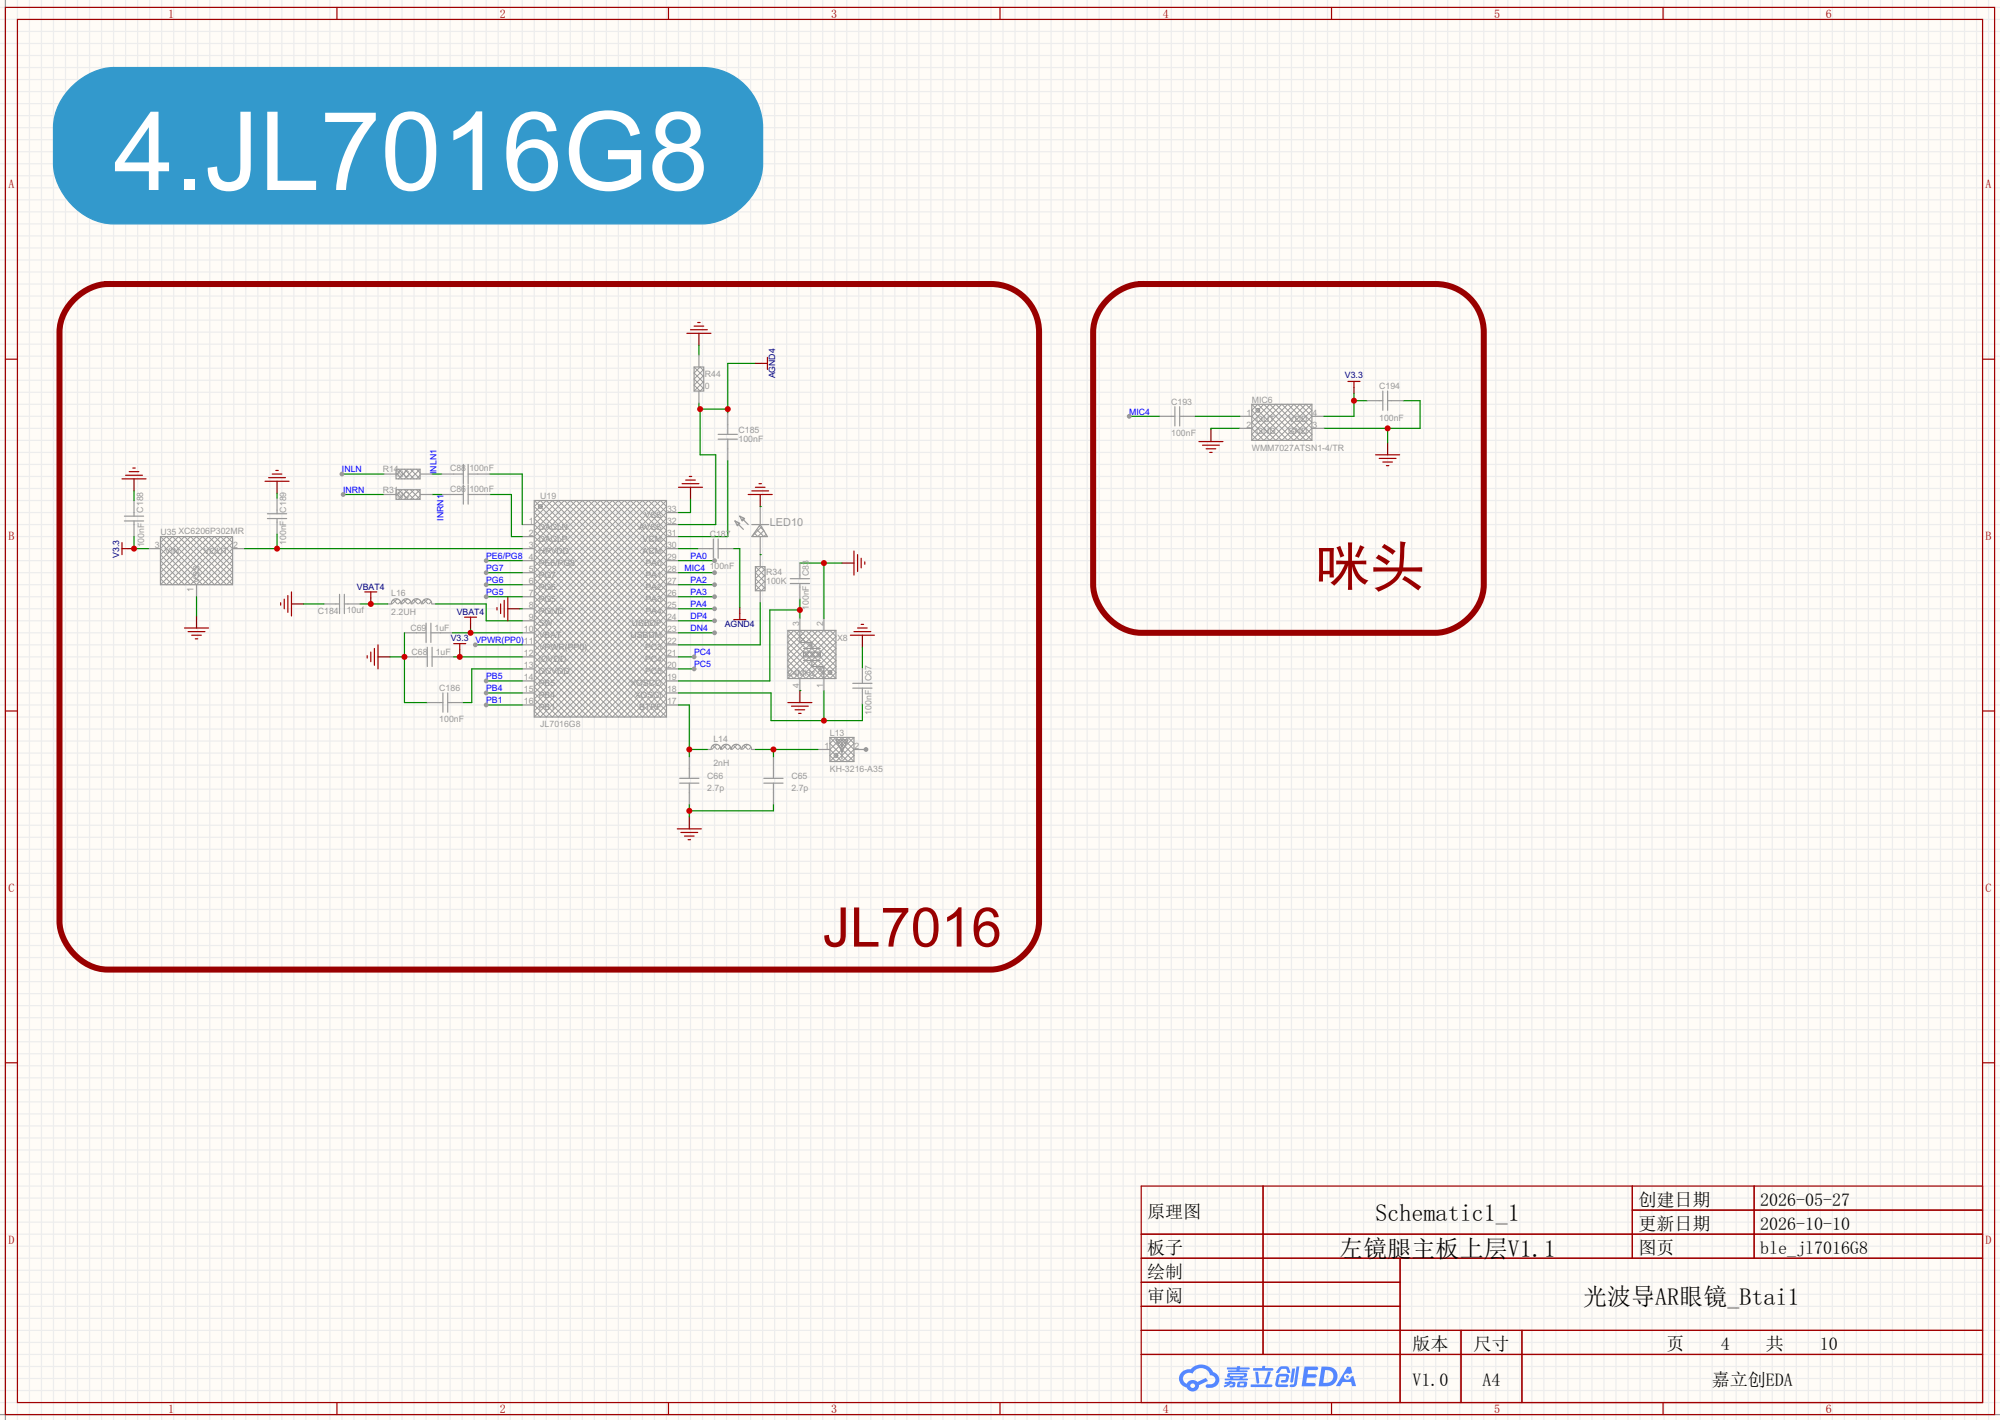
[picture p19: page 4]

MIC4 | PA2 PA3 PA4 DP4 DN4

# 5.power_in

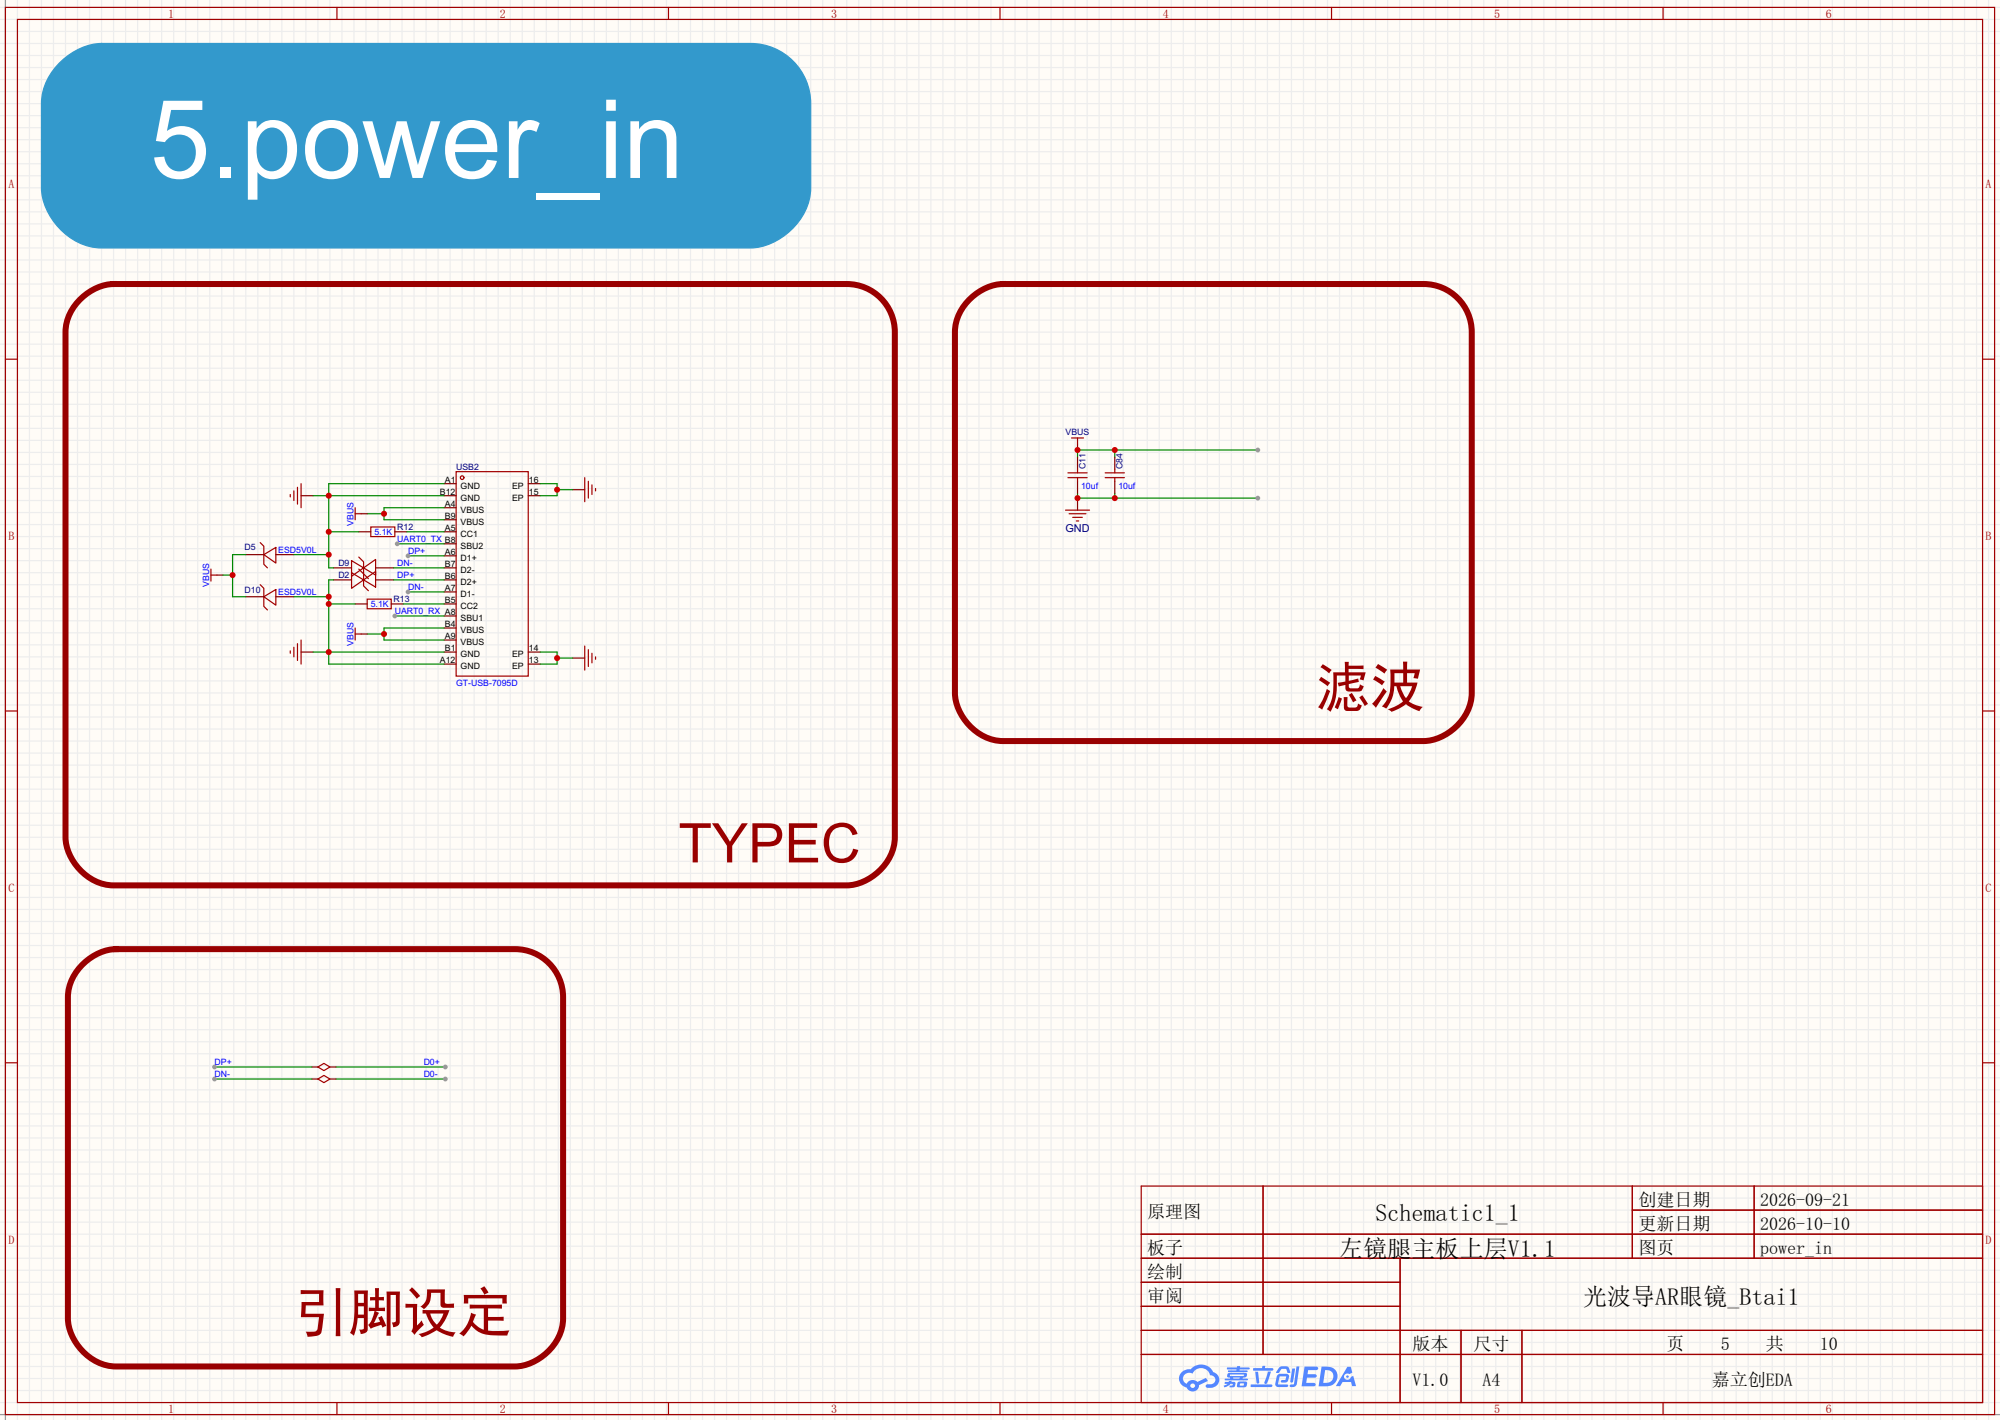
[picture p20: page 5]

2.5V
500MA

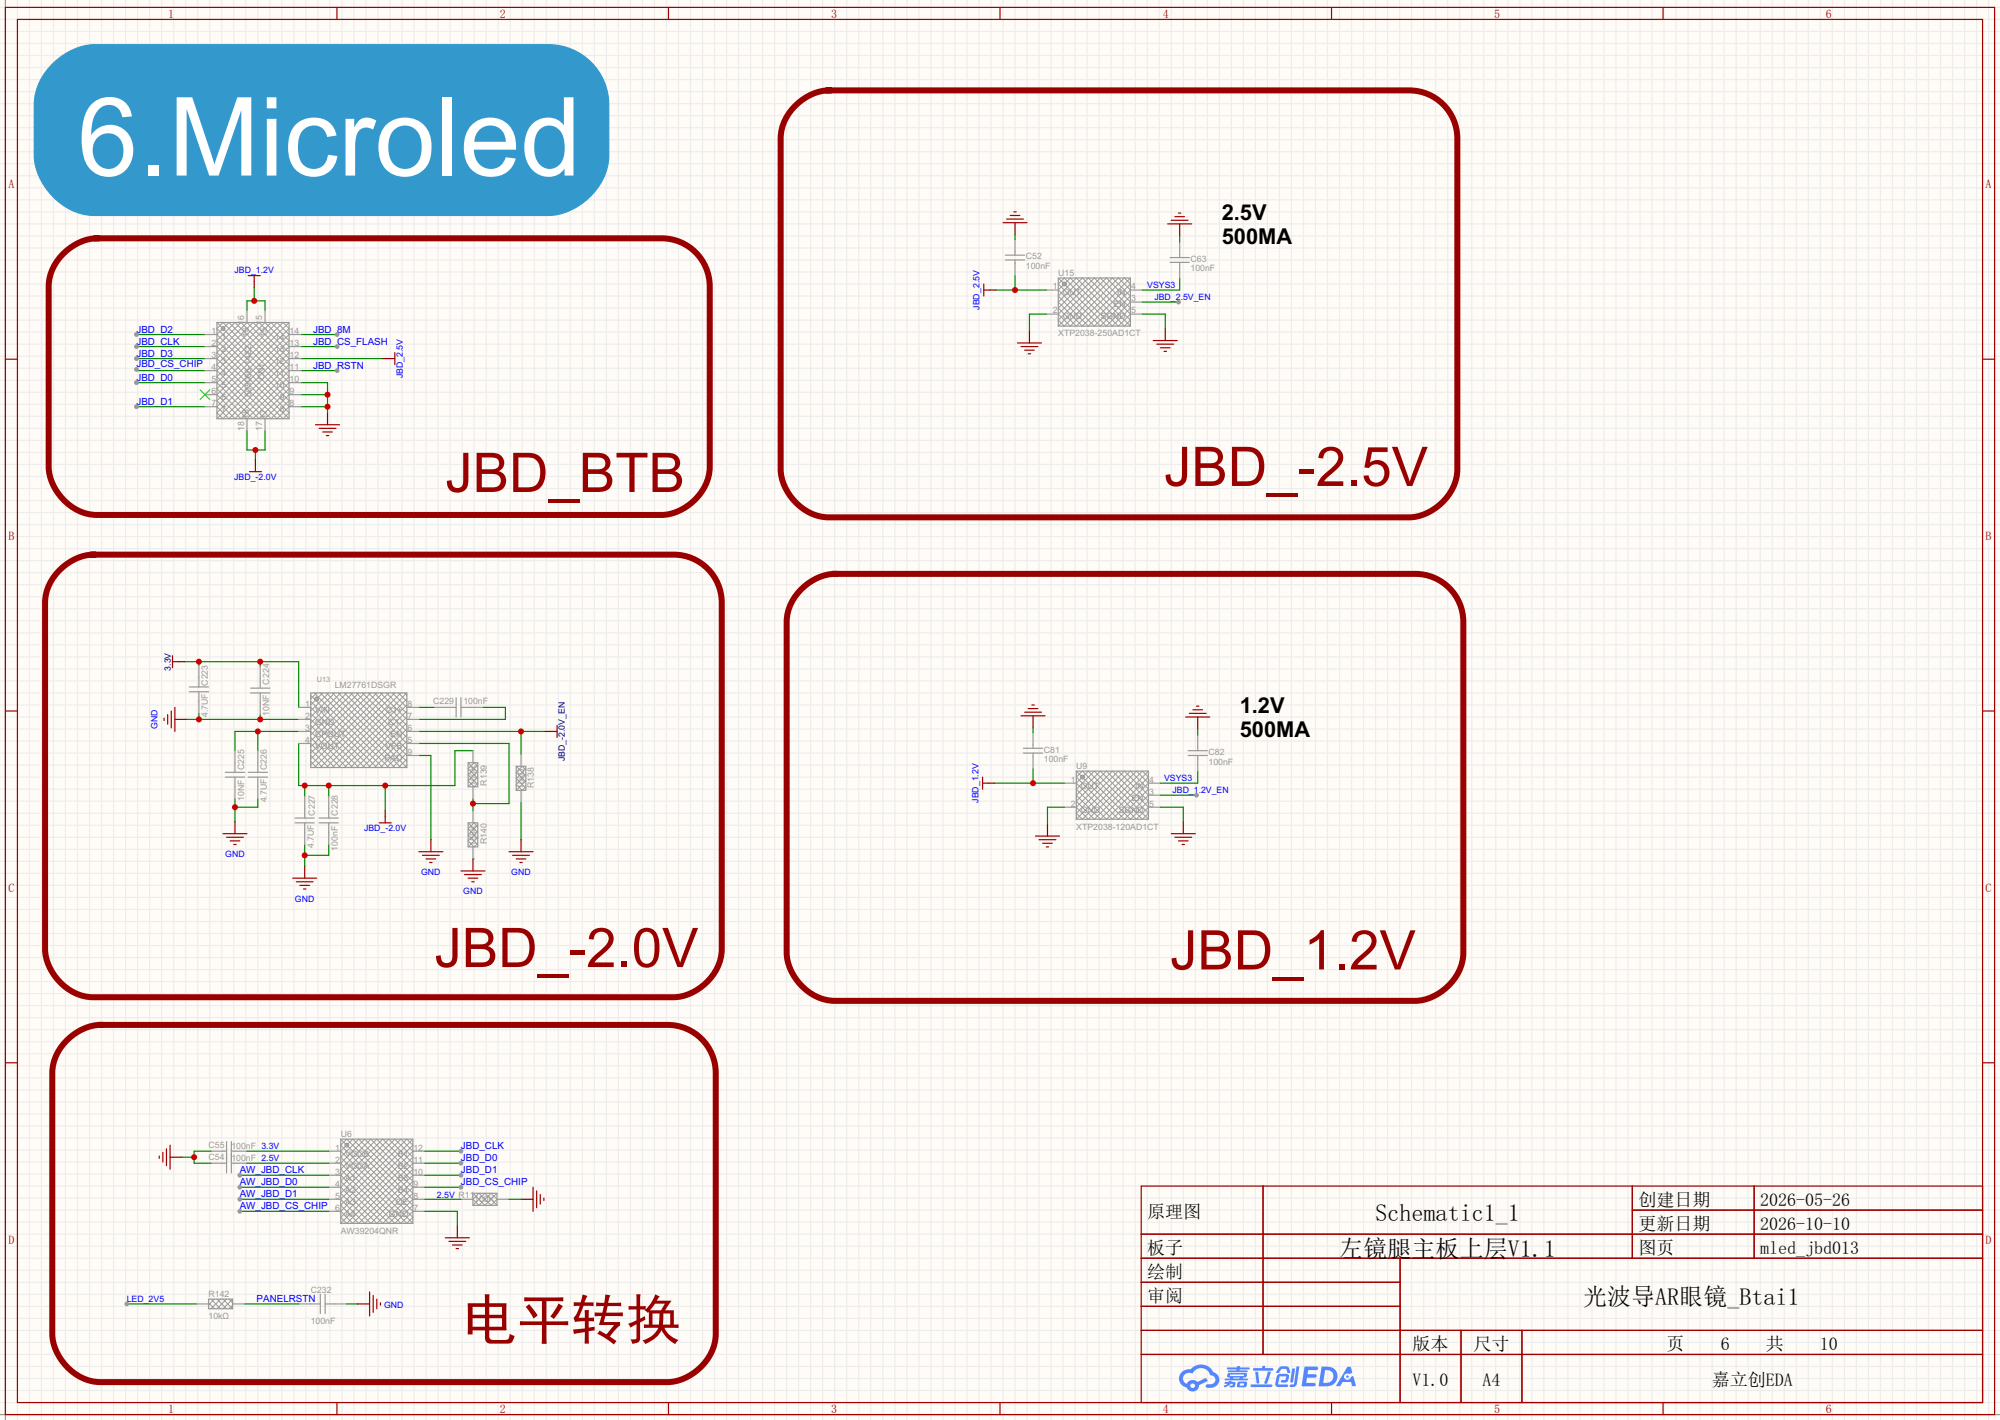
[picture p21: page 6]

VIN 1 GND 2 CPOUT 3 VOUT 4

C229 | 100nF 100K R¹³⁹

# 1.Sensor

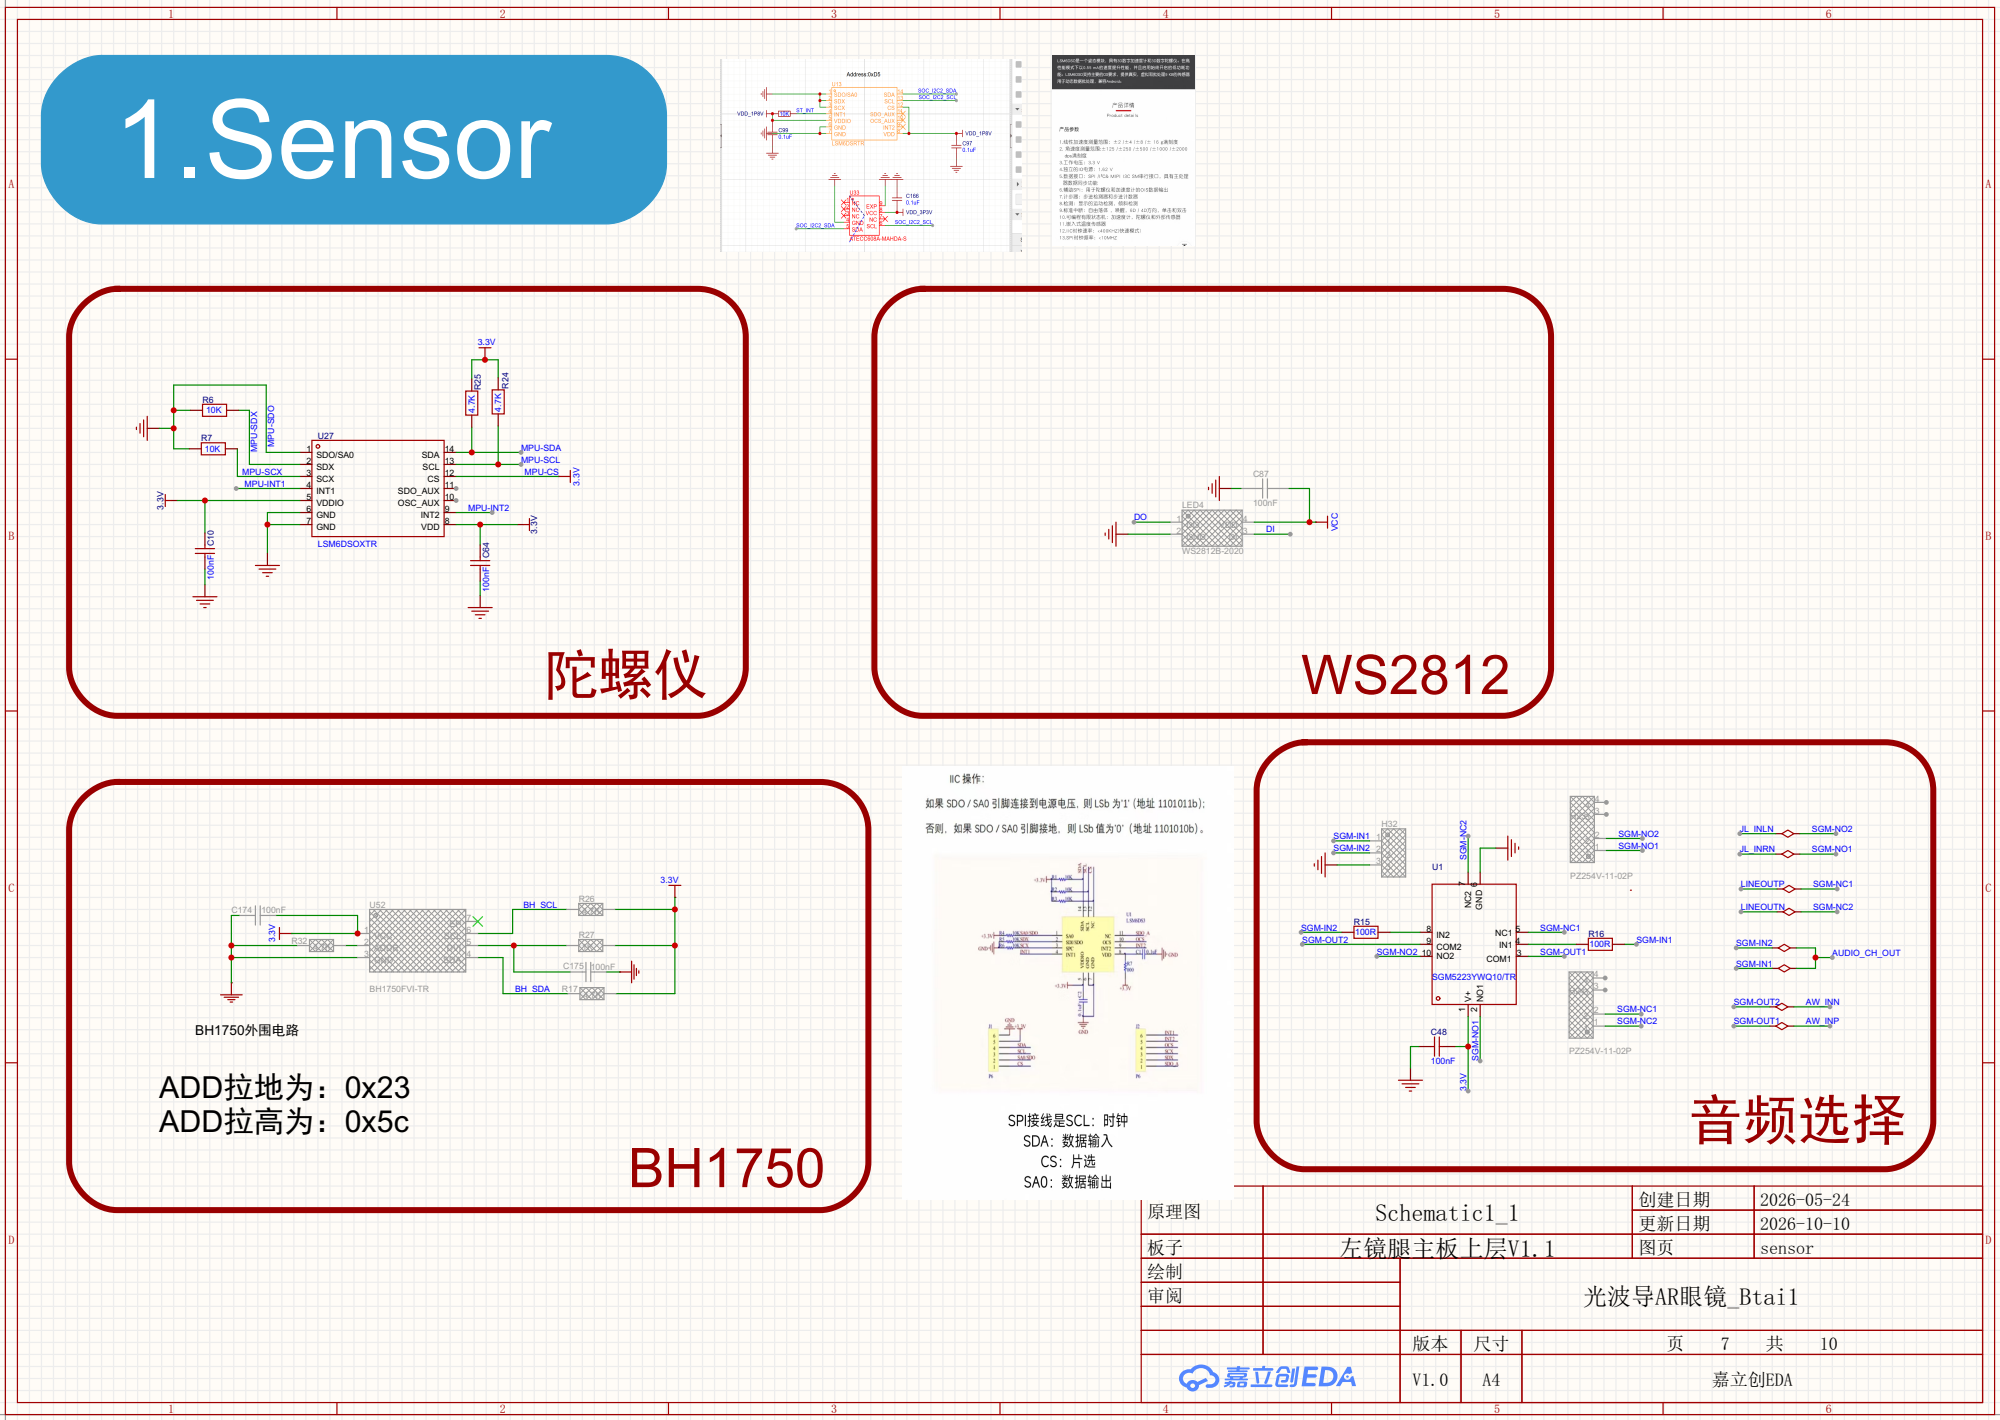
[picture p22: page 7]

1.8V
500MA

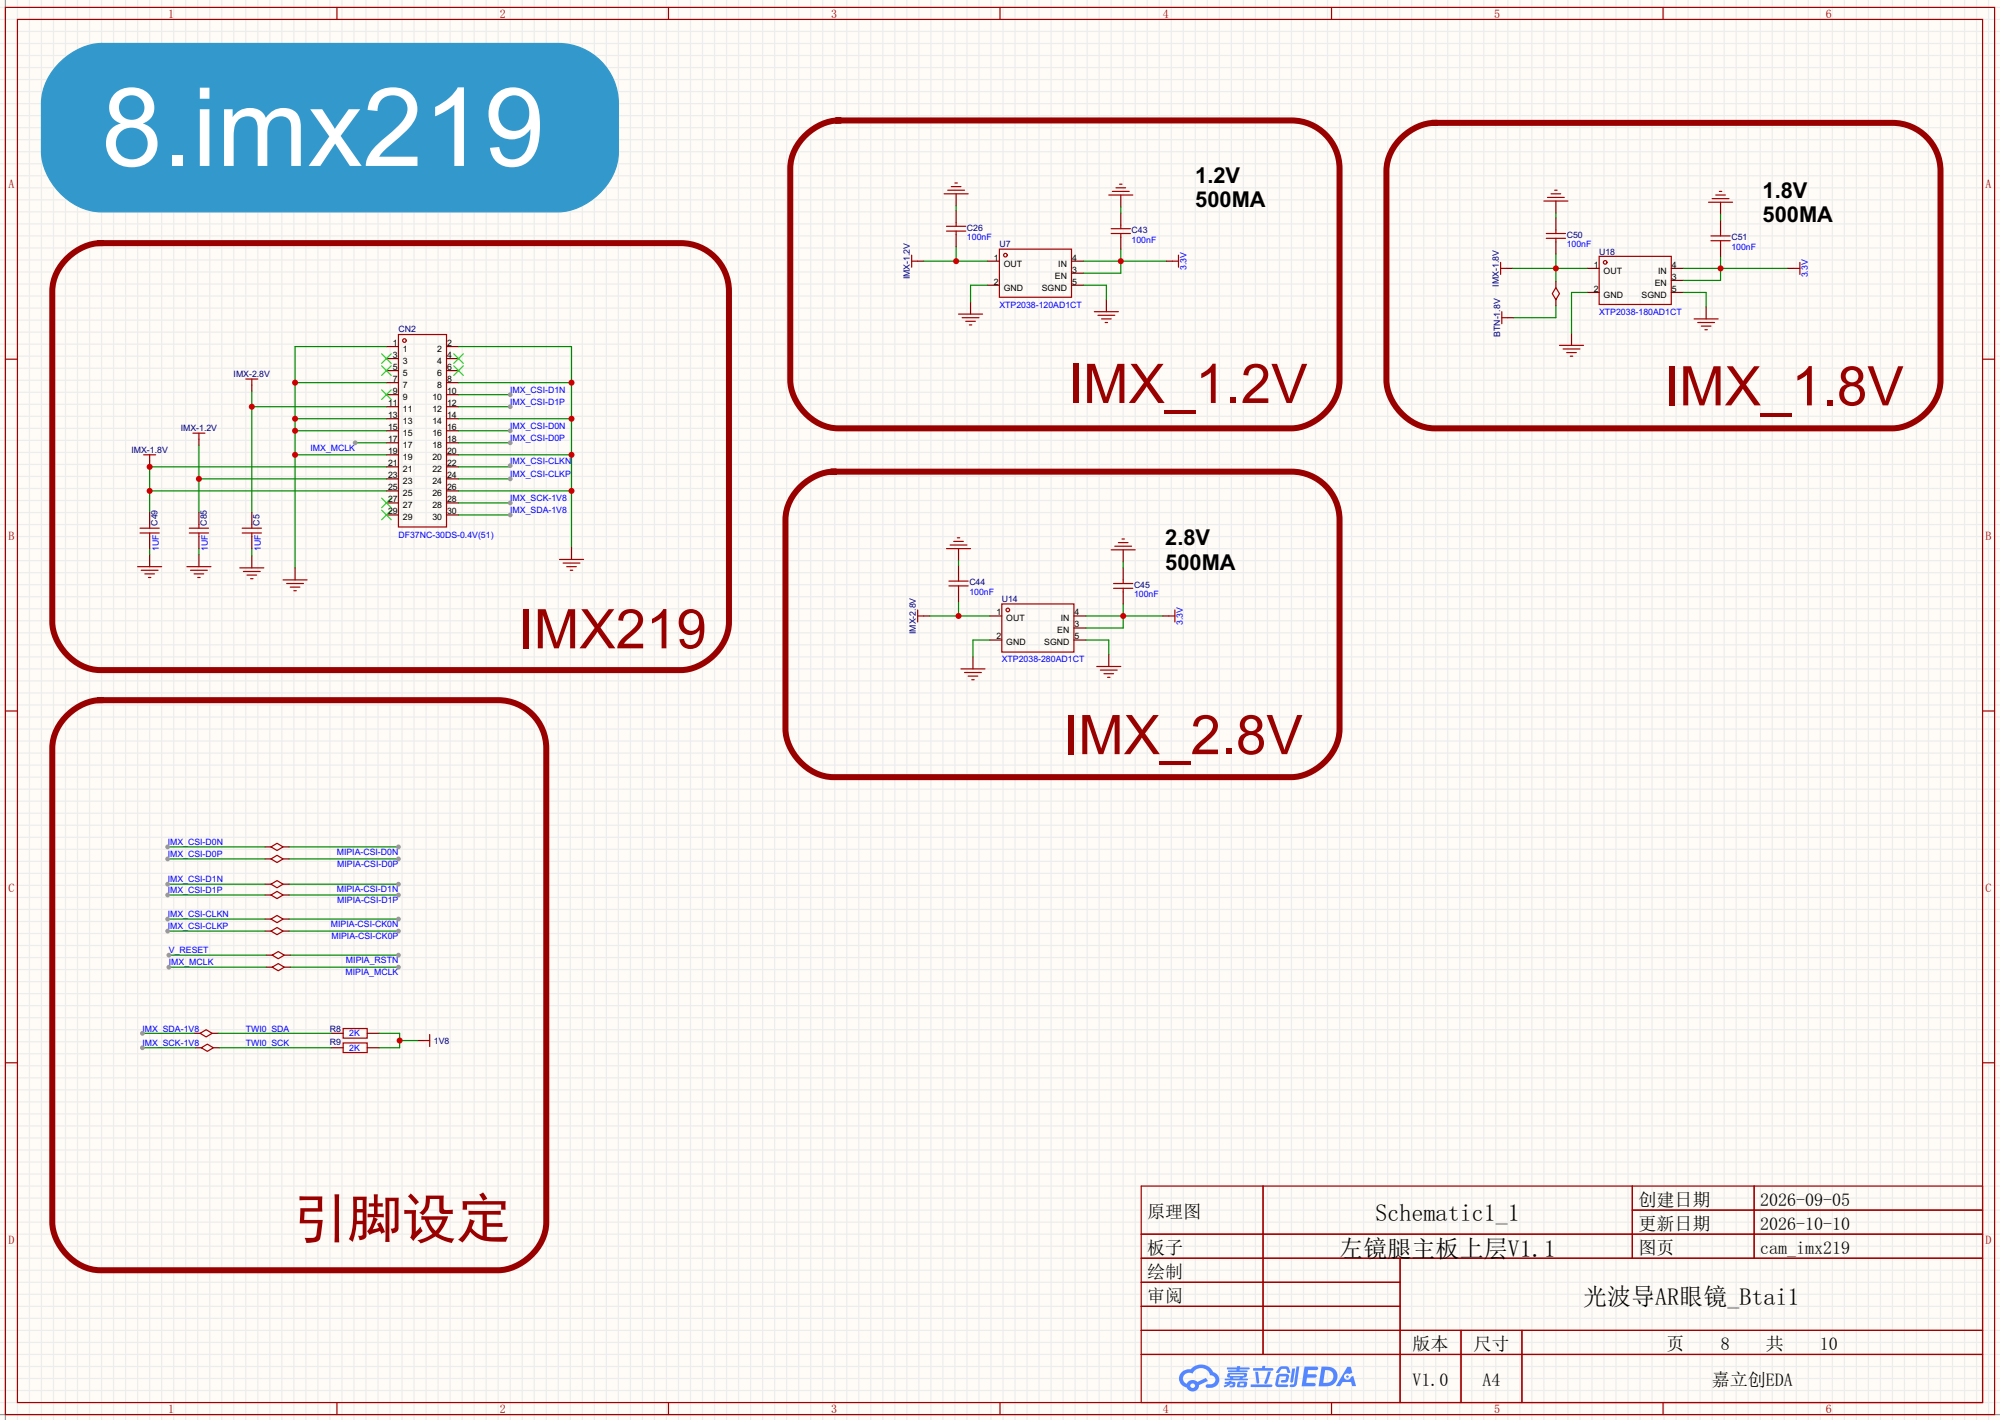
[picture p23: page 8]

IMX_CSI-D0N IMX_CSI-D0P

IMX_MCLK

IMX_CSI-CLKN IMX_CSI-CLKP

MIPIA-CSI-D0N
MIPIA-CSI-D0P

MIPIA-CSI-D1N
MIPIA-CSI-D1P

MIPIA-CSI-CK0N
MIPIA-CSI-CK0P

# 9.conector

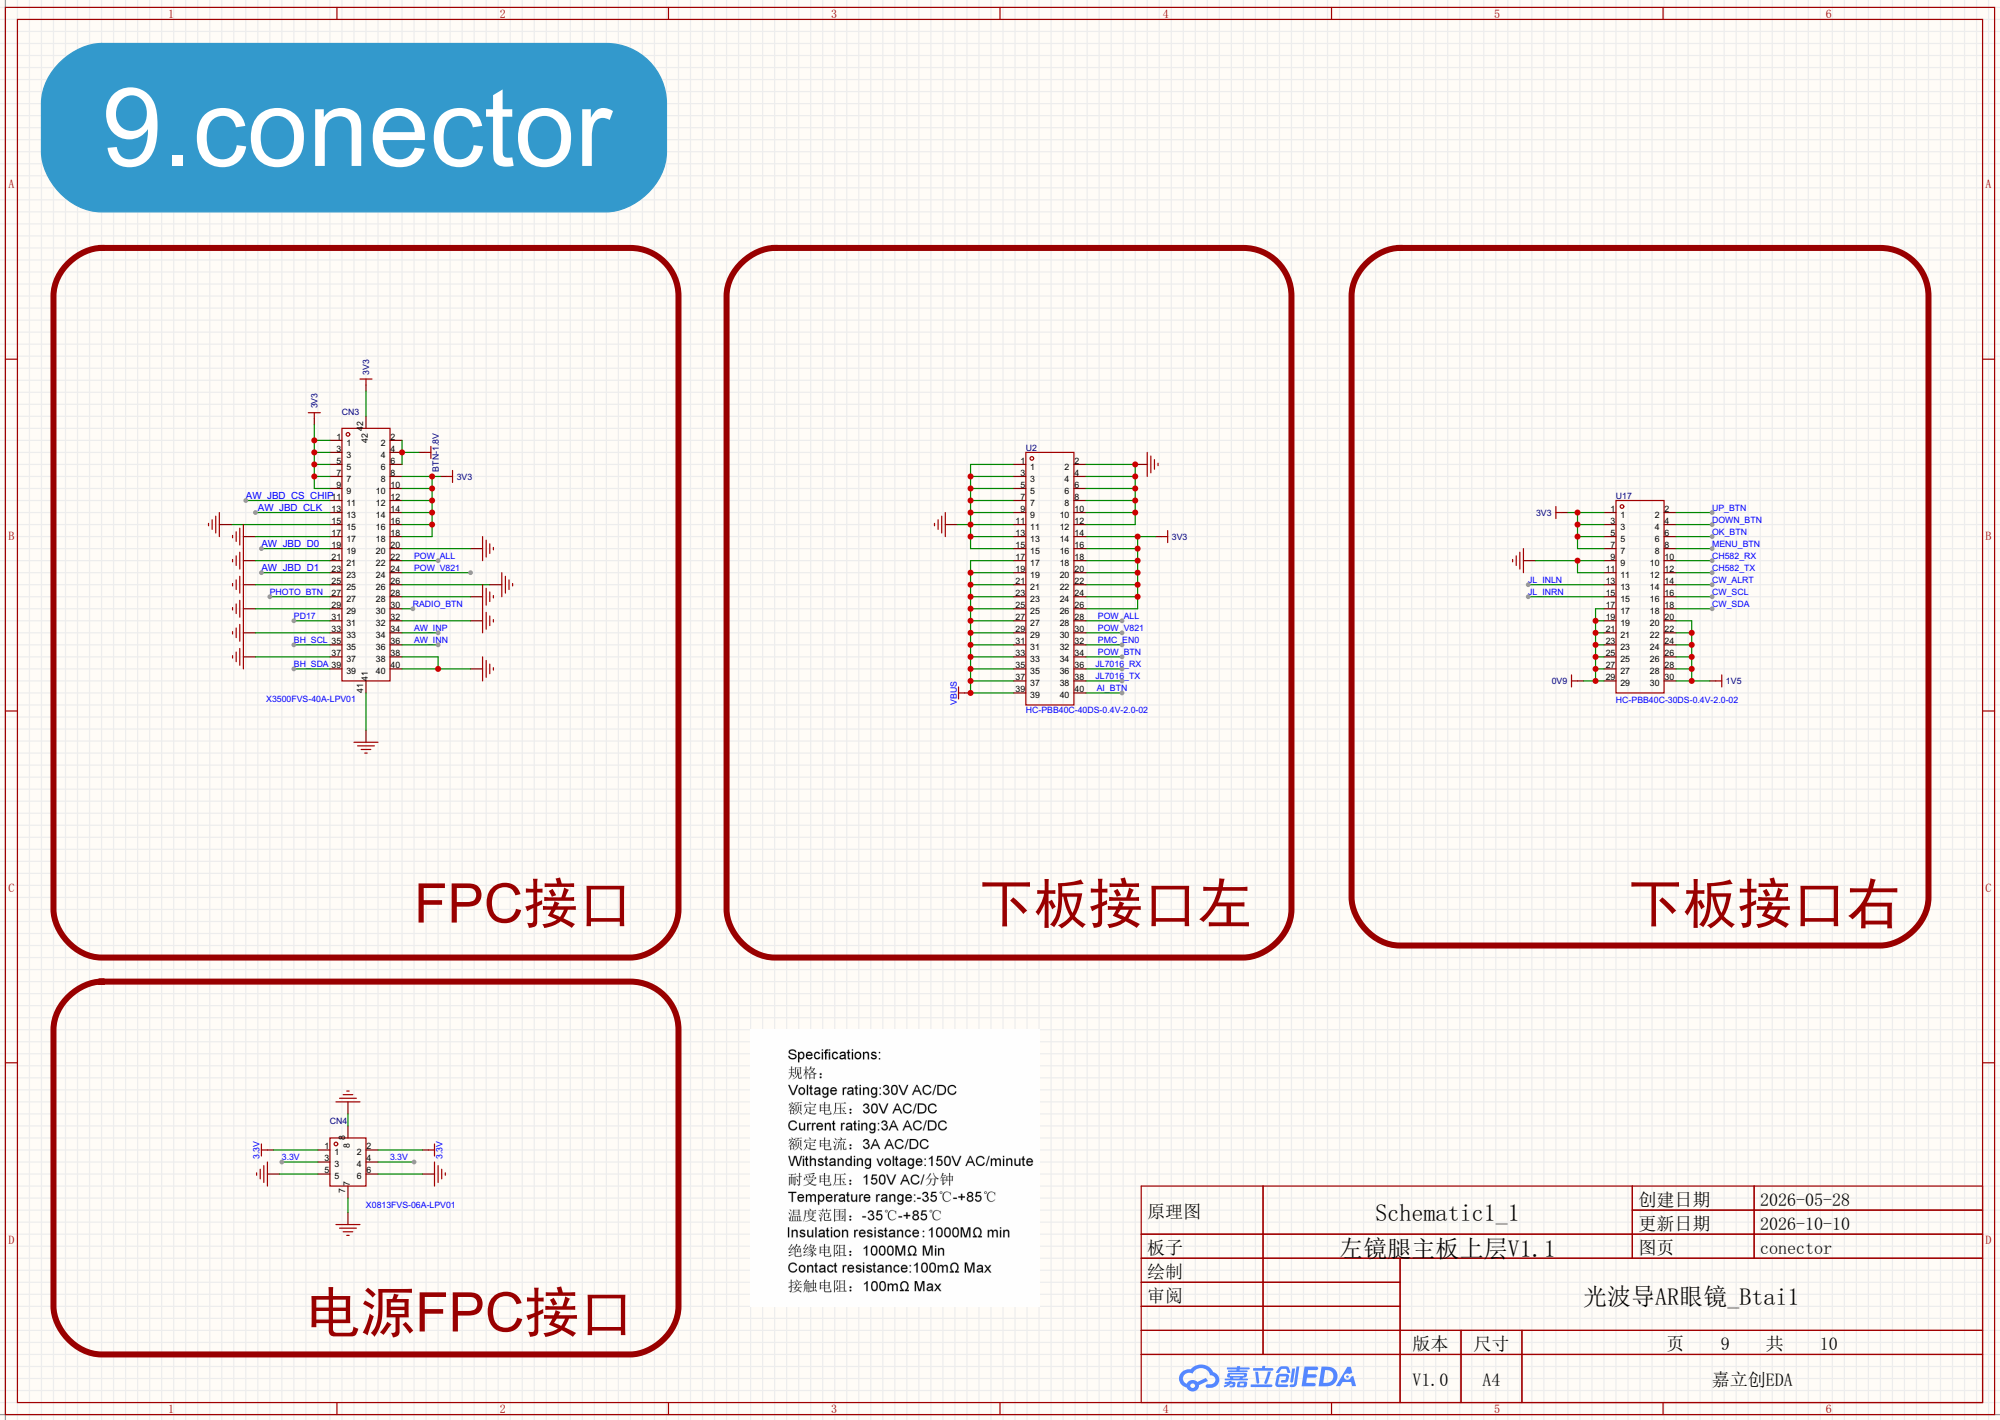
[picture p24: page 9]

# bh1750硬件iic2

# jbd013硬件spi

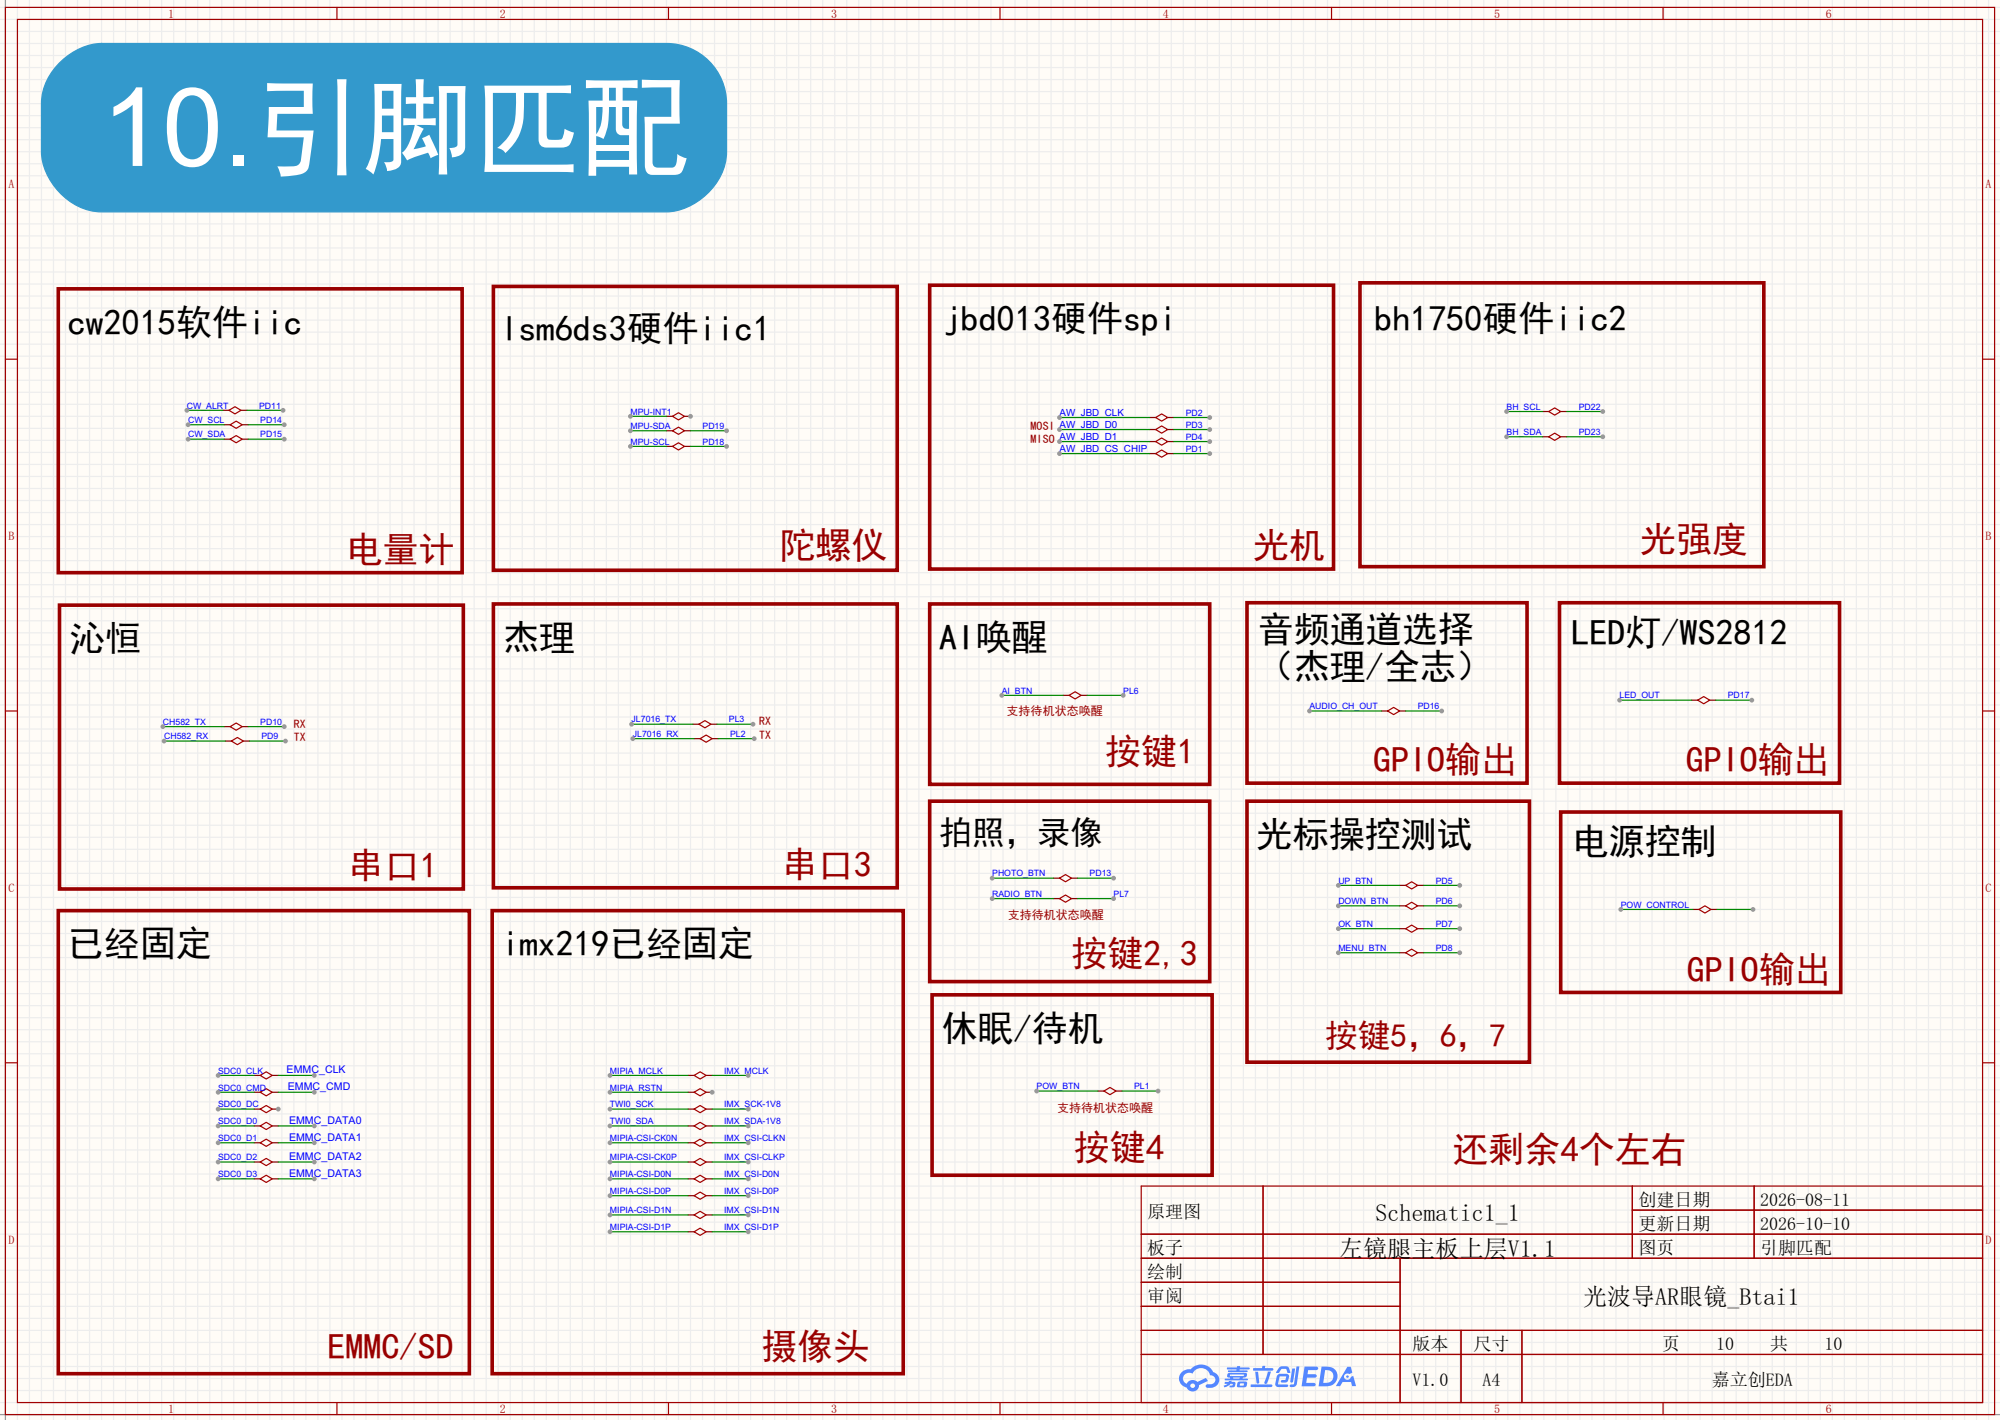
[picture p25: page 10]

MIPIA-CSI-D0P

MIPIA-CSI-D1N
MIPIA-CSI-D1P
