kemomi/Btai-AR/PDF_光波导AR眼镜_Btai1_PCB/SCH_Schematic2_2026-10-13.pdf

# 1.开关/按钮

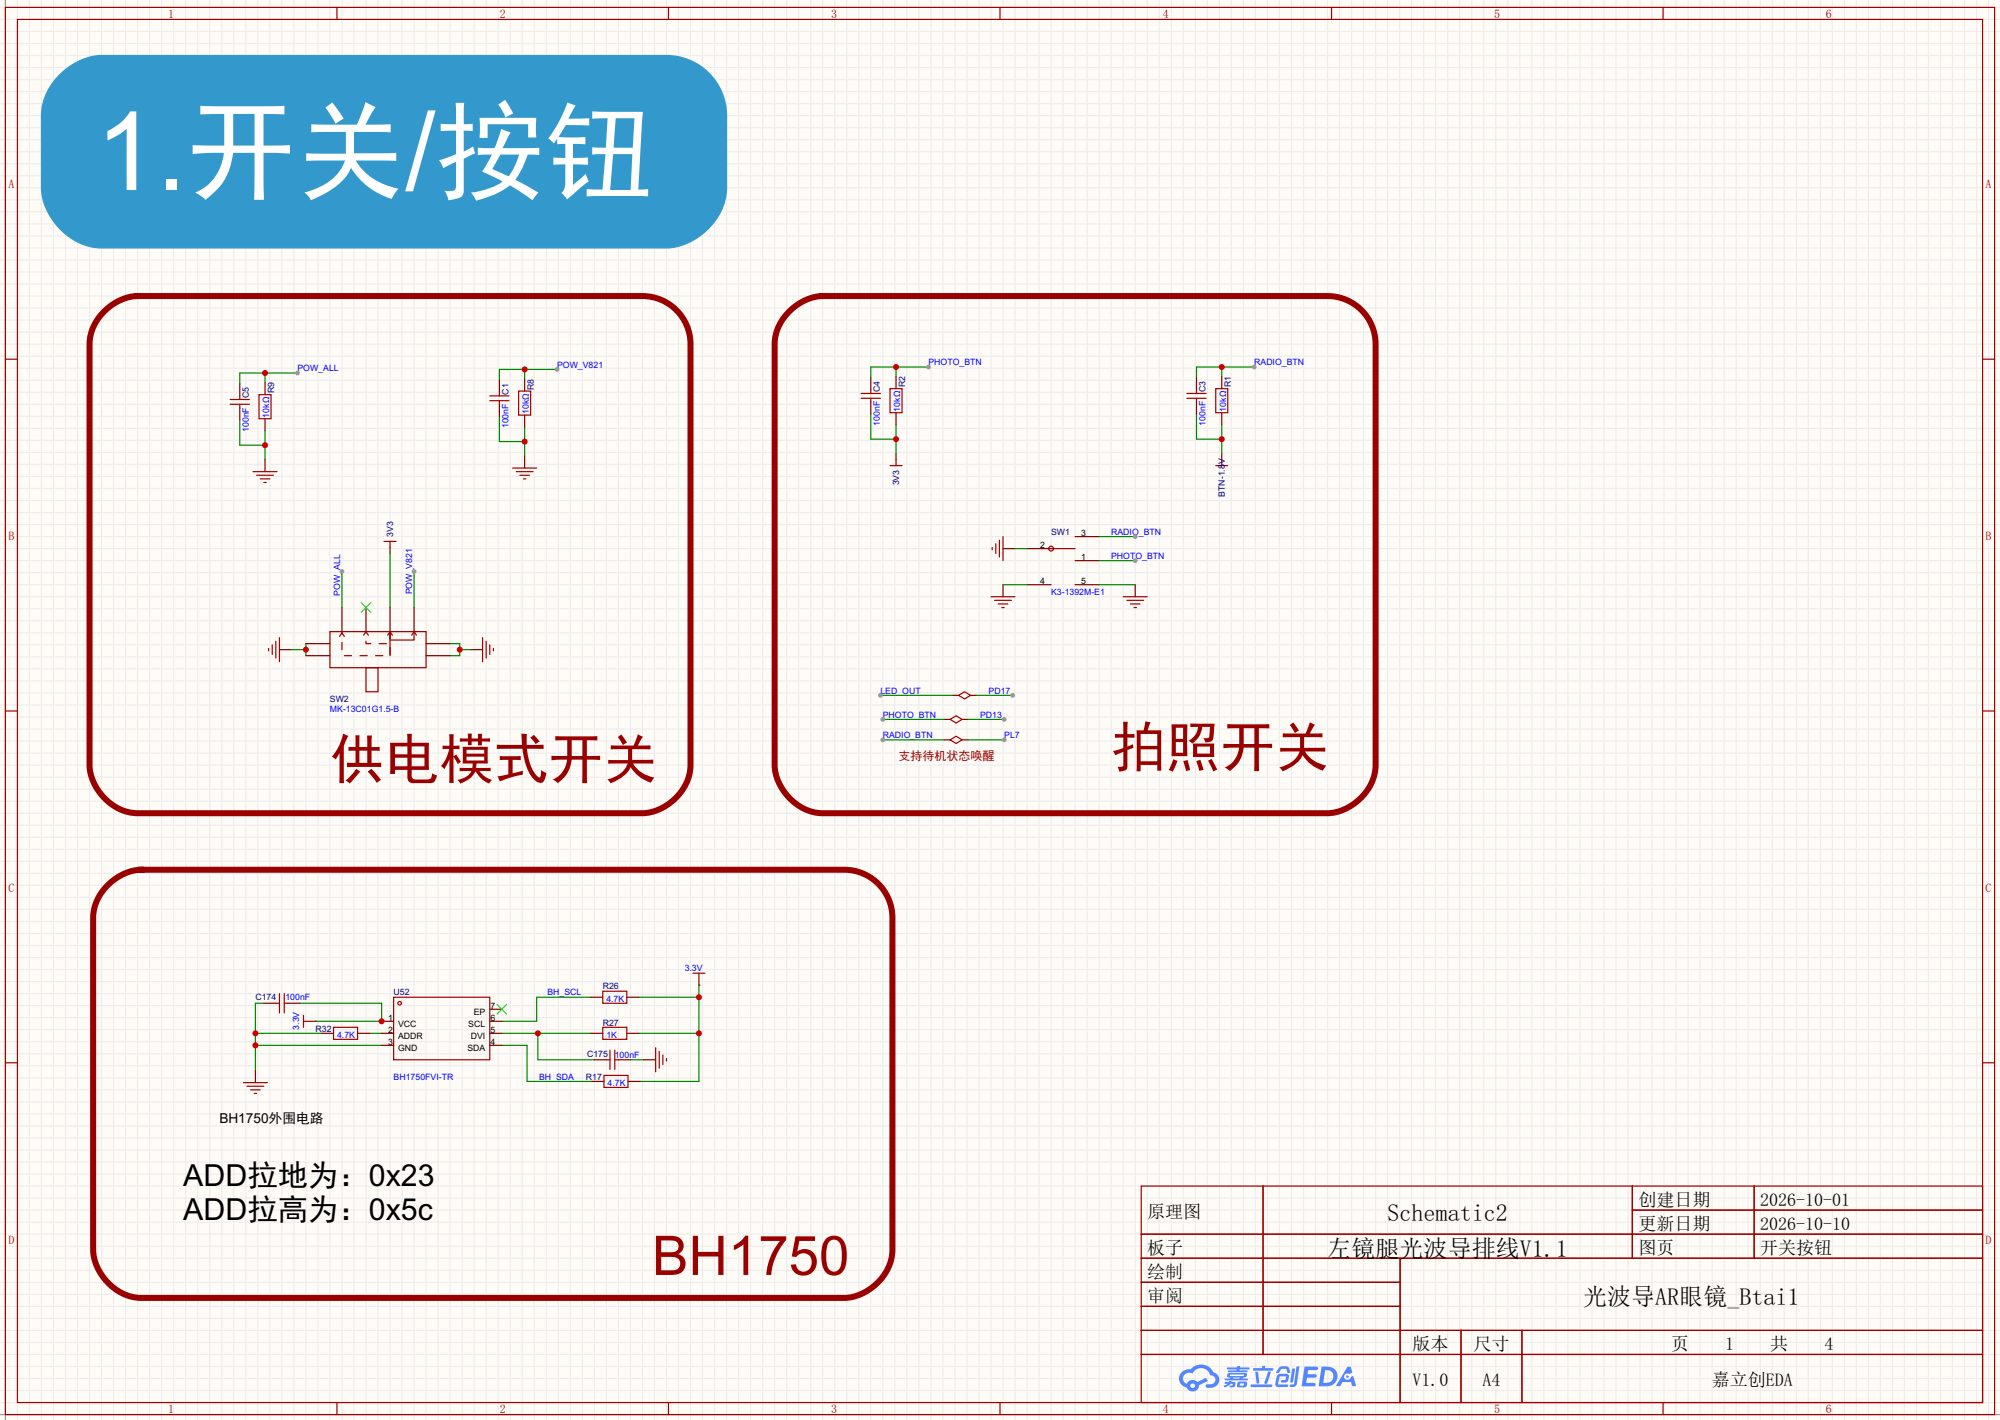
[picture p26: page 1]

# 2.conector

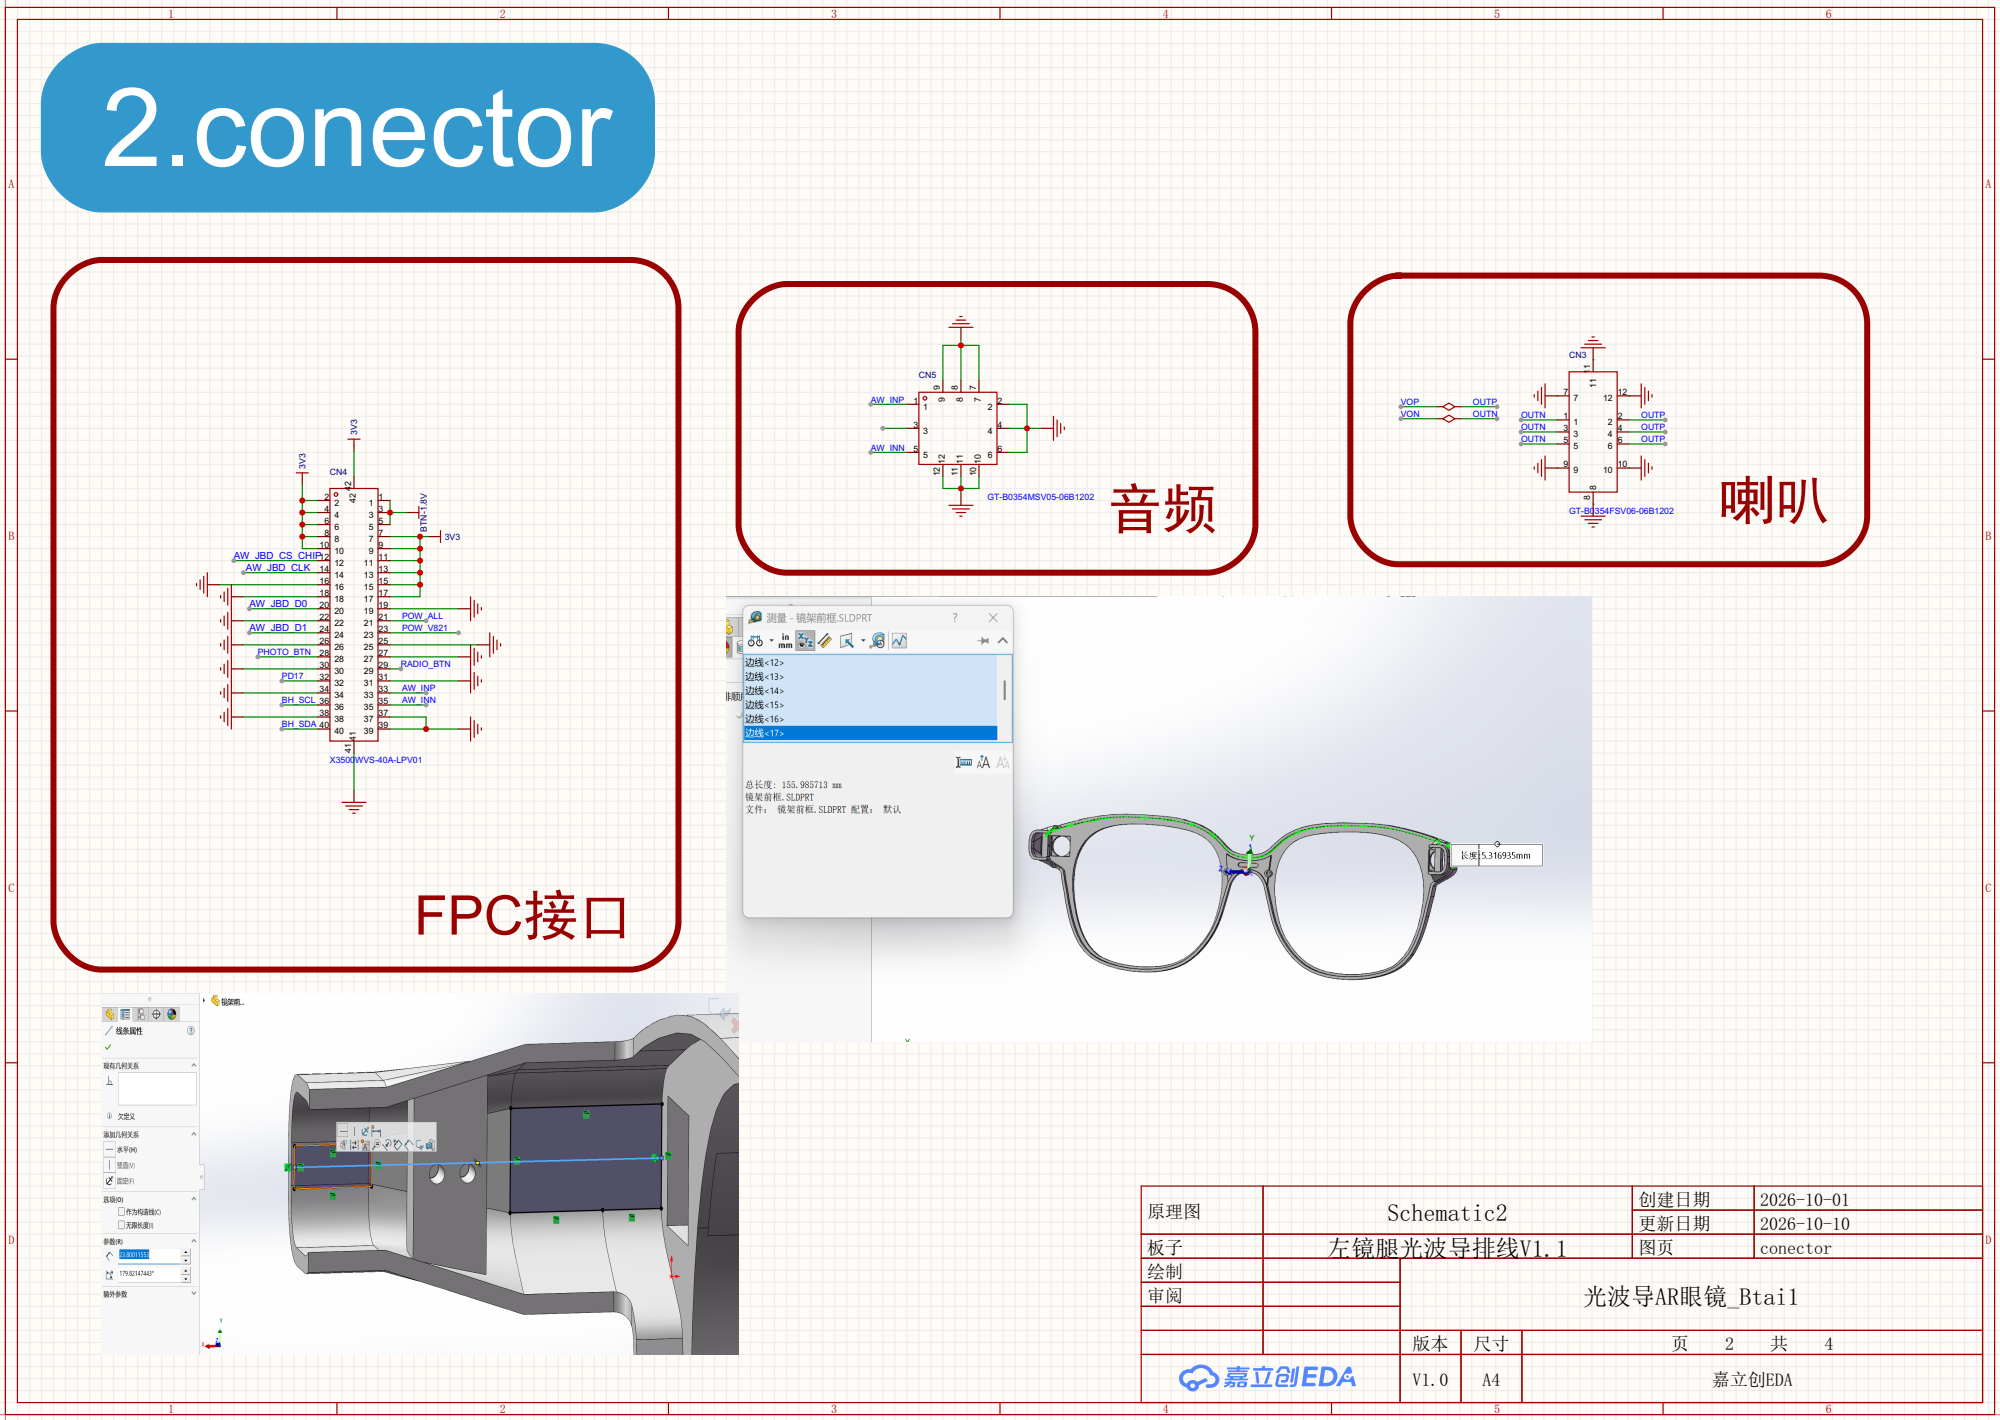
[picture p27: page 2]

# 3.Audio

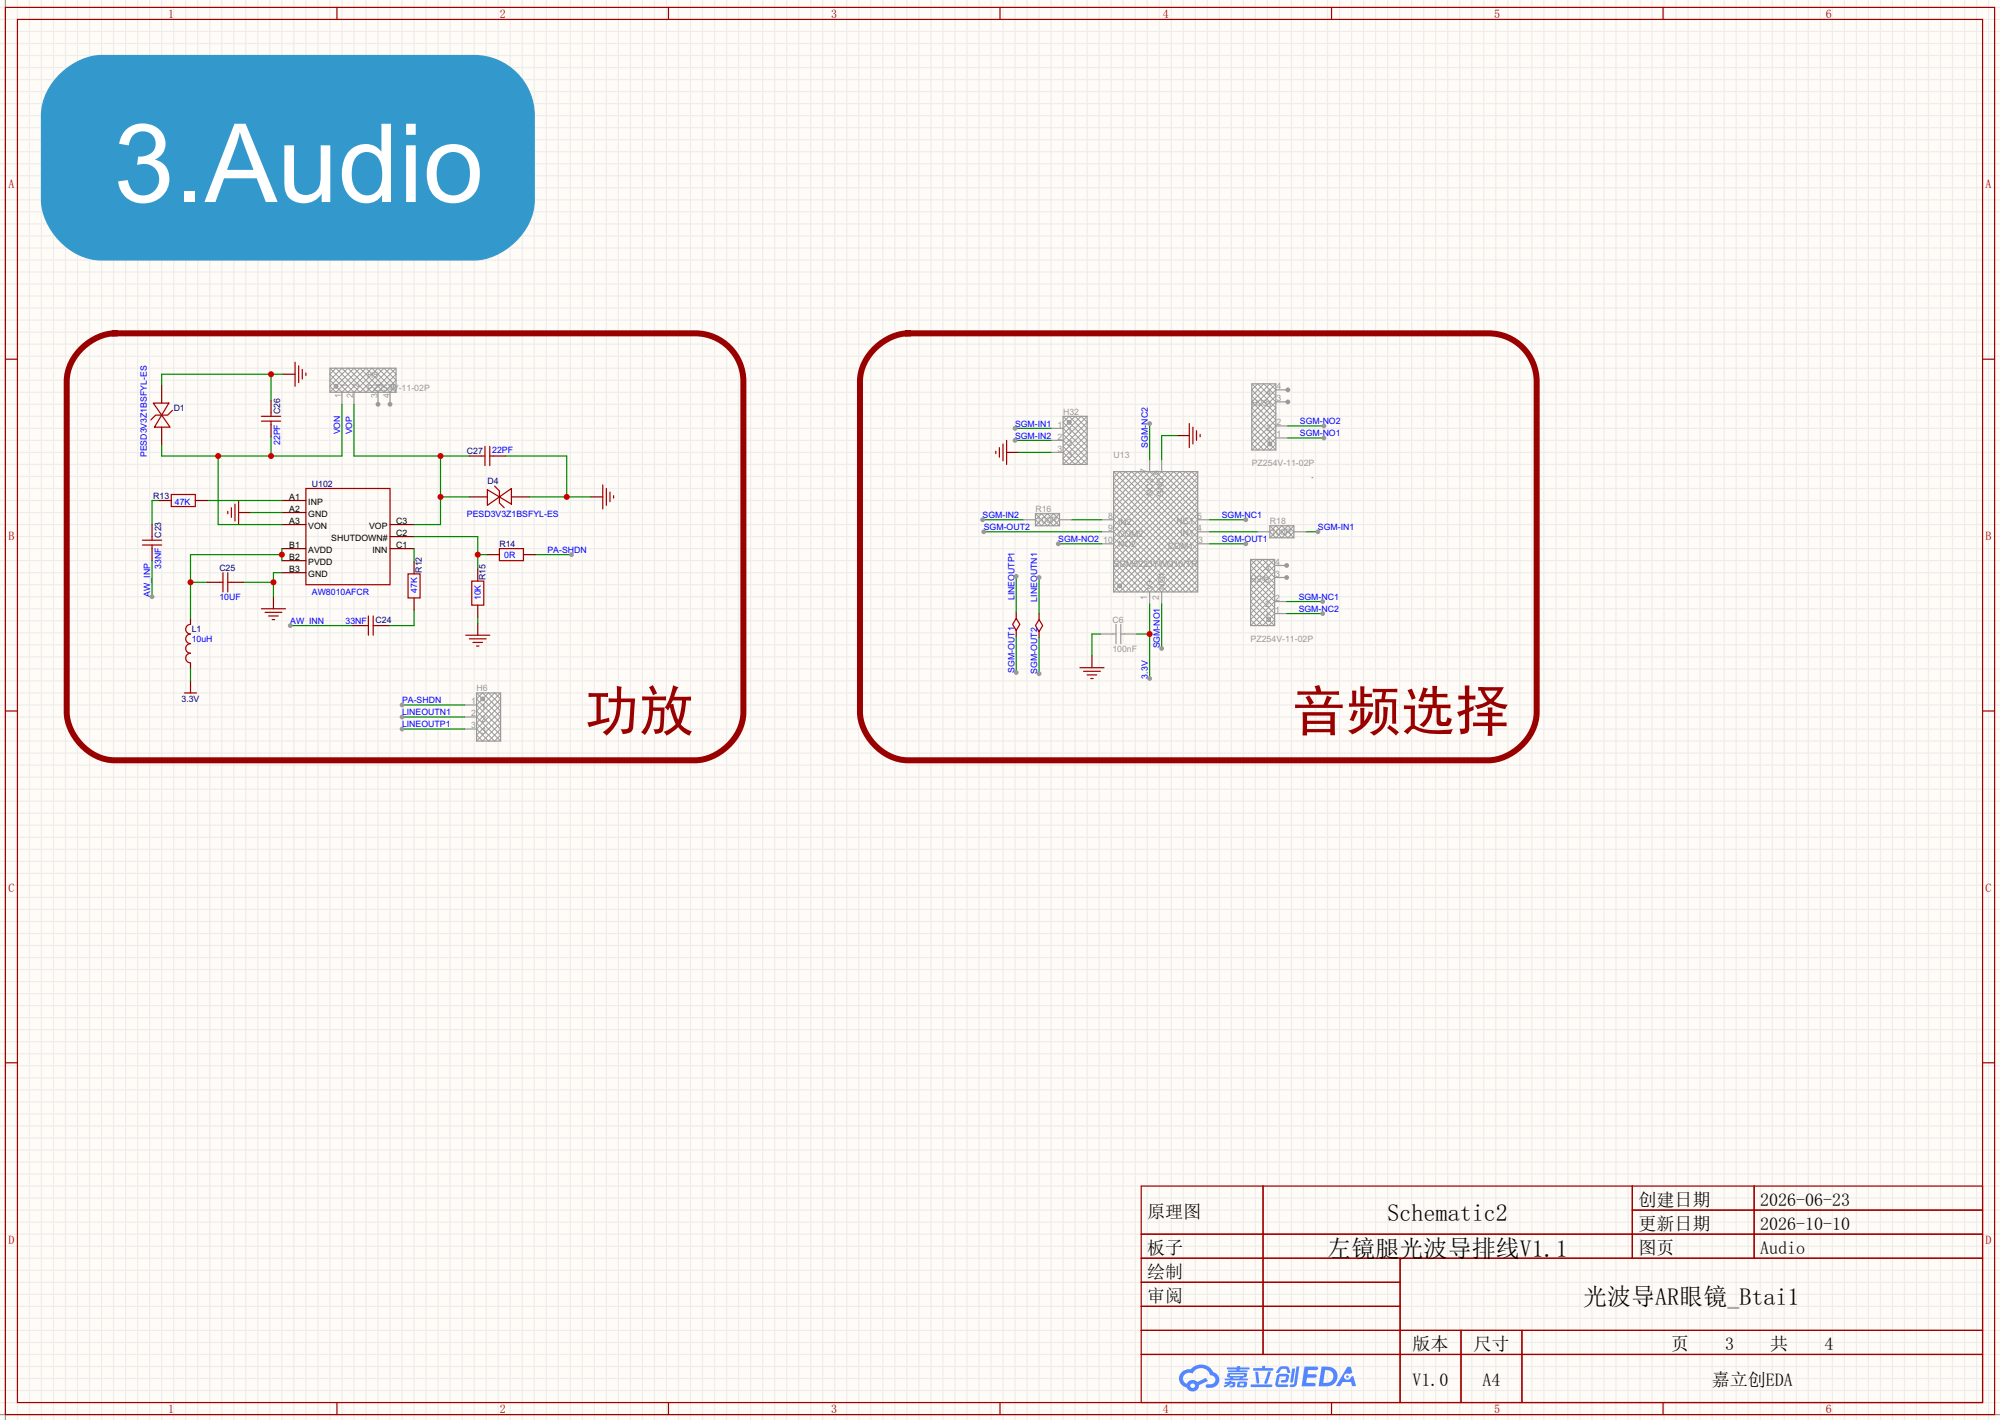
[picture p28: page 3]

2.5V
500MA

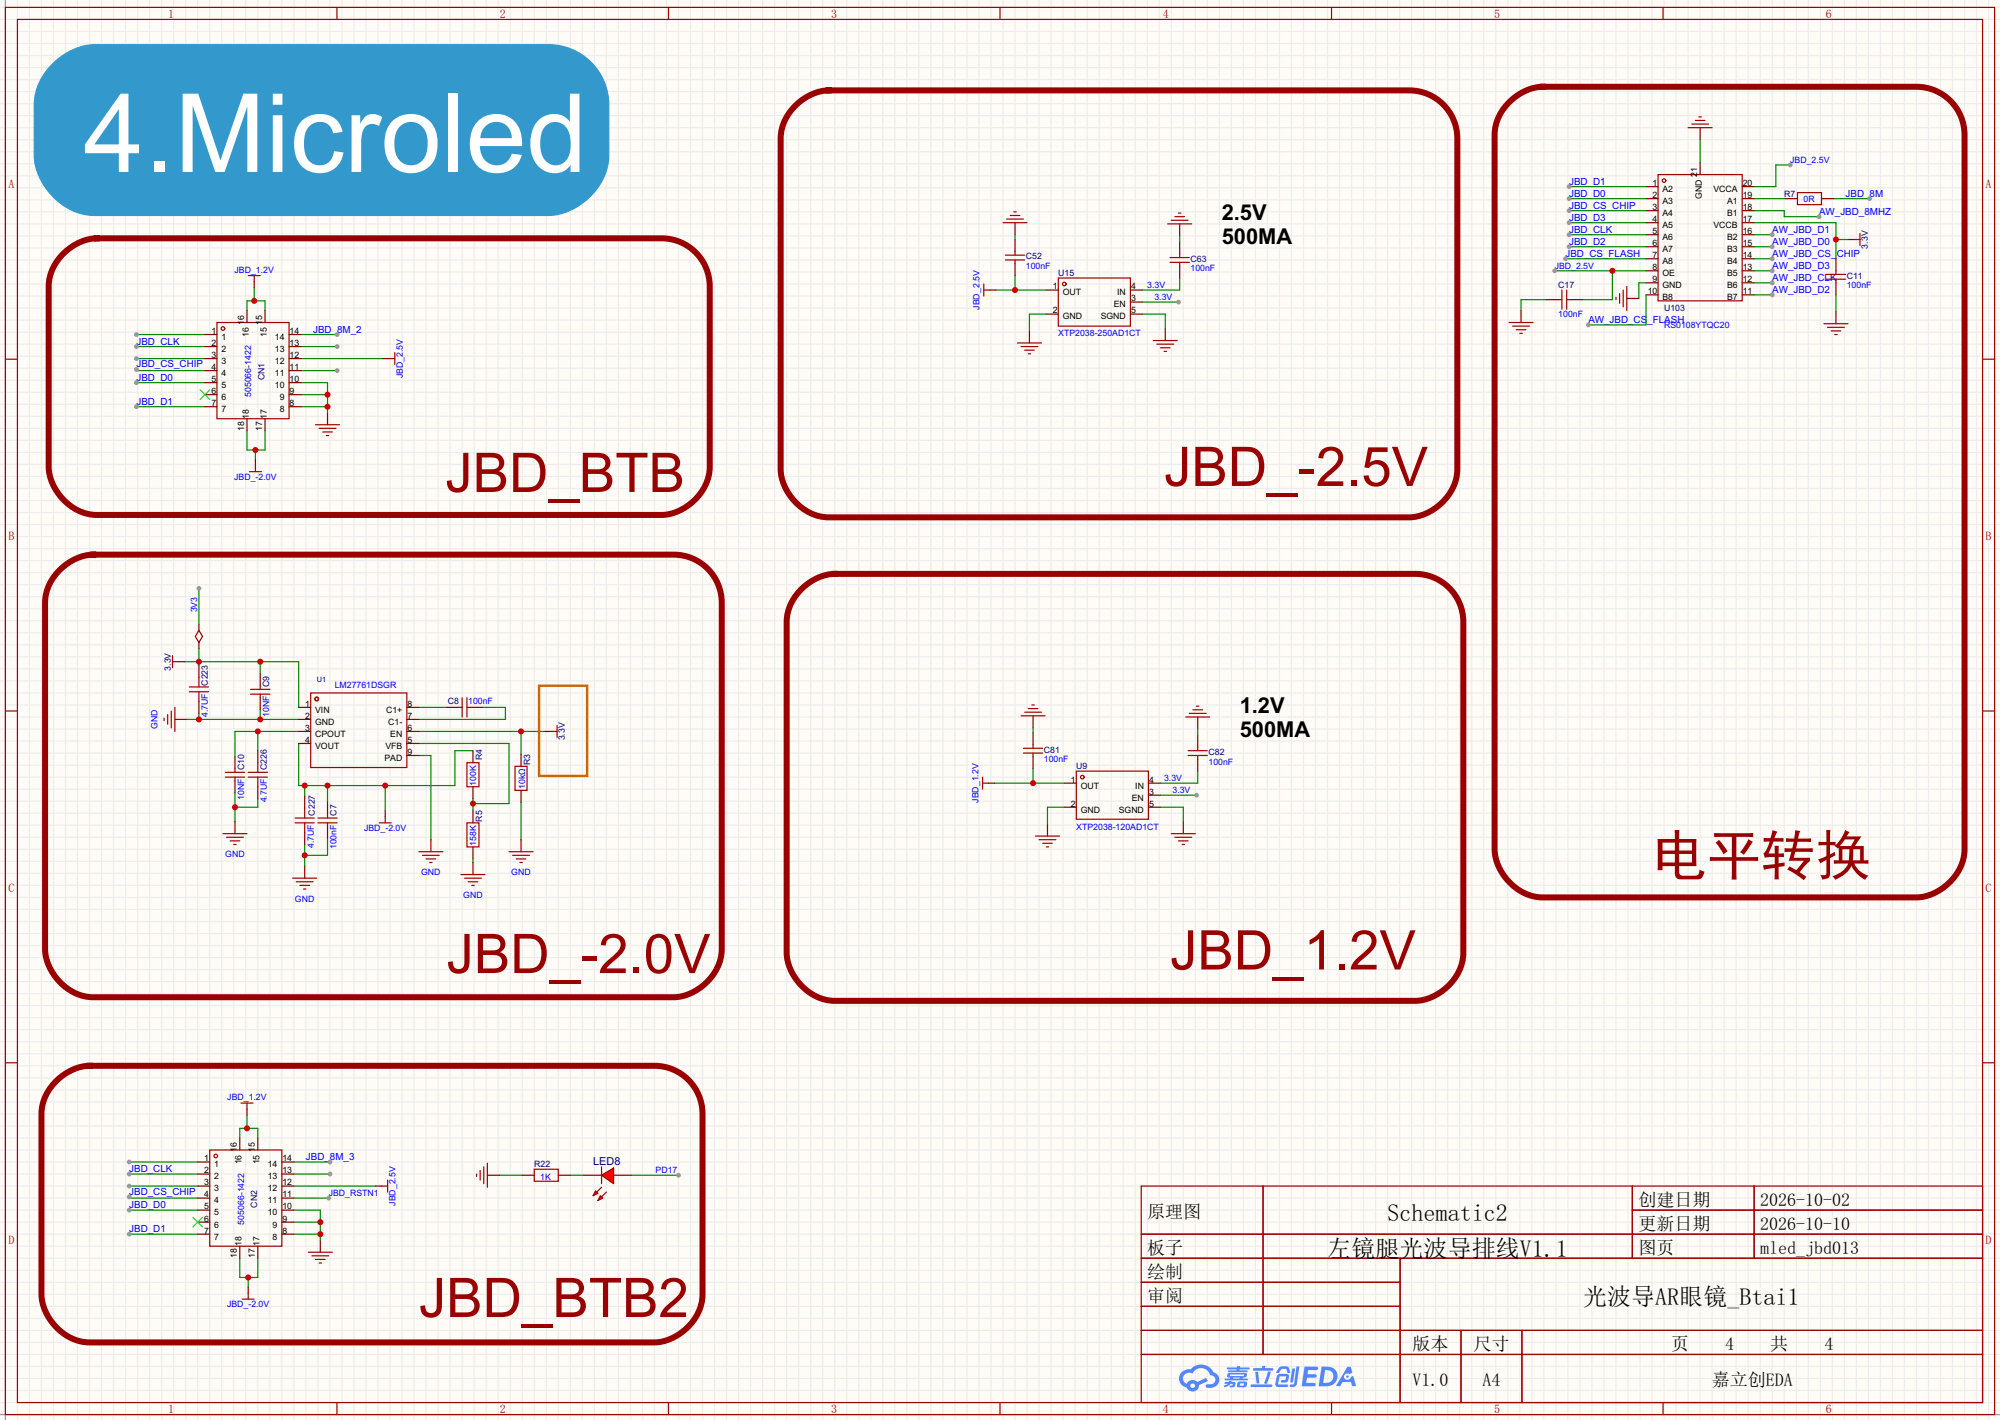
[picture p29: page 4]

JBD_CS_CHIP
JBD_D3
JBD_CLK JBD_D2 JBD_CS_FLASH

LM27761DSGR

VIN 1 GND 2 CPOUT 3 VOUT 4
