kemomi/Btai-AR/PDF_光波导AR眼镜_Btai1_PCB/SCH_Schematic4_2026-10-13.pdf

# 1.充电/电源

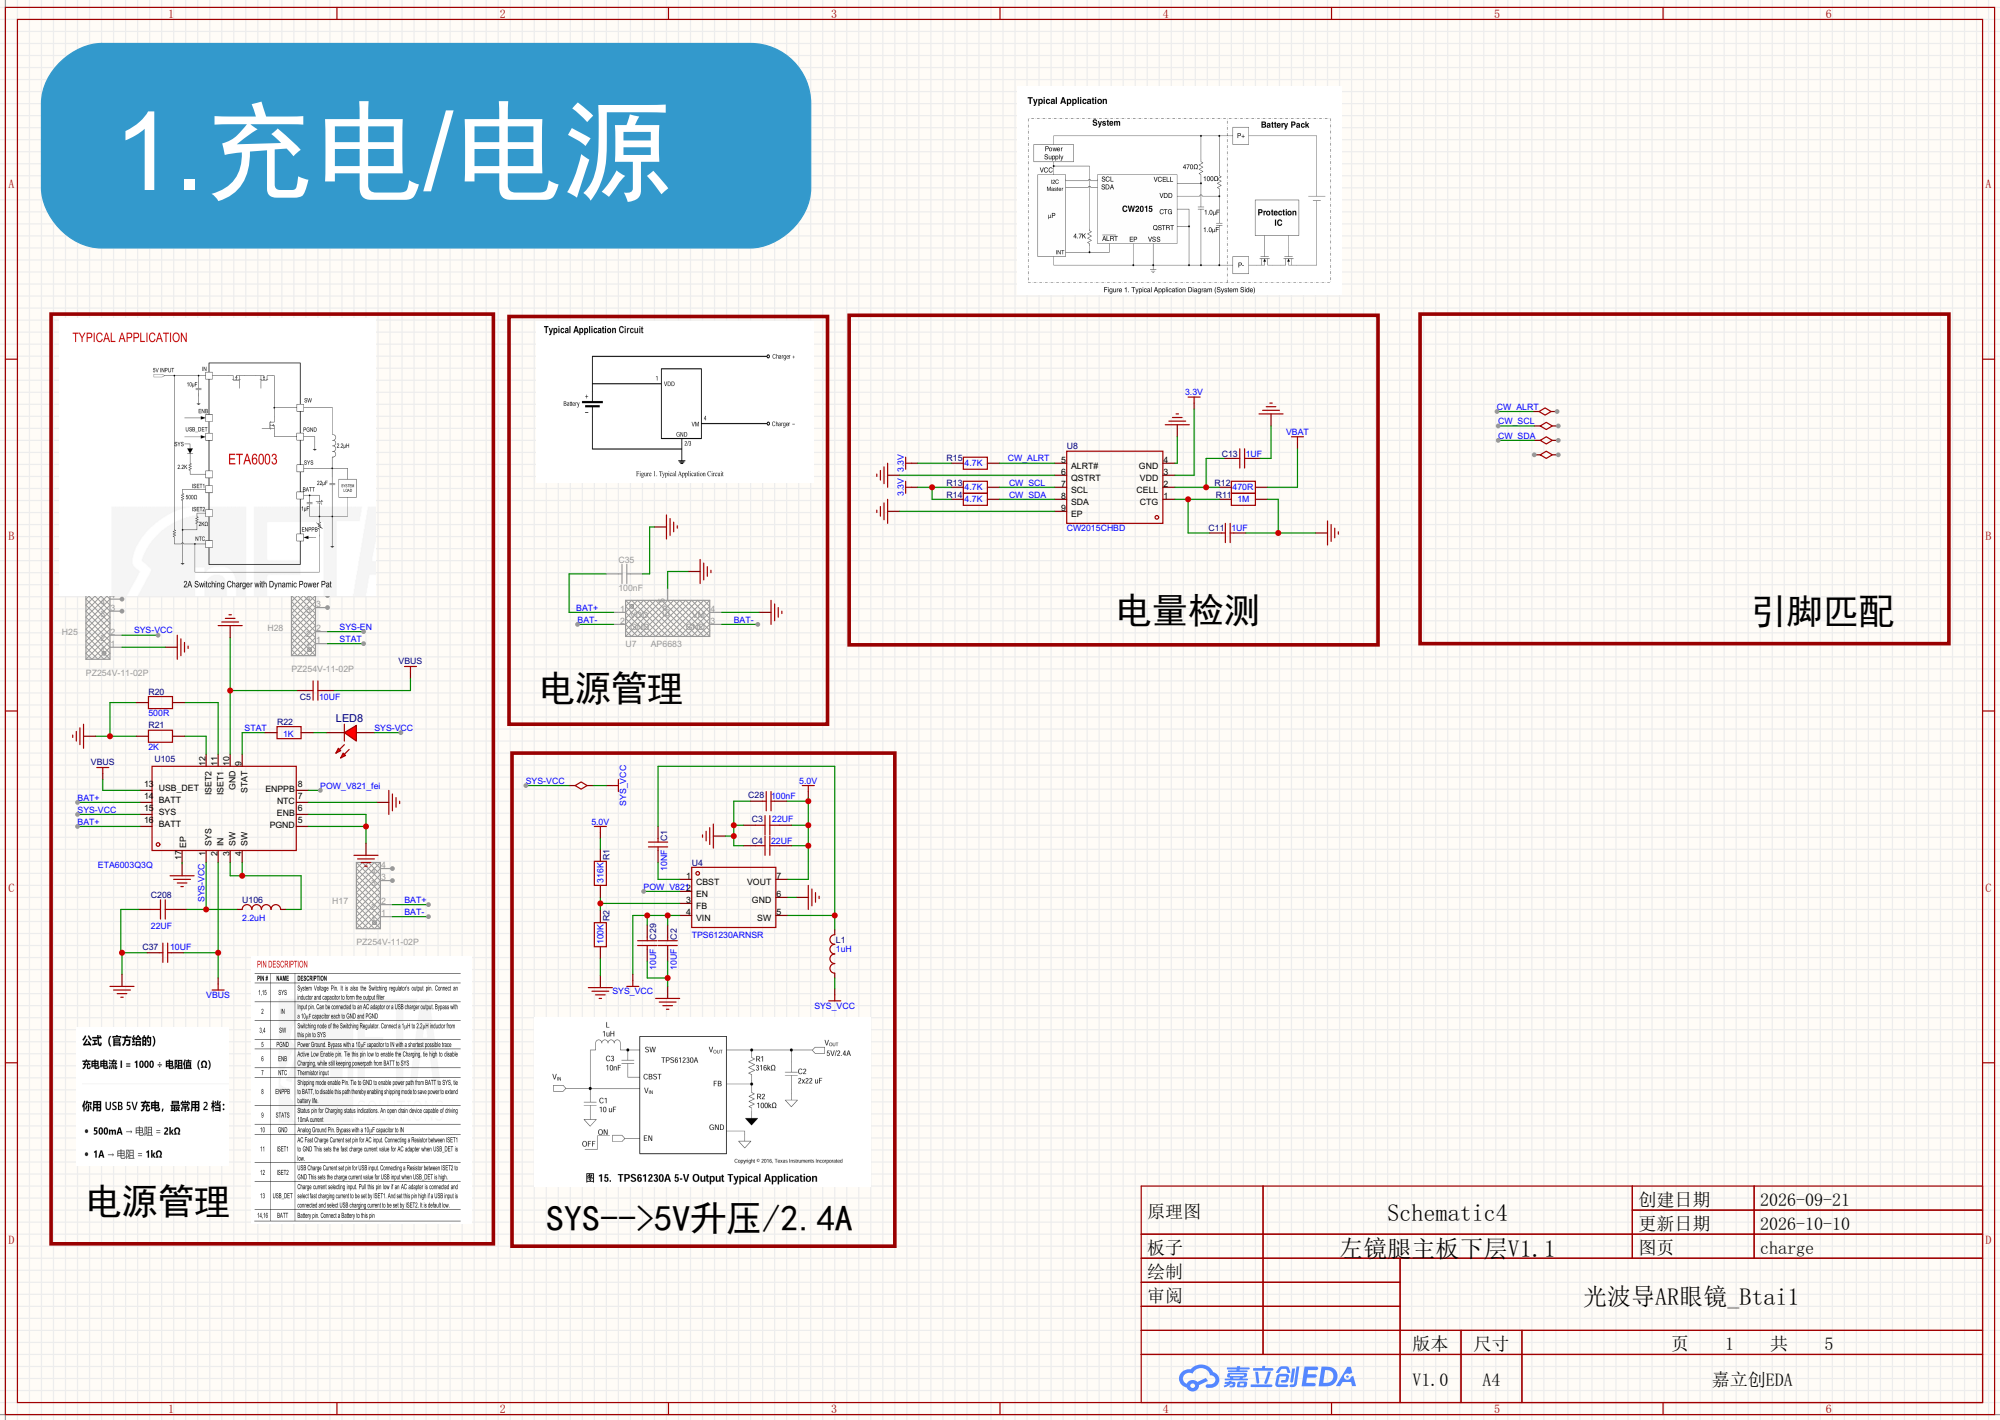
[picture p30: page 1]

# 1.连接器

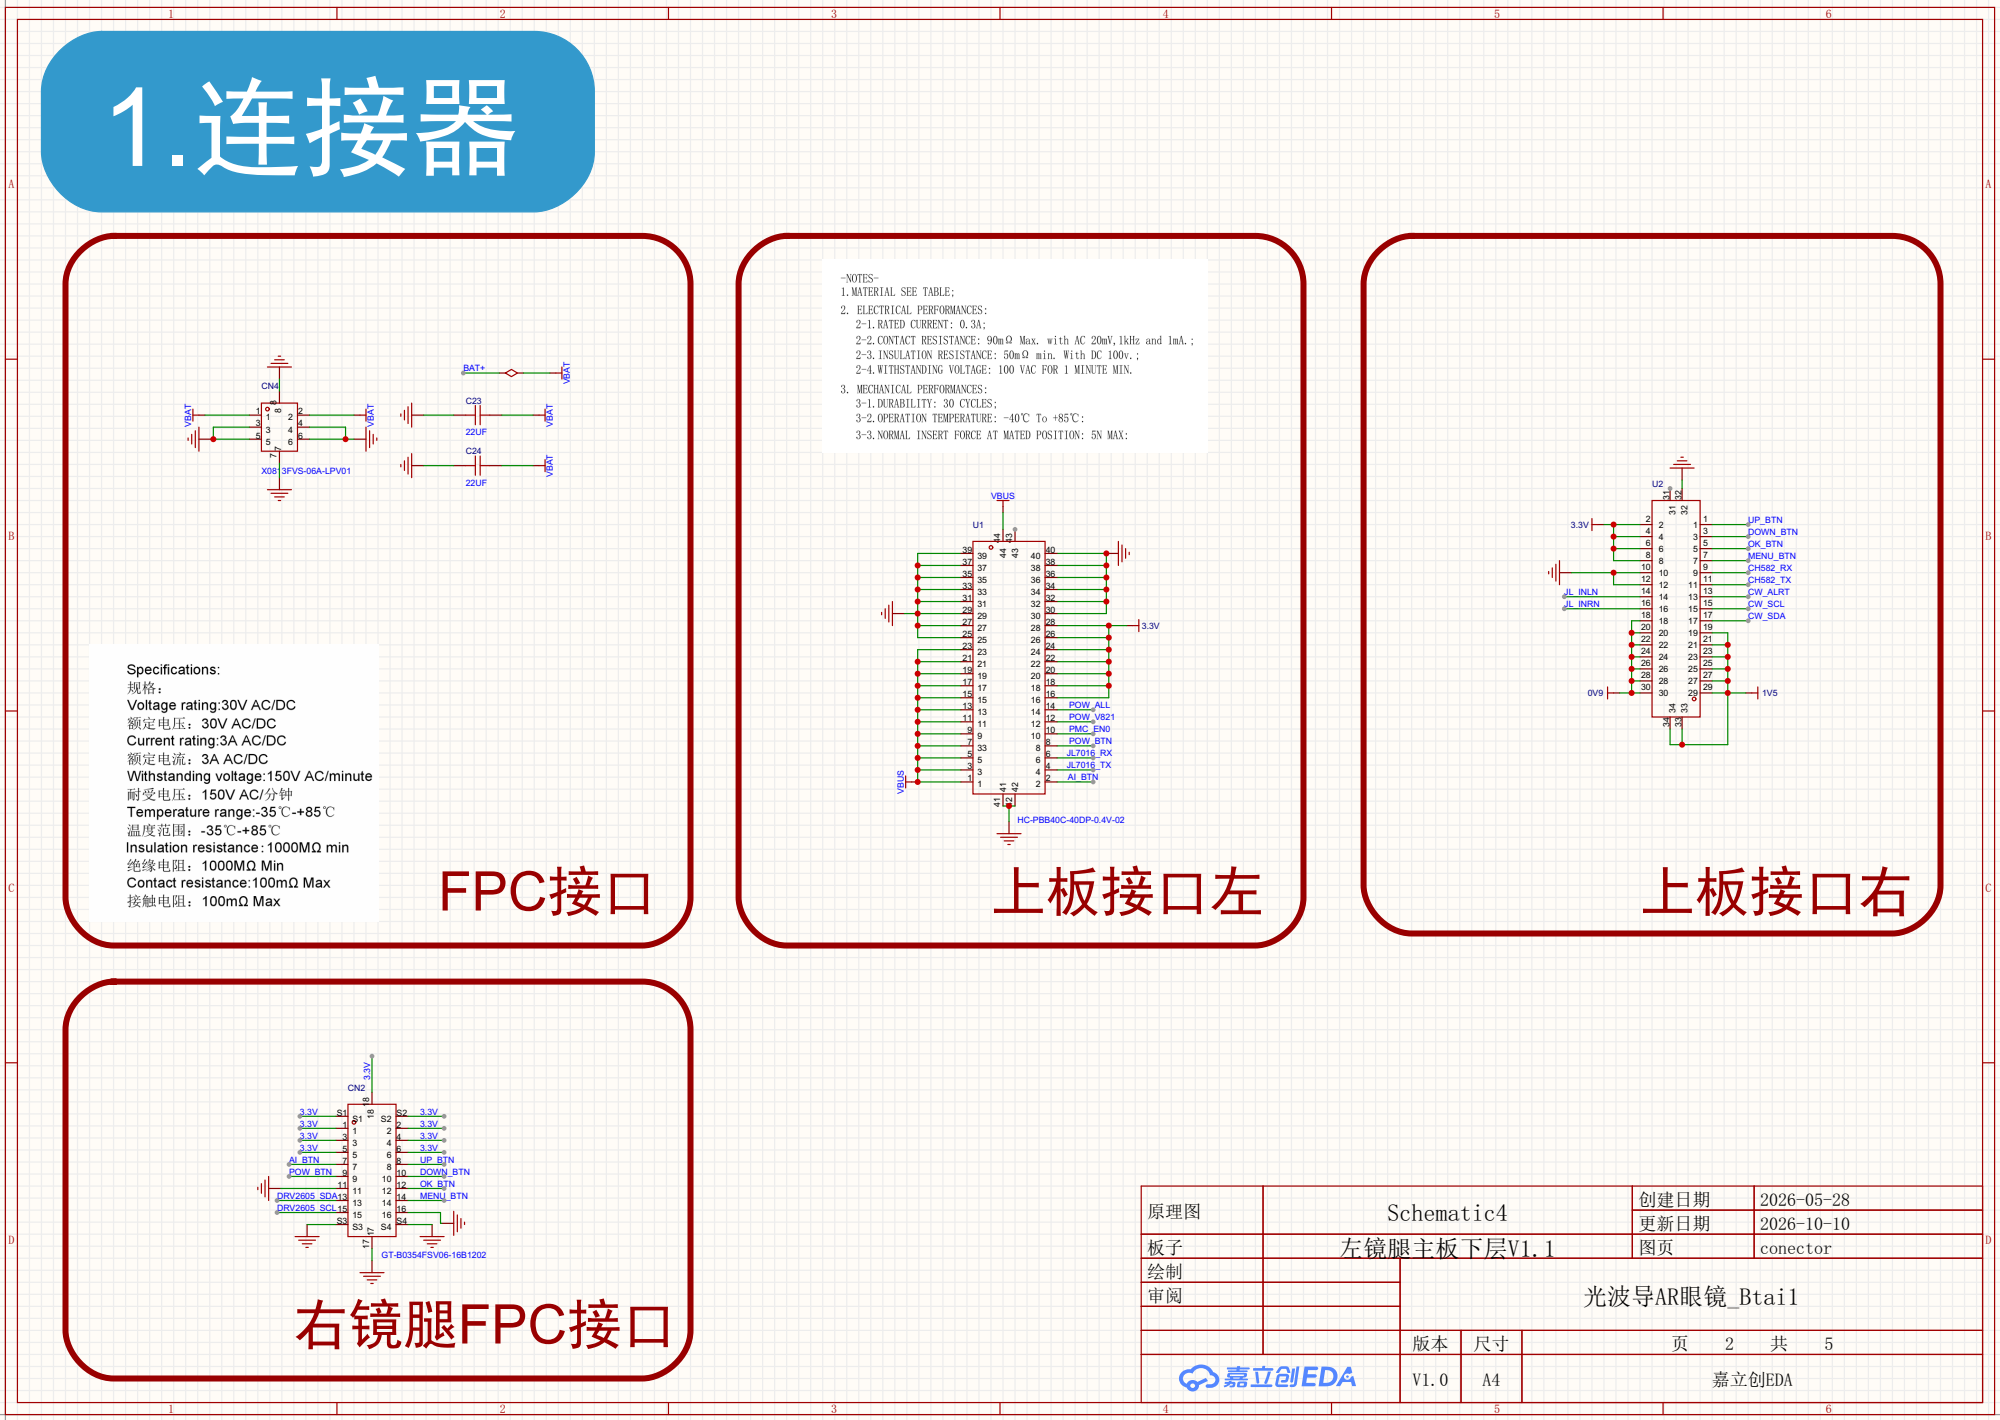
[picture p31: page 2]

# 3.power_main

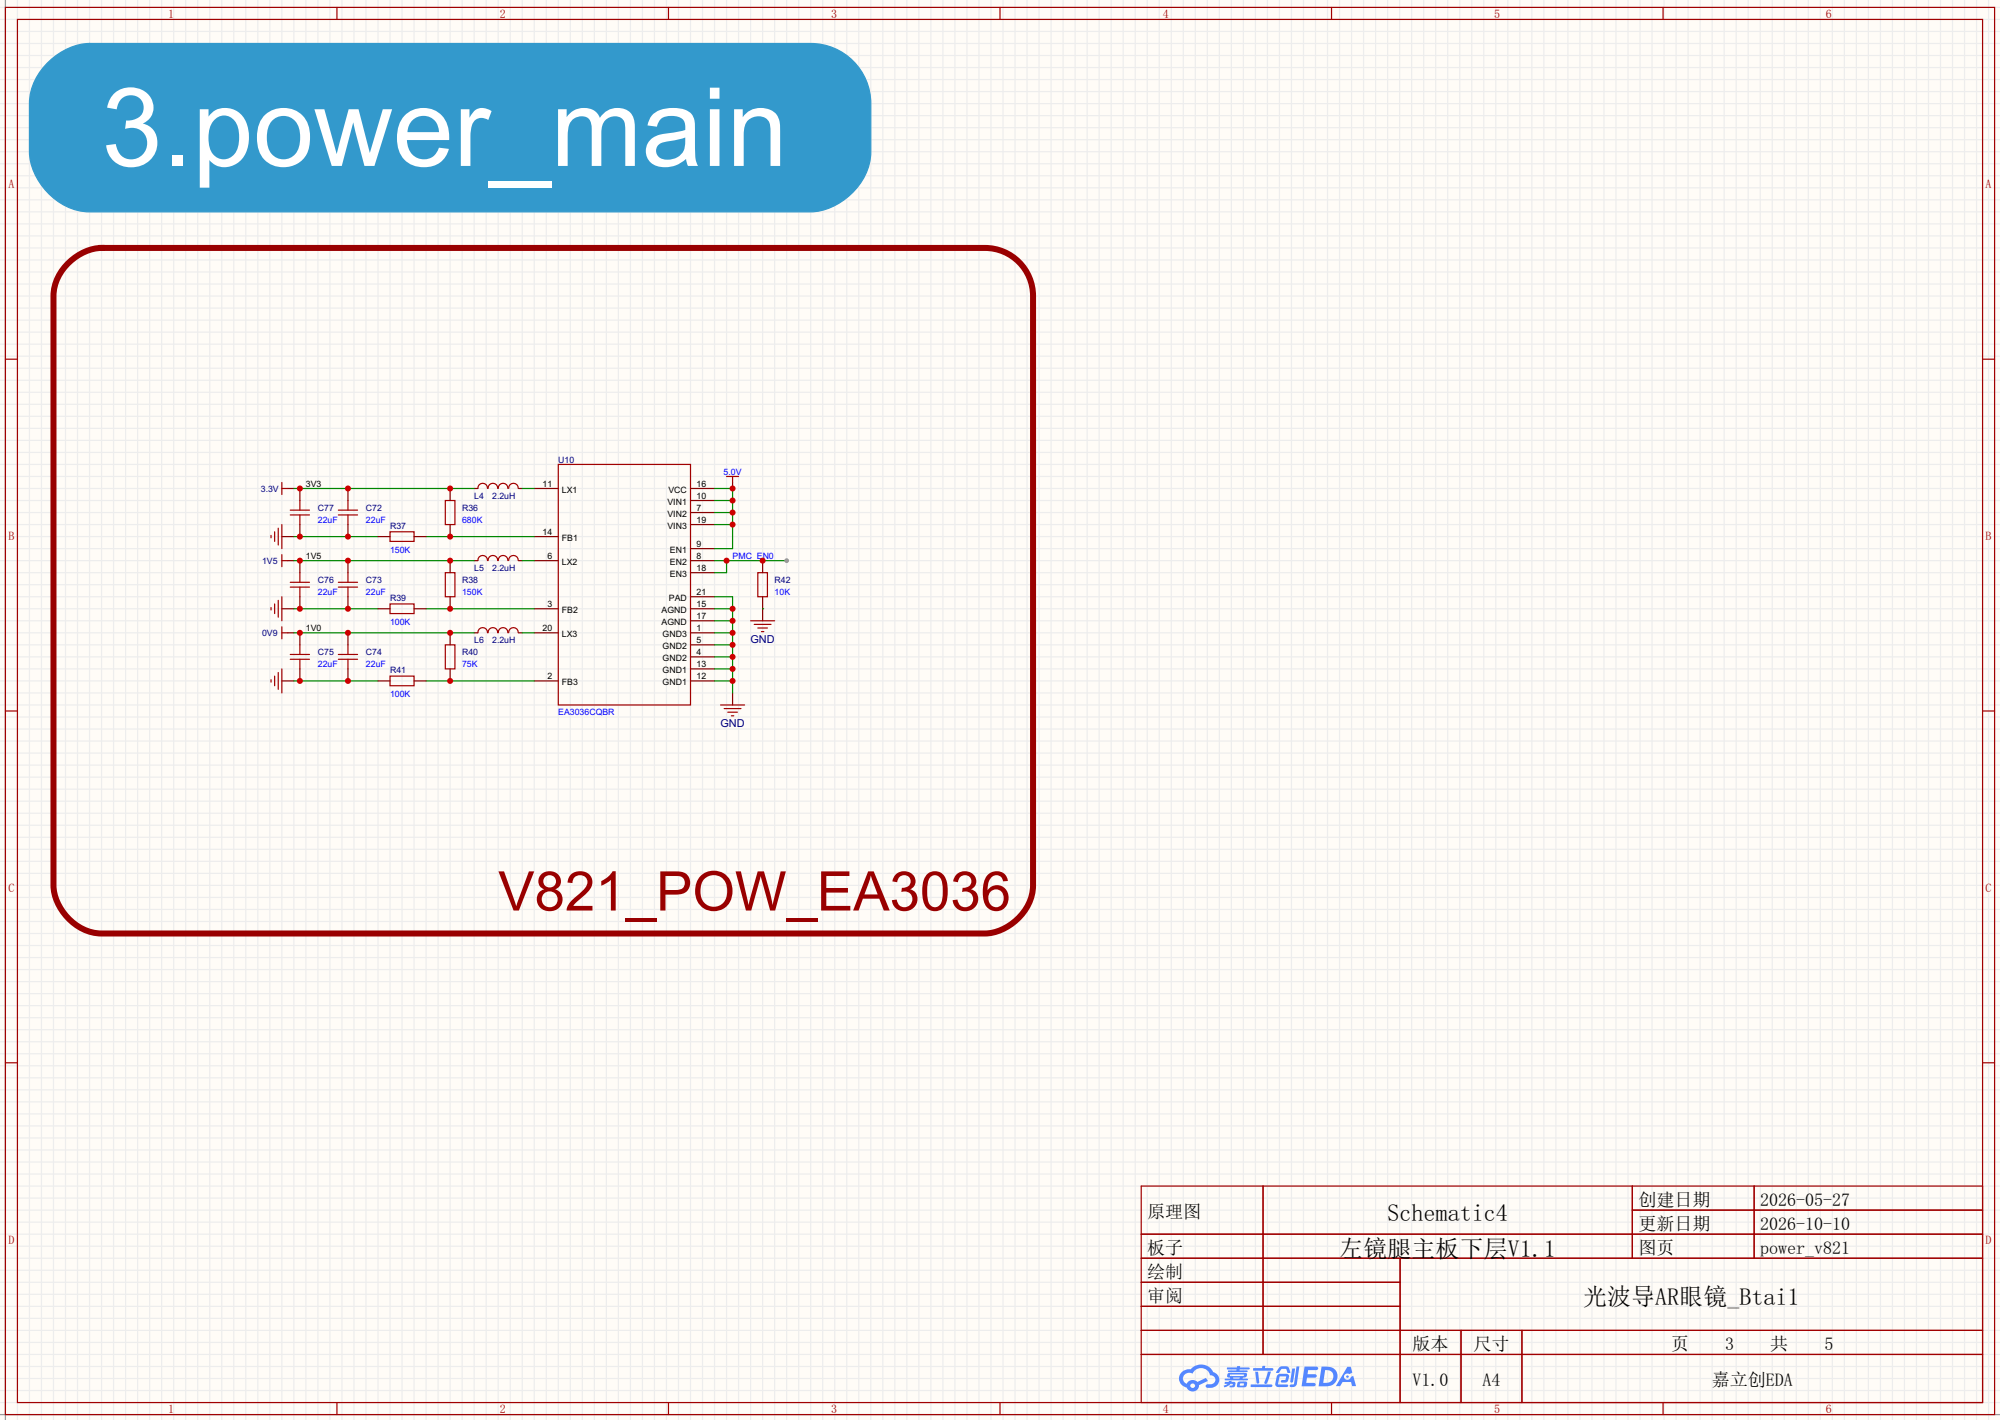
[picture p32: page 3]

VDCIA | VDCID

### VSW

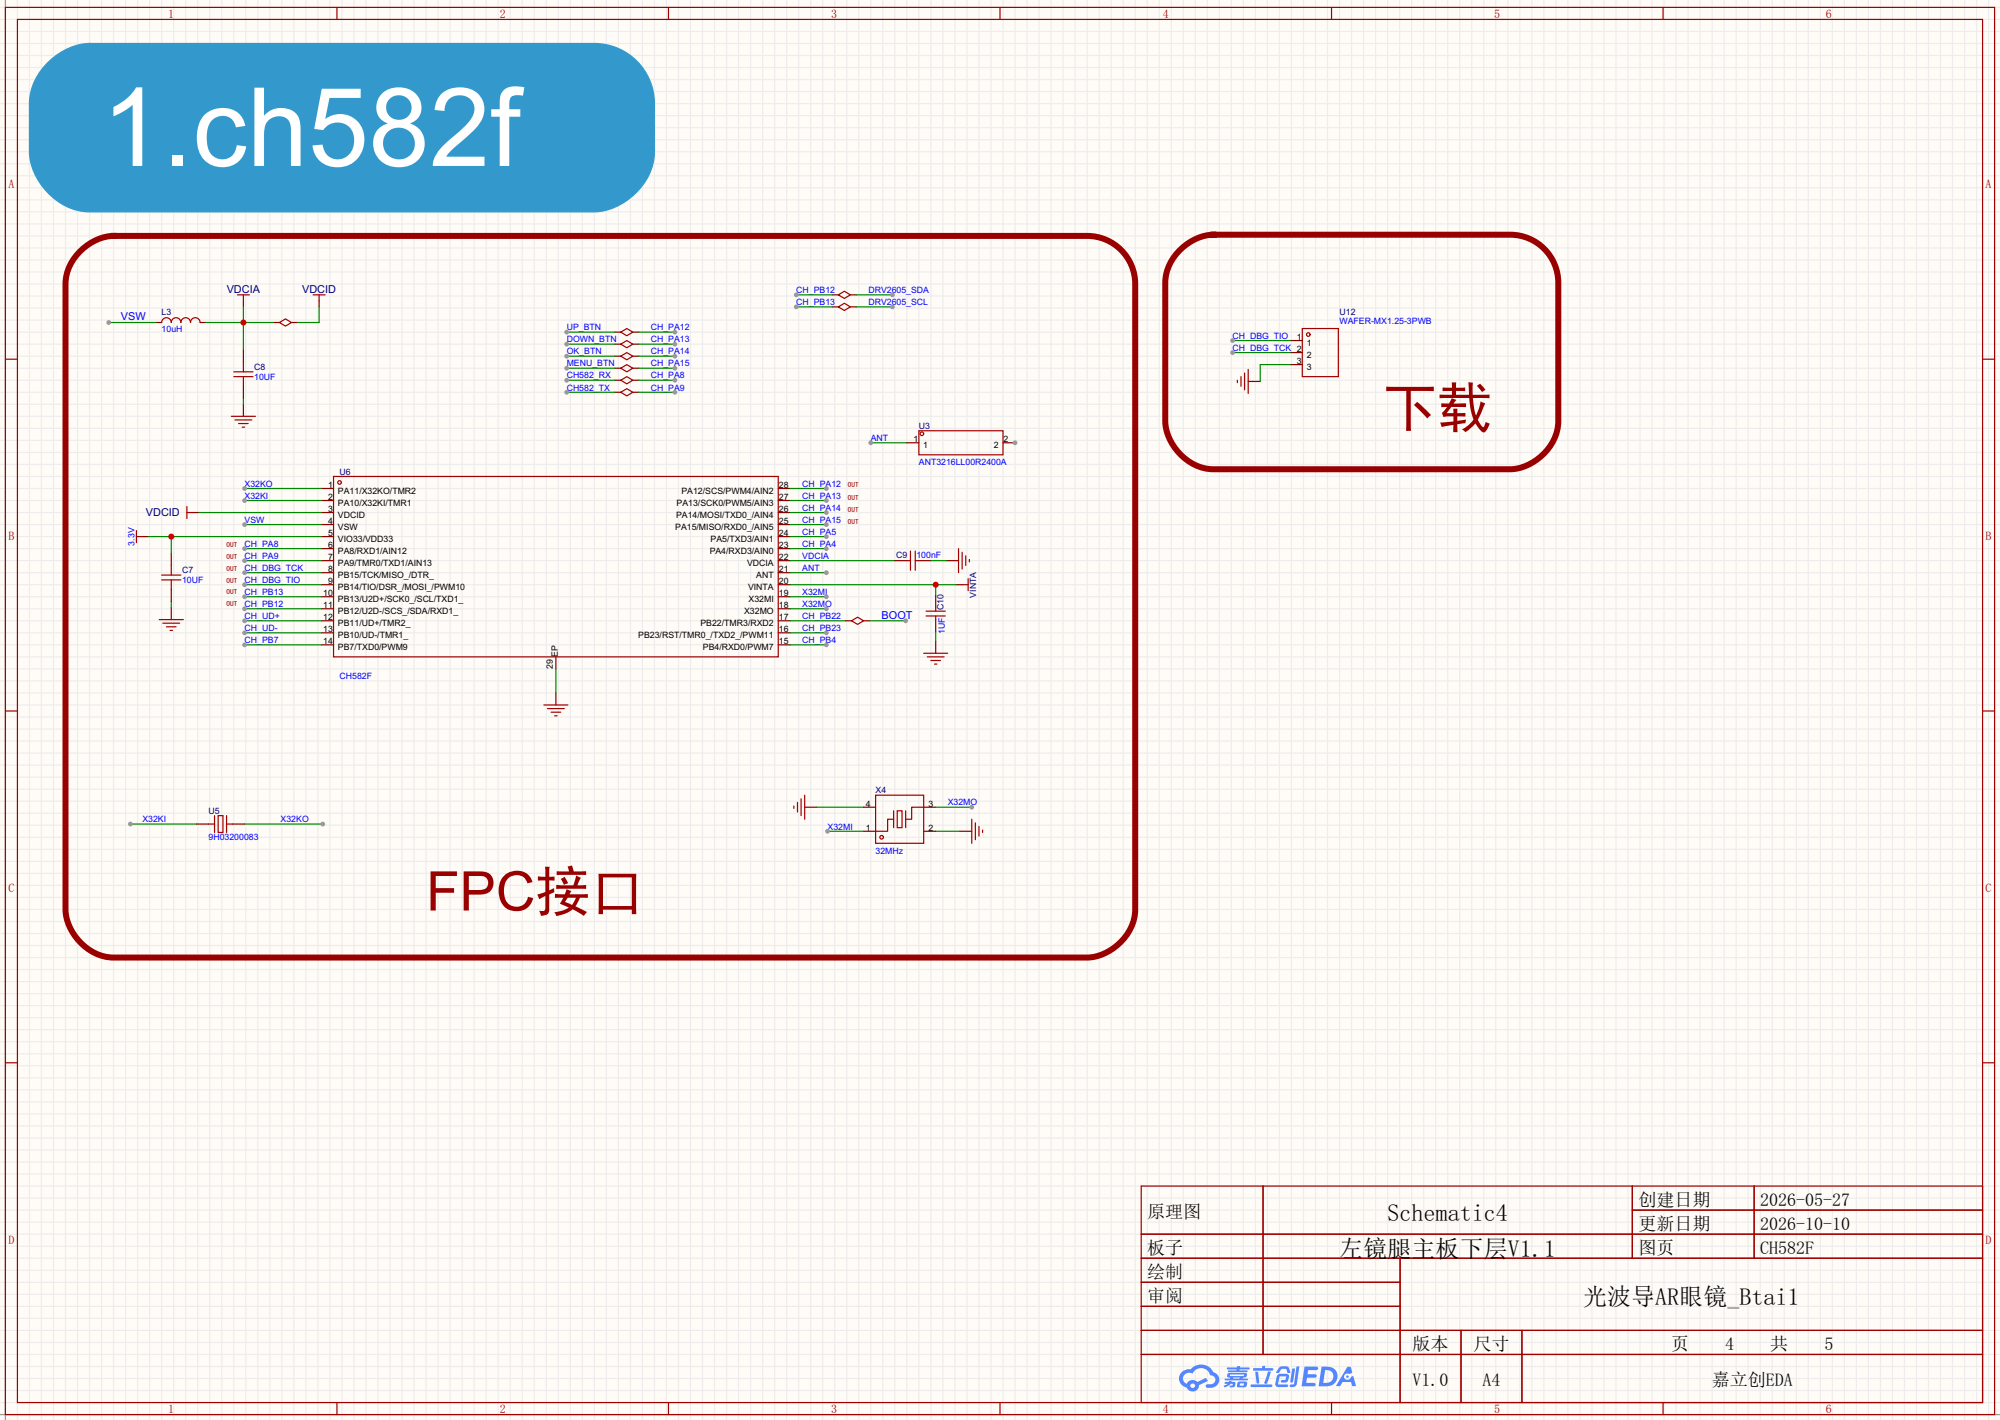
[picture p33: page 4]

CH_DBG_TCK | 2

# 4.JL7016G8

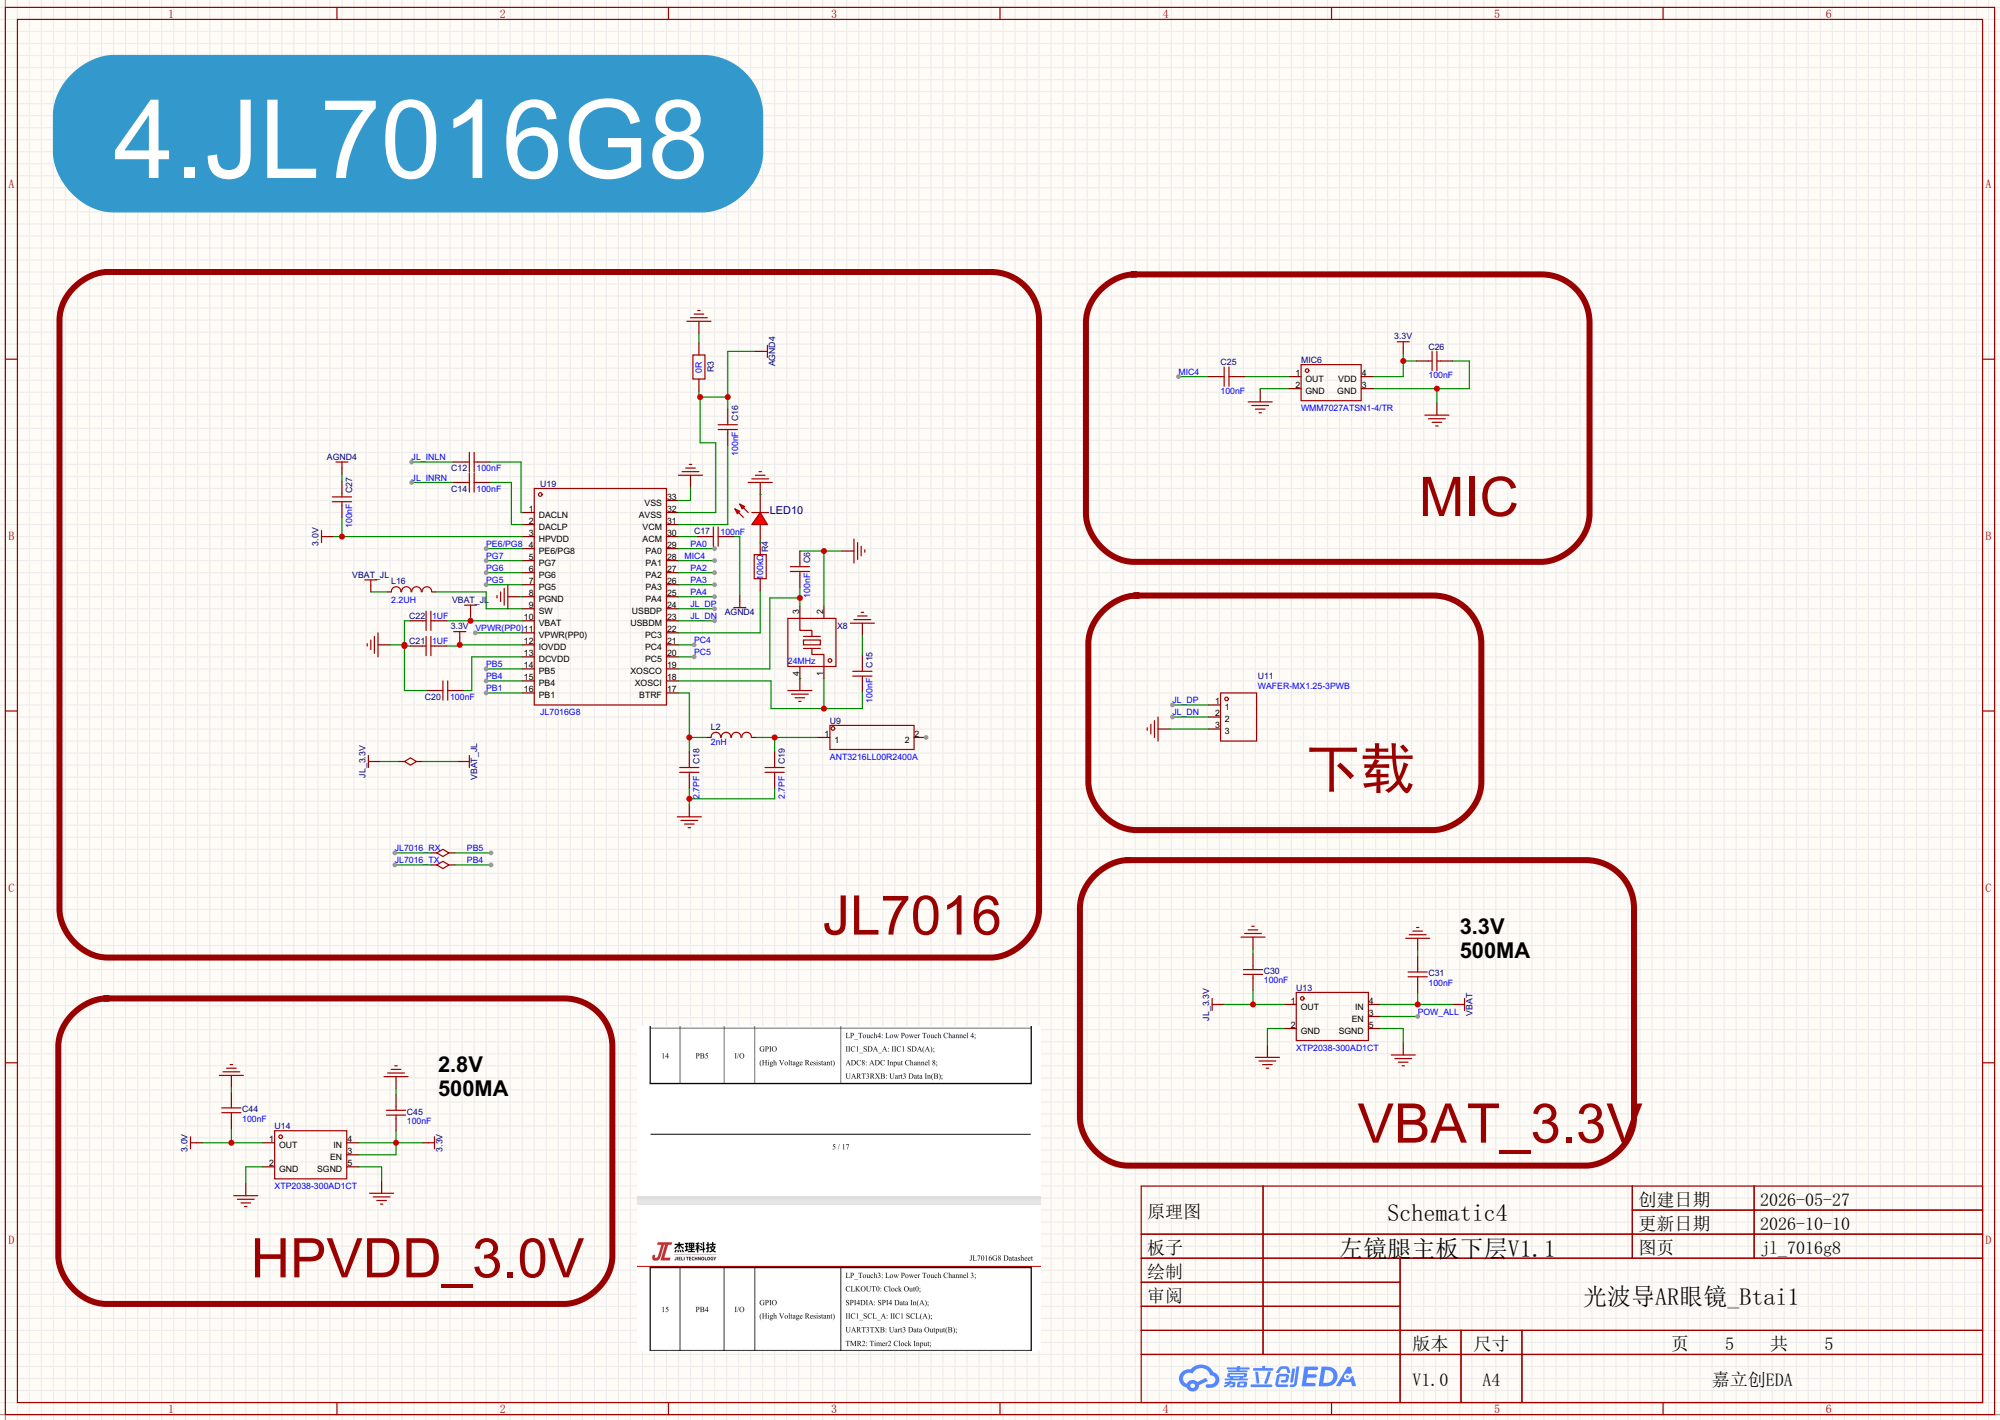
[picture p34: page 5]

MIC4 | PA2 PA3 PA4
