kemomi/Btai-AR/PDF_光波导AR眼镜_Btai1_PCB/SCH_Schematic10_2026-10-13.pdf

# 1.touch

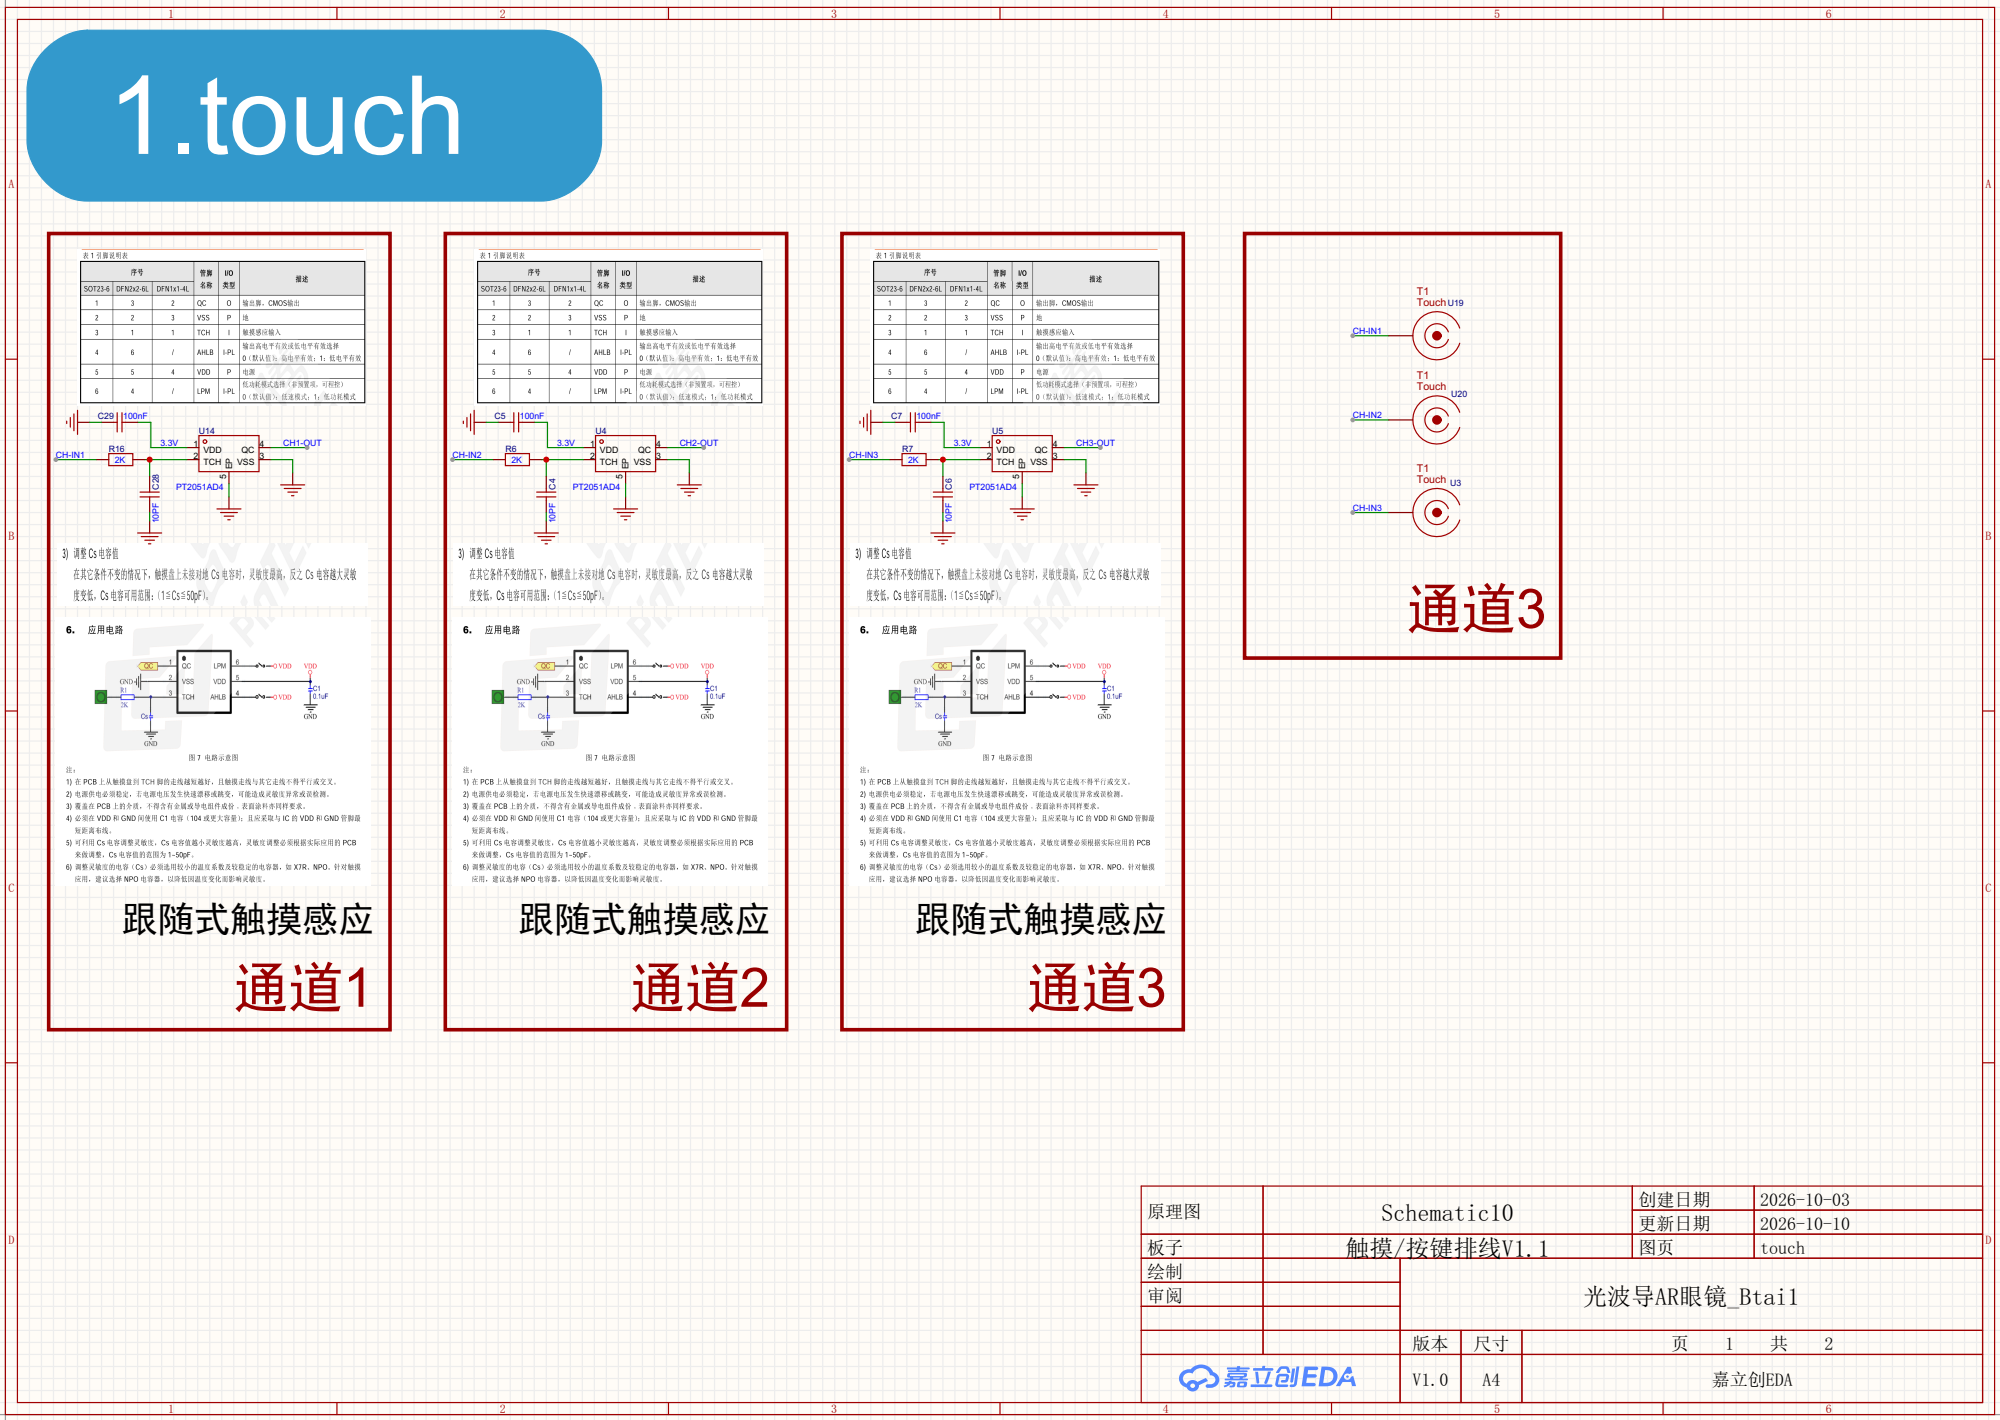
[picture p35: page 1]

# 2.conector

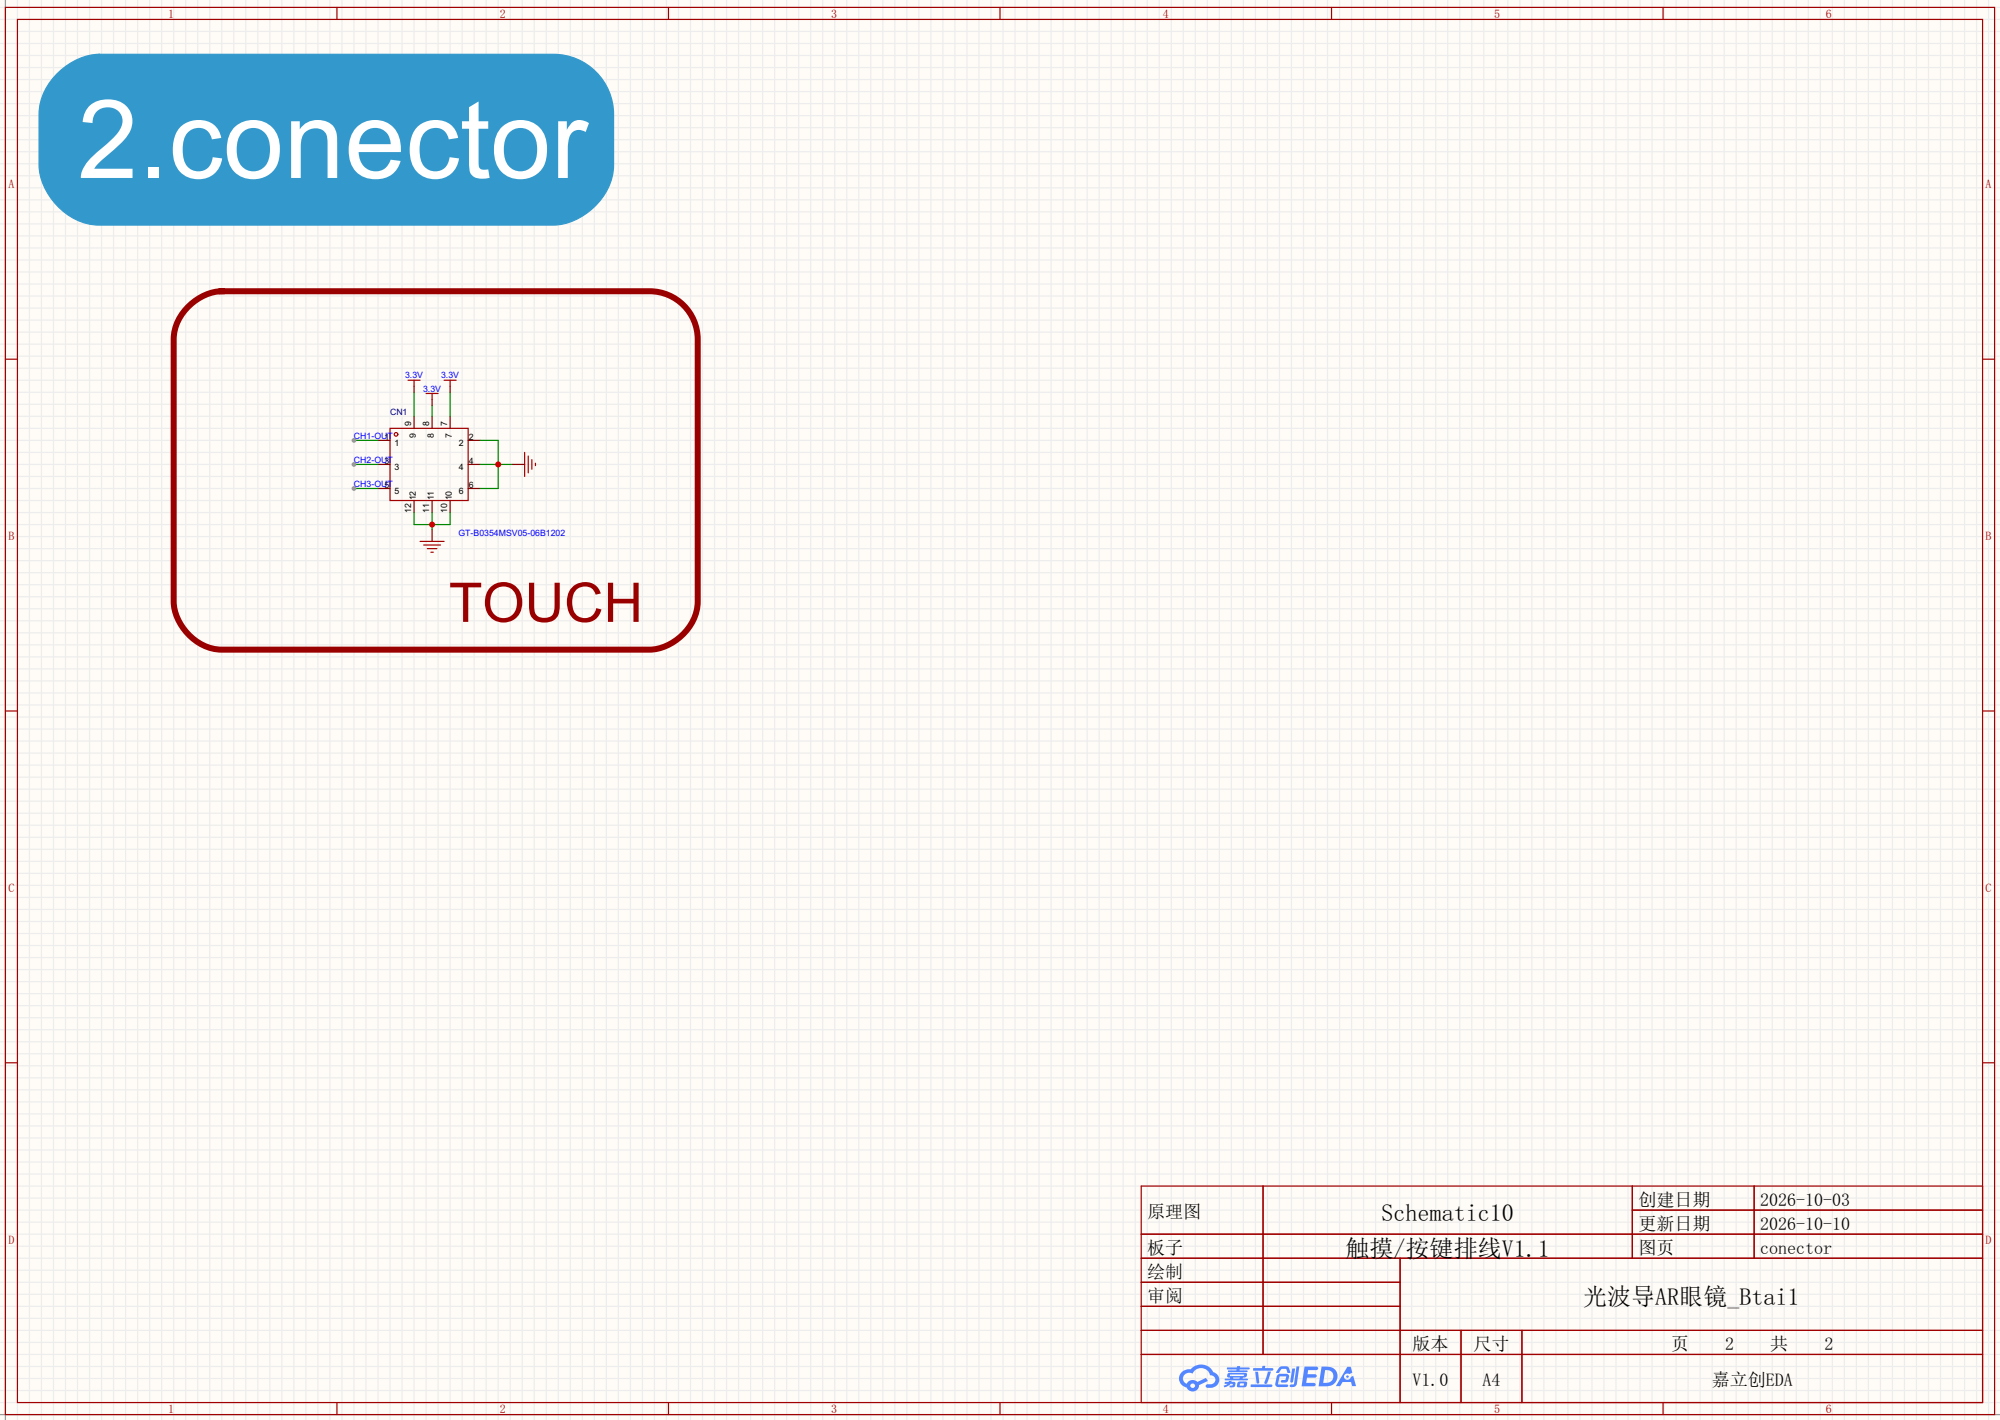
[picture p36: page 2]
