kemomi/Btai-AR/PDF_光波导AR眼镜_Btai1_PCB/SCH_Schematic12_2026-10-13.pdf

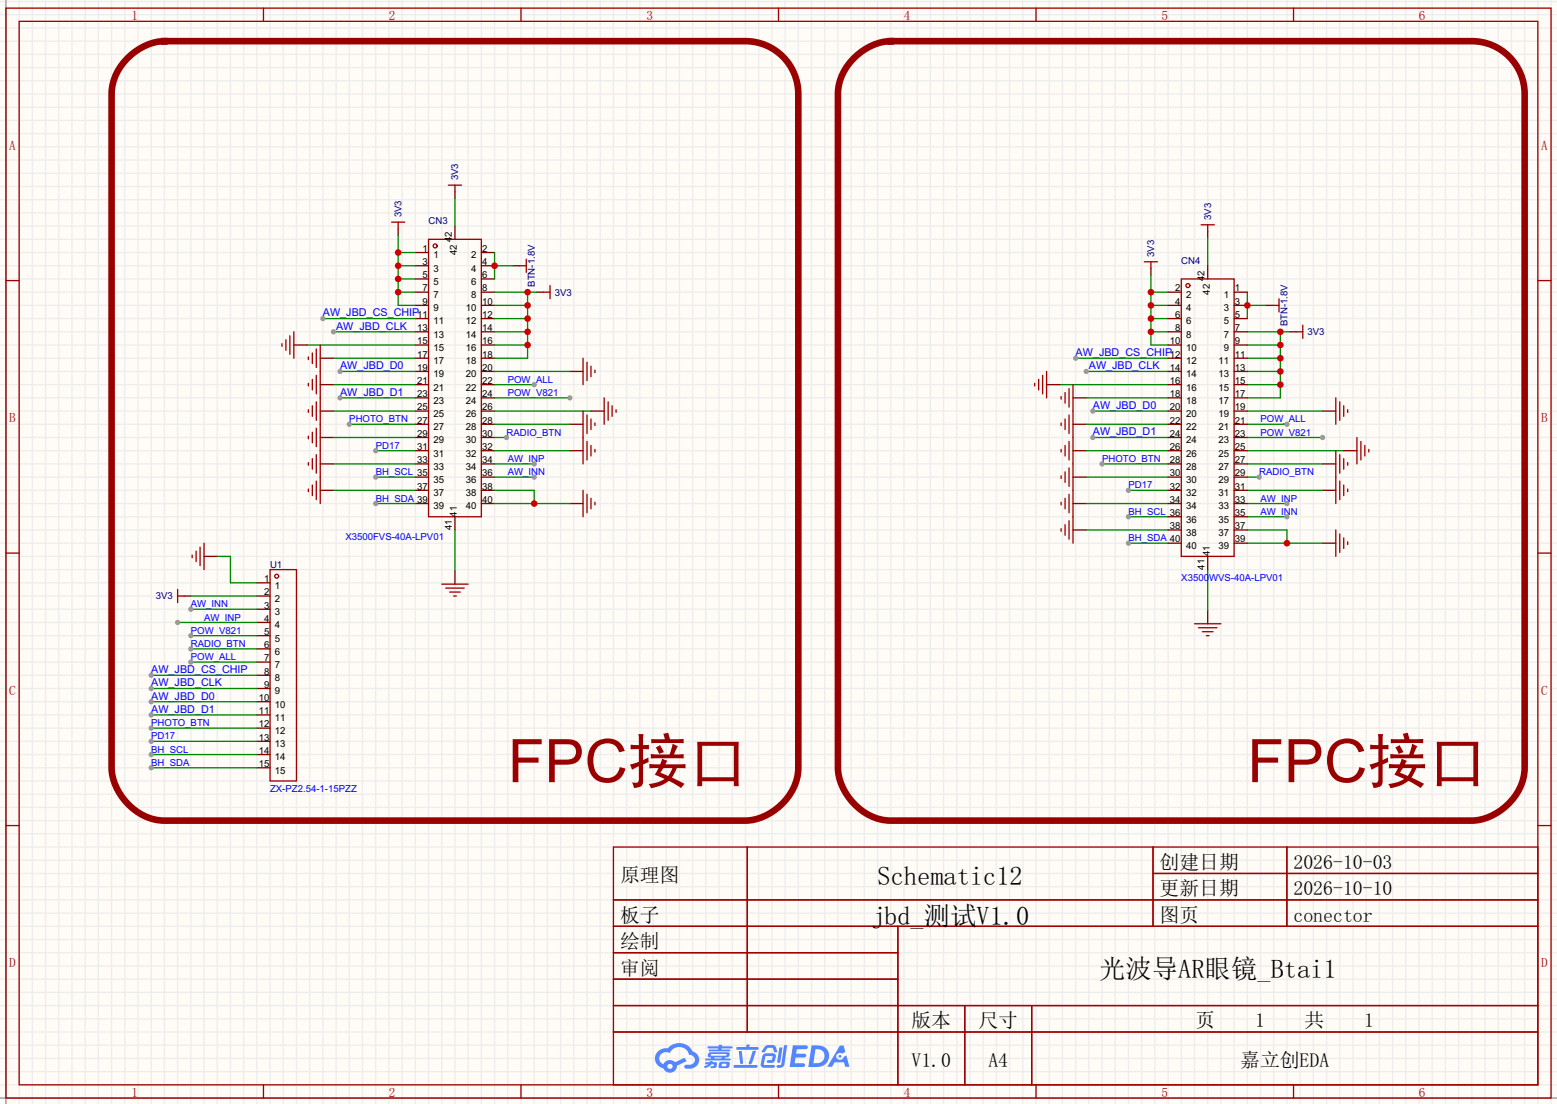
[picture p37: page 1]

3 | 1 | 2 | 4 | | | | | | | | | CN4
BH_SDA | | 39 39 | 40 | 40 | | 0 | | | | | 图页 | | 34 34 | 33 | 33 | AW_INP | conector BTN⁻¹.8V

AW_JBD_CS_CHIP | | | | | 9 11 11 | 12 | 12 | | | | | | | | 6 | 4 | 3 | 5
AW_JBD_CLK | | | | 13 13 | 14 | 14 | | | | | | | | 8 | 6 | 5 | 7

15 15 | 16 | 16 | | | | | | | | | 8 10 10 | 7 | 9
17 17 | 18 | 18 | | | AW_JBD_CS_CHIP | | | | | | 12 12 | 9 11 | 11
22 20 | 22 21 21 20 | POW_ALL | | | | | | | | 16 16 | 15 | 15

AW_JBD_D0 | | | | 19 19 | | | | | | AW_JBD_CLK | | | | | 14 14 | 13 | 13

AW_JBD_D1 | | | | 23 23 | 24 | 24 | POW_V821 | | | | | | | | 18 18 | 17 | 17

B | | | PHOTO_BTN | | | 27 27 | 28 | 28 | | | | | | | | | | 21 19 | 21 22 22 19 | POW_ALL | | B

25 25 | 26 | 26 | | | | AW_JBD_D0 | | | | | 20 20

29 29 | 30 | 30 | RADIO_BTN | | | AW_JBD_D1 | | | | | 24 24 | 23 | 23 | POW_V821

33 33 | 34 | 34 | AW_INP | | | | PHOTO_BTN | | | | 28 28 | 27 | 27

BH_SCL | | 35 35 | 36 | 36 | AW_INN | | | | | | | | 30 30 | 29 | 29 | RADIO_BTN

BH_SCL | | | 36 36 | 35 | 35 | AW_INN

X3500FVS-40A-LPV01 | BH_SDA | 40 40 | 39 | 39

U1
1 | | | | | | X3500WVS-40A-LPV01

AW_INN | | 3 | 2
AW_INP | 4 | 3
POW_V821 | | 5 | 4
RADIO_BTN | | 6 | 5
POW_ALL | | 7 | 6
BH_SCL | | | | 14 14 | P | C | 接 | 口 | | F | P | C | 接 | 口
PD17 | | | | 13 13

AW_JBD_CS_CHIP | | | 8 | 7

C | AW_JBD_CLK | | | 9 | 8 | | | | | | | | | | | C

AW_JBD_D0 | | | | 9 10 10
AW_JBD_D1 | | | | 11 11
PHOTO_BTN | | | | 12 12

BH_SDA | | | | 15 15

更新日期 | | | | | | | 2026-10-10

板子 | j | b | d | _ | 测 | 试 | V | 1 | .
绘制
