kemomi/Btai-AR/PDF_光波导AR眼镜_Btai1_PCB/SCH_Schematic14_2026-10-13.pdf

10 | 10 11 | 11 12 | 12 13 | 13 14 | 14

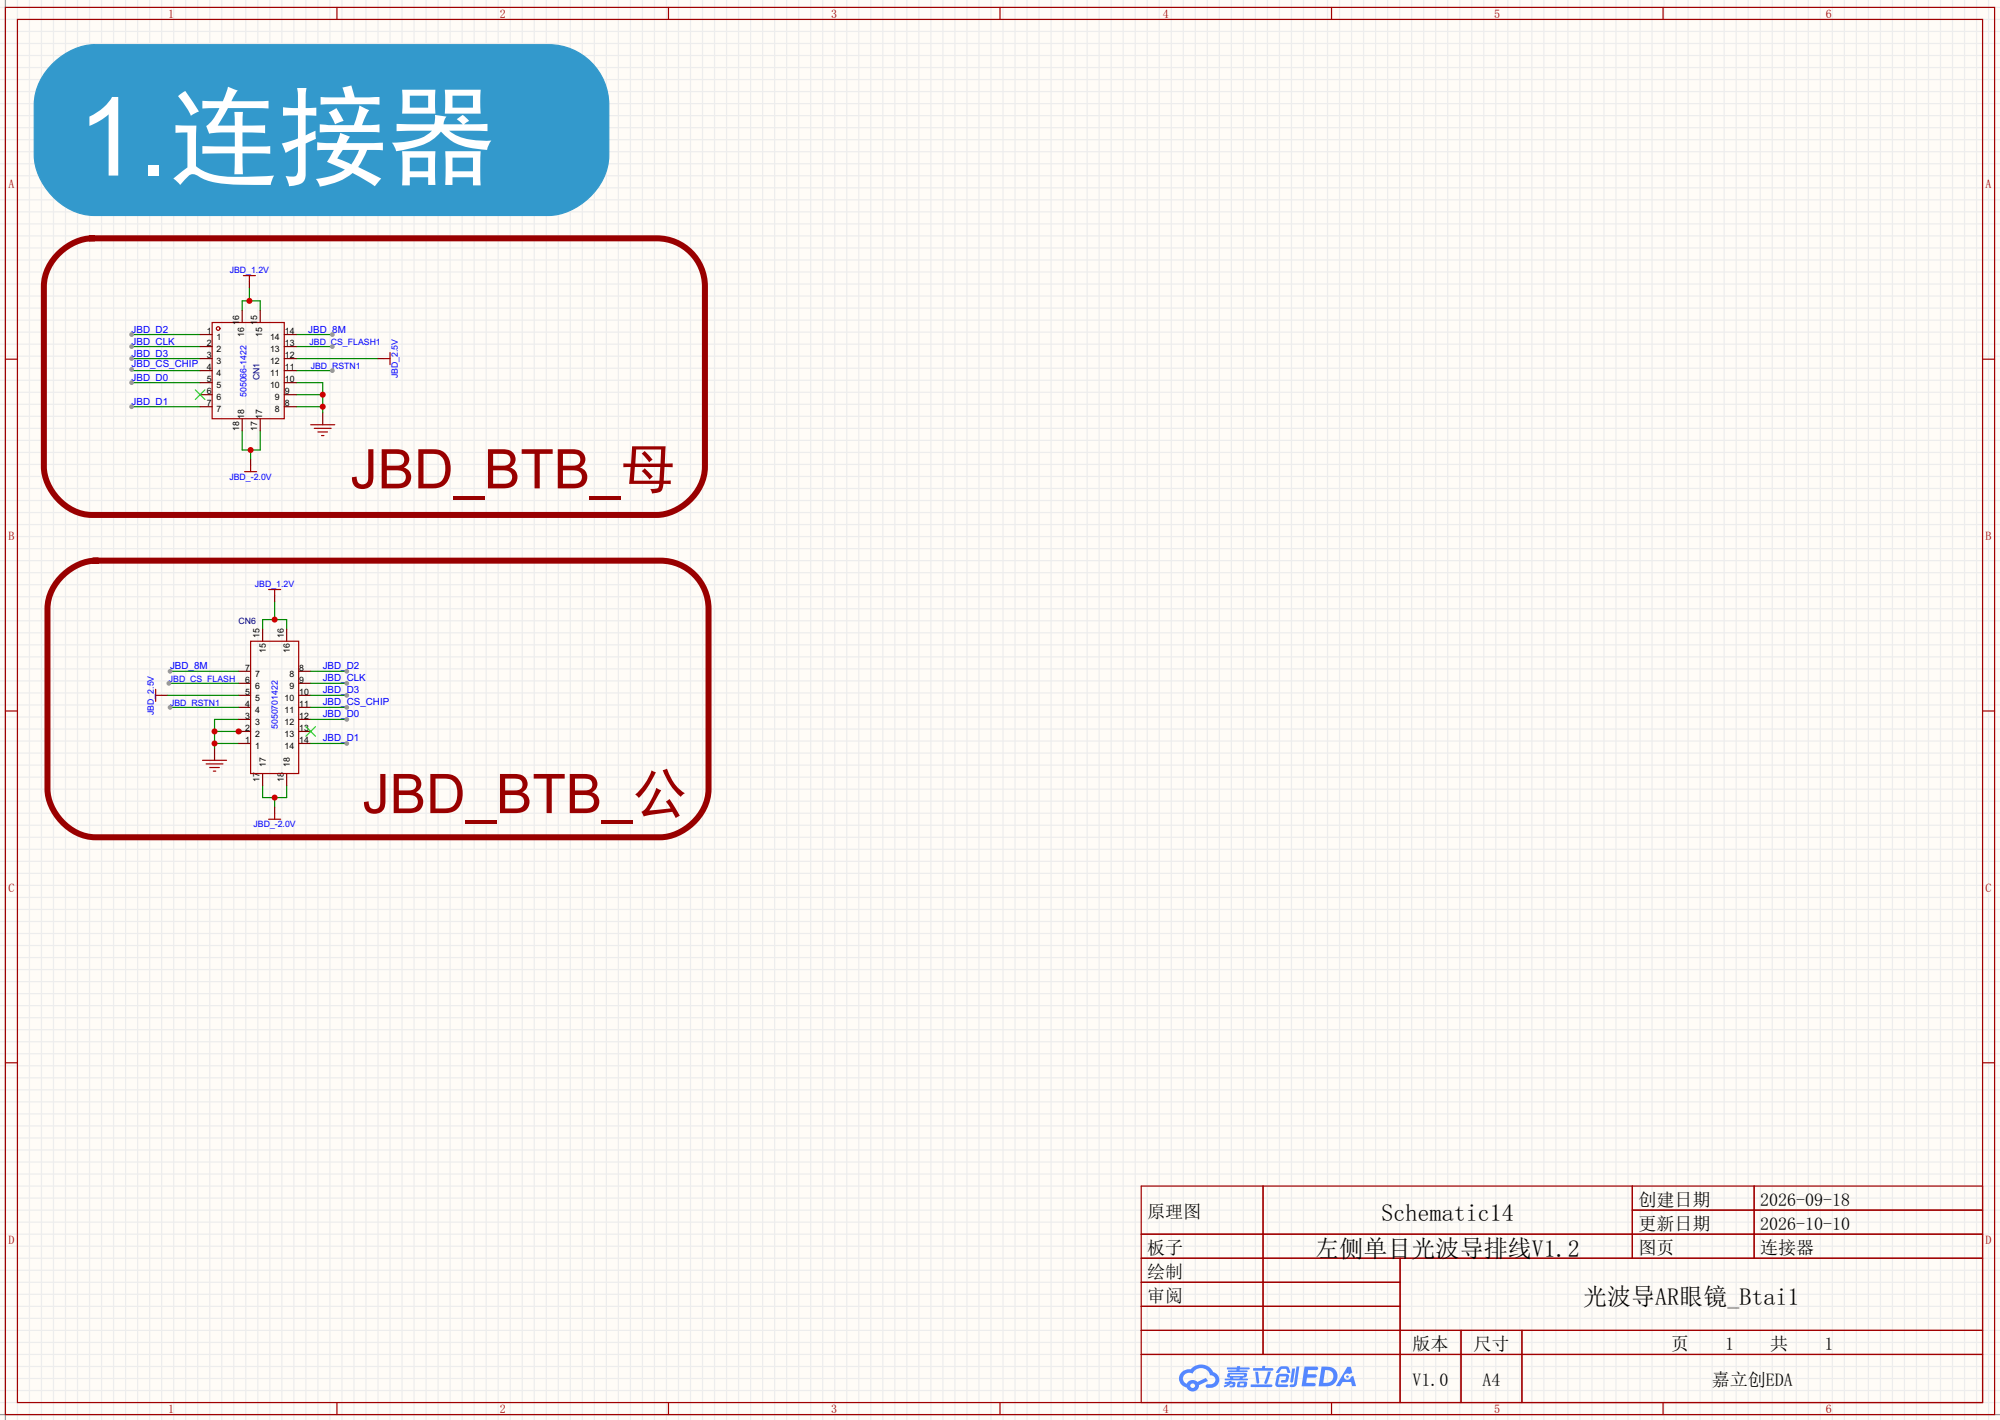
[picture p38: page 1]

JBD_RSTN1 | JBD_D2
