kemomi/Btai-AR/PDF_光波导AR眼镜_Btai1_PCB/SCH_Schematic15_2026-10-13.pdf

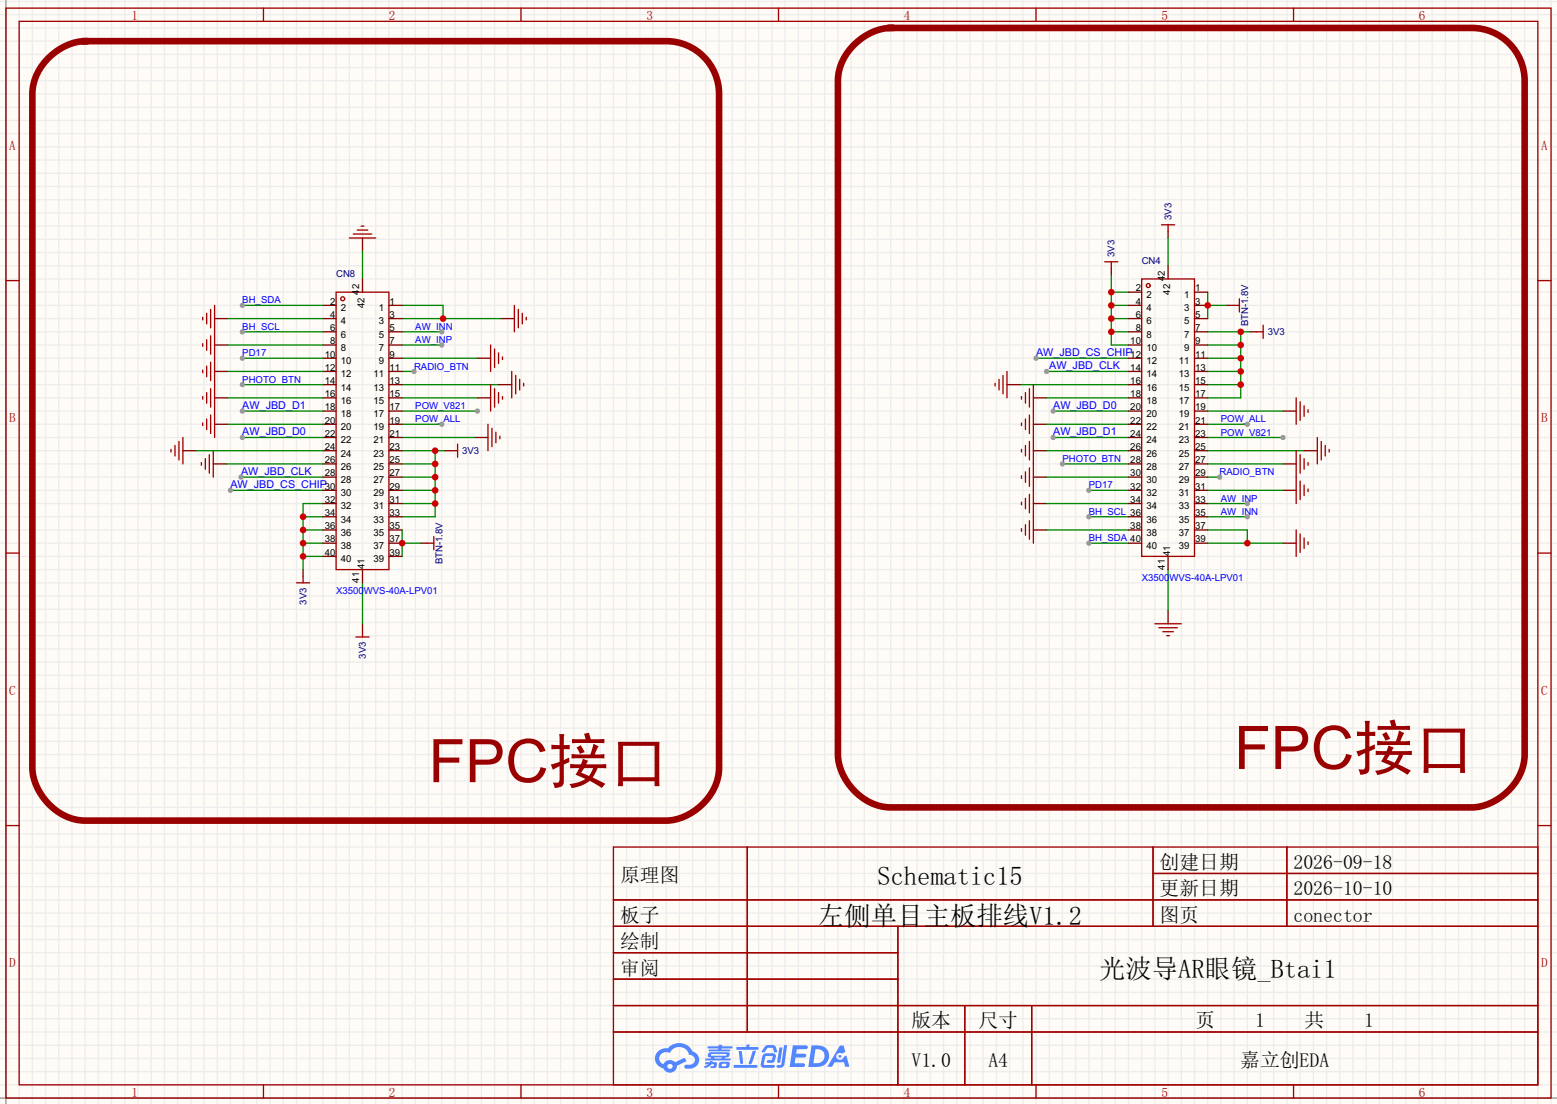
[picture p39: page 1]

BH_SDA | 2 | | | 1 | | | | 4 | 2 | 1 | 3

BH_SCL | 6 | 4 | 3 | 5 | AW_INN | | | 8 | 6 | 5 | 7

8 | 6 | 5 | 7 | AW_INP | | | | 8 10 10 | 7 | 9

PD17 | | 8 10 10 | 7 | 9 | | AW_JBD_CS_CHIP | | | 12 12 | 9 11 | 11

12 12 | 9 11 | 11 | RADIO_BTN | | AW_JBD_CLK | | 14 14 | 13 | 13

PHOTO_BTN | | 14 14 | 13 | 13 | | | | | 16 16 | 15 | 15

B | | | | 20 20 | | | | | POW_ALL | | | | | 21 19 | 21 22 22 19 | POW_ALL | B

AW_JBD_D1 | | 18 18 | | 17 | 17 | | POW_V821 | | AW_JBD_D0 | | 20 20
AW_JBD_D0 | | | | 21 19 | 21 22 22 19 | | | | AW_JBD_D1 | | 24 24 | 23 | 23 | POW_V821

24 24 | | 23 | 23 | | | | | | 26 26 | 25 | 25
26 26 | | 25 | 25 | | | PHOTO_BTN | 28 28 | 27 | 27

AW_JBD_CLK | | 28 28 | | | 27 | 27 | | | | 30 30 | 29 | 29 | RADIO_BTN
AW_JBD_CS_CHIP | | | 30 30 | | | 29 | 29 | | PD17 | | 32 32 | 31 | 31

32 32 | | | 31 | 31 | | | | 34 34 | 33 | 33 | AW_INP
34 34 | | | 33 | 33 | | BH_SCL | | 36 36 | 35 | 35 | AW_INN
36 36 | | | 35 | 35 | | | | 38 38 | 37 | 37
38 38 | | 37 | 37 | | BH_SDA | 40 40 | 39 | 39
40 40 | | 39 | 39

X3500WVS-40A-LPV01

更新日期 | 2026-10-10

板子 | 左侧单目主板排线V1.2 | | 图页 | conector
绘制

D | 审阅 | | 光波导AR眼镜_Btai1 | | | D
