kemomi/Btai-AR/PDF_光波导AR眼镜_Btai1_PCB/SCH_Schematic3_1_2026-10-13.pdf

# 1.conector

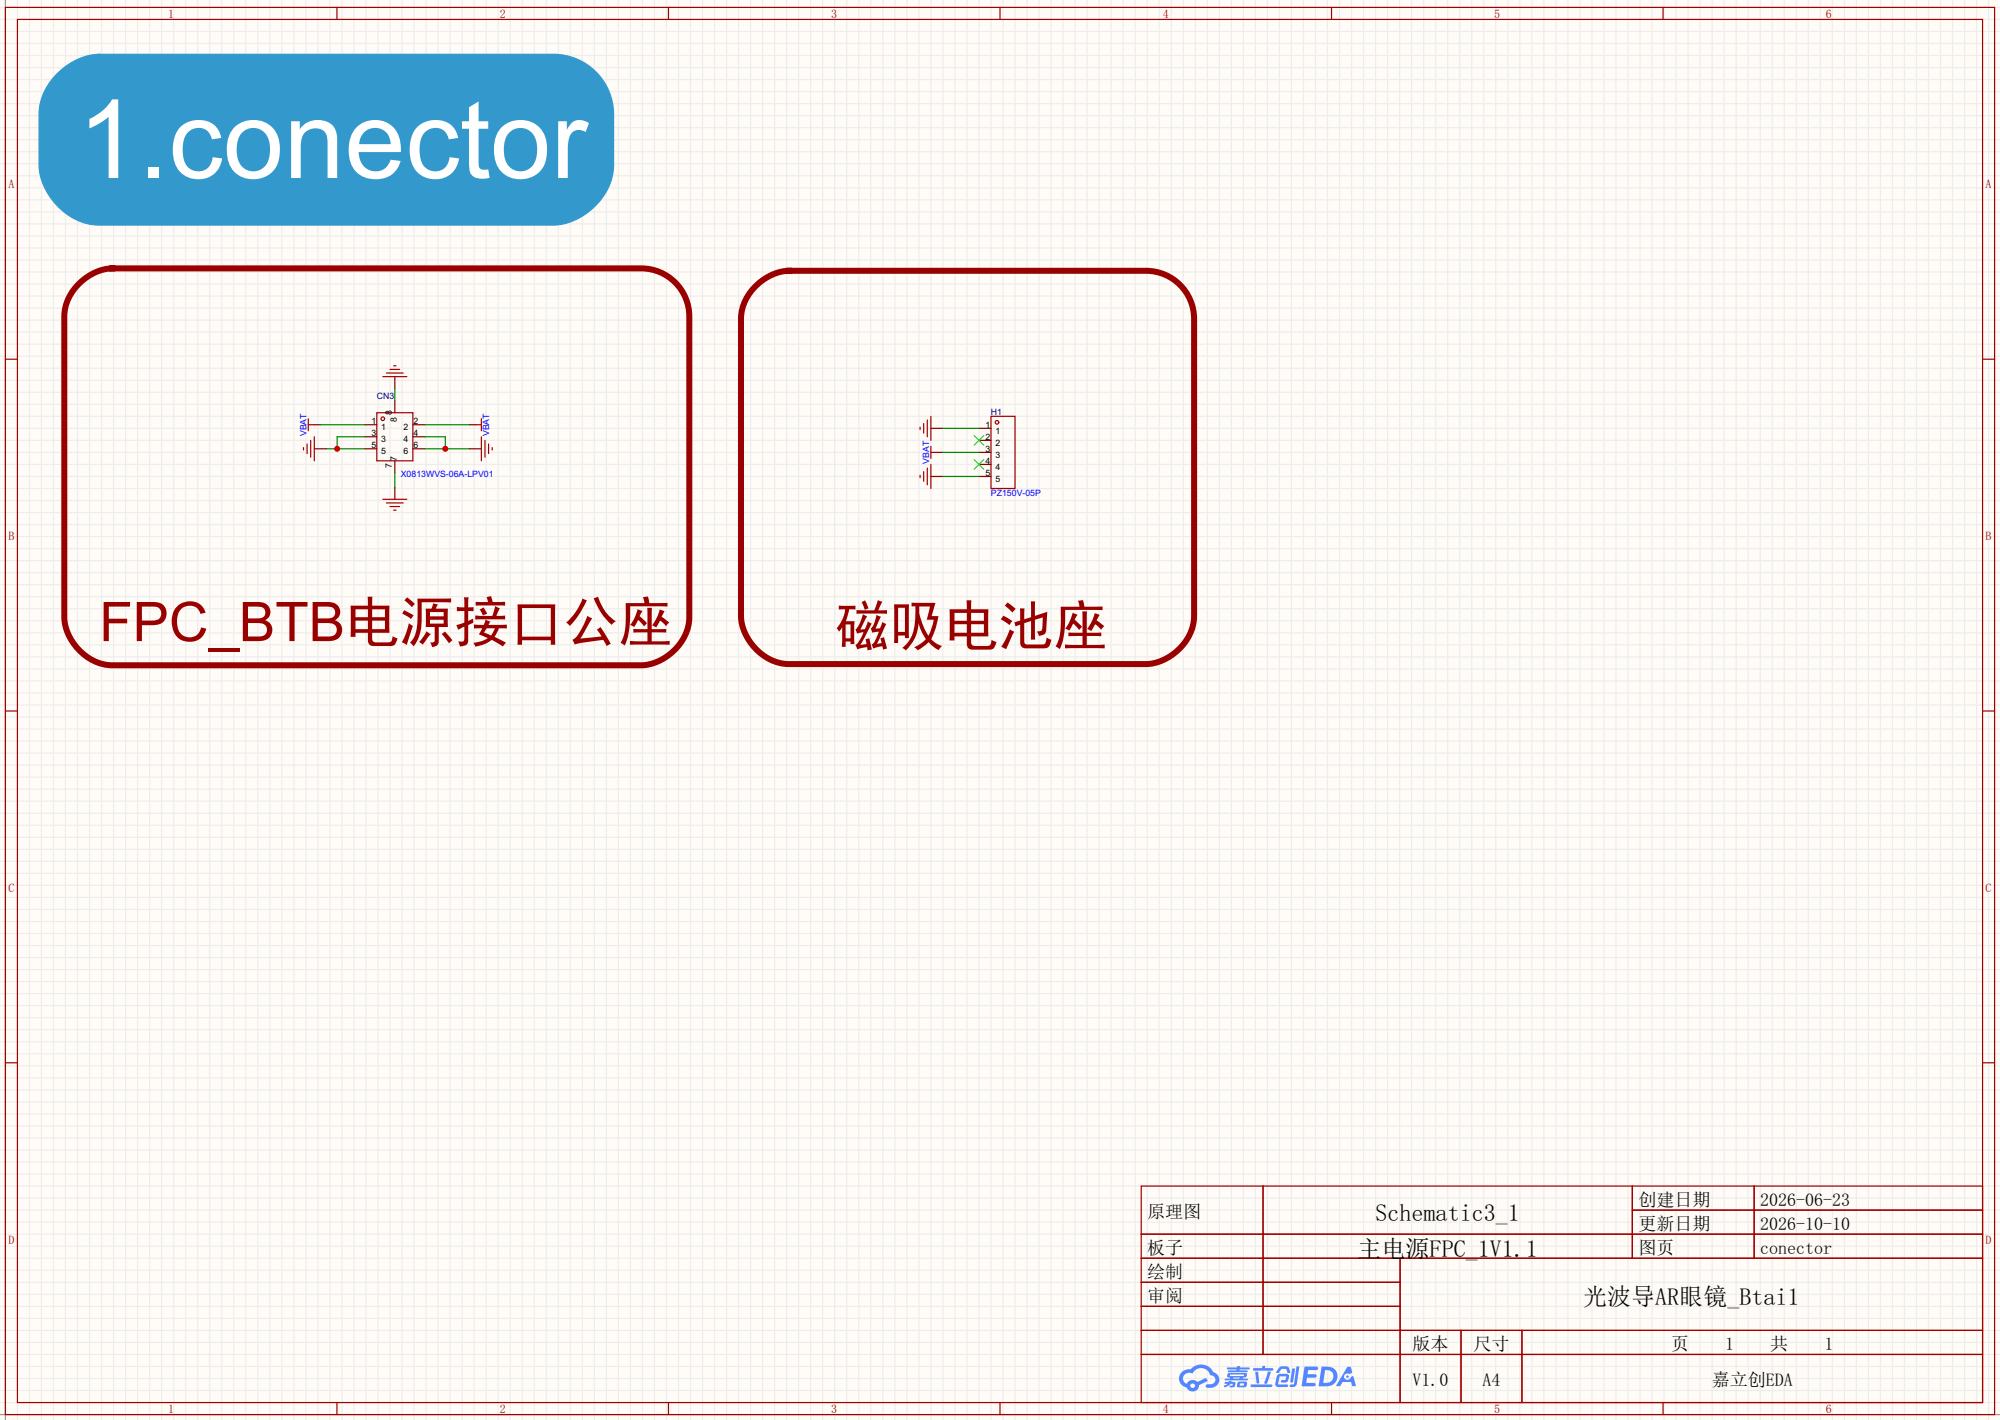
[picture p40: page 1]
