kemomi/Btai-AR/PDF_光波导AR眼镜_Btai1_PCB/SCH_Schematic7_2026-10-13.pdf

# 1.imx219

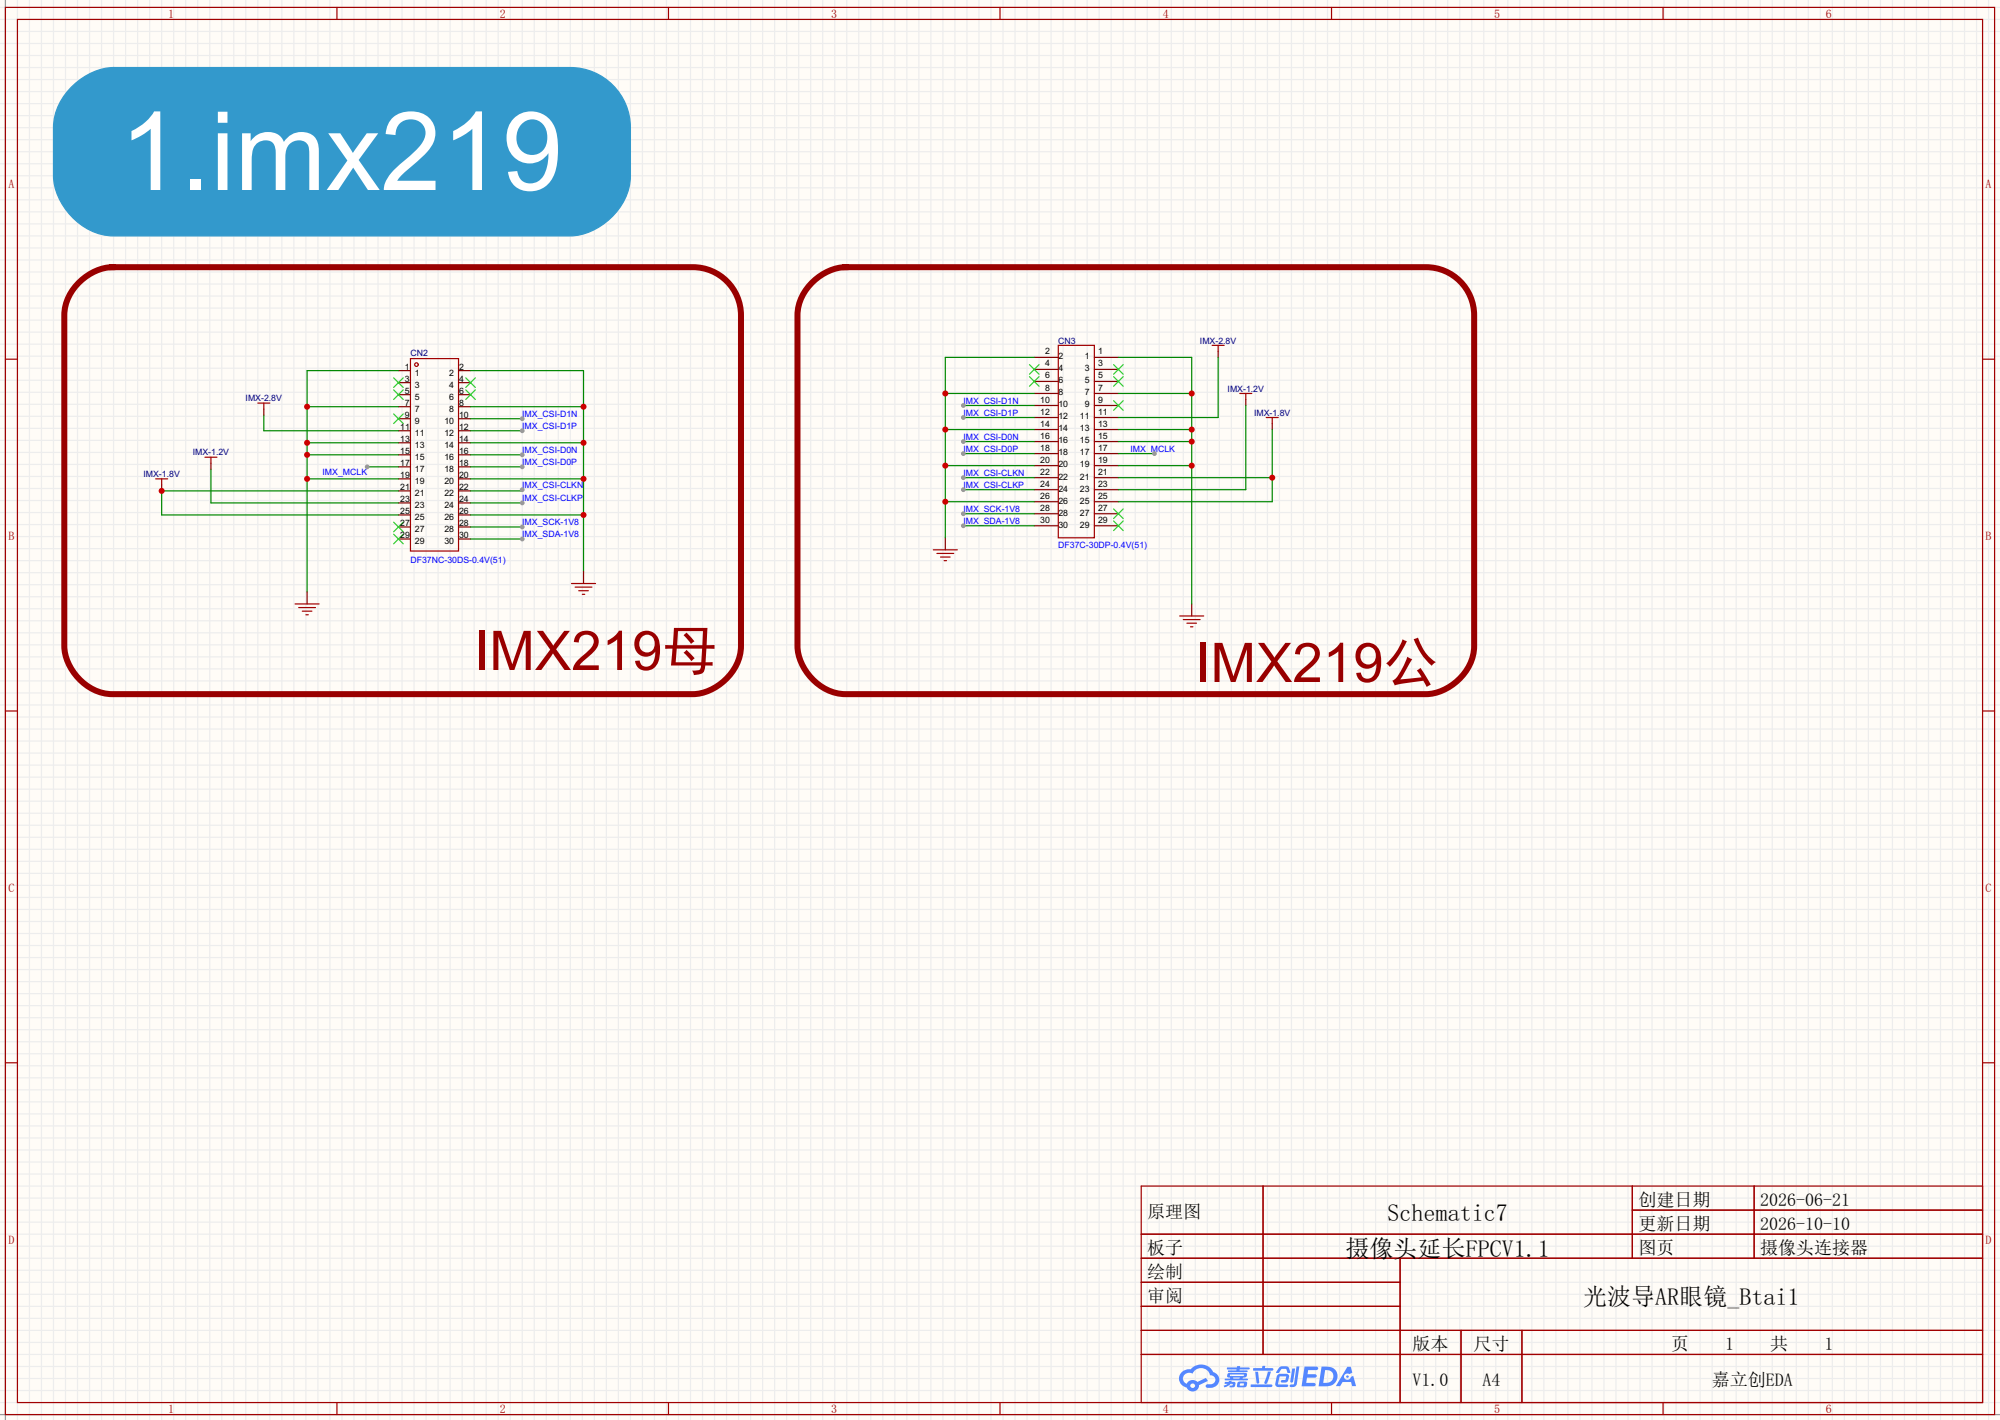
[picture p42: page 1]

IMX_CSI-D0N IMX_CSI-D0P

IMX_MCLK

IMX_CSI-CLKN IMX_CSI-CLKP
