kemomi/Btai-AR/PDF_光波导AR眼镜_Btai1_PCB/SCH_Schematic8_2026-10-13.pdf

# 1.Pogopin BAT+

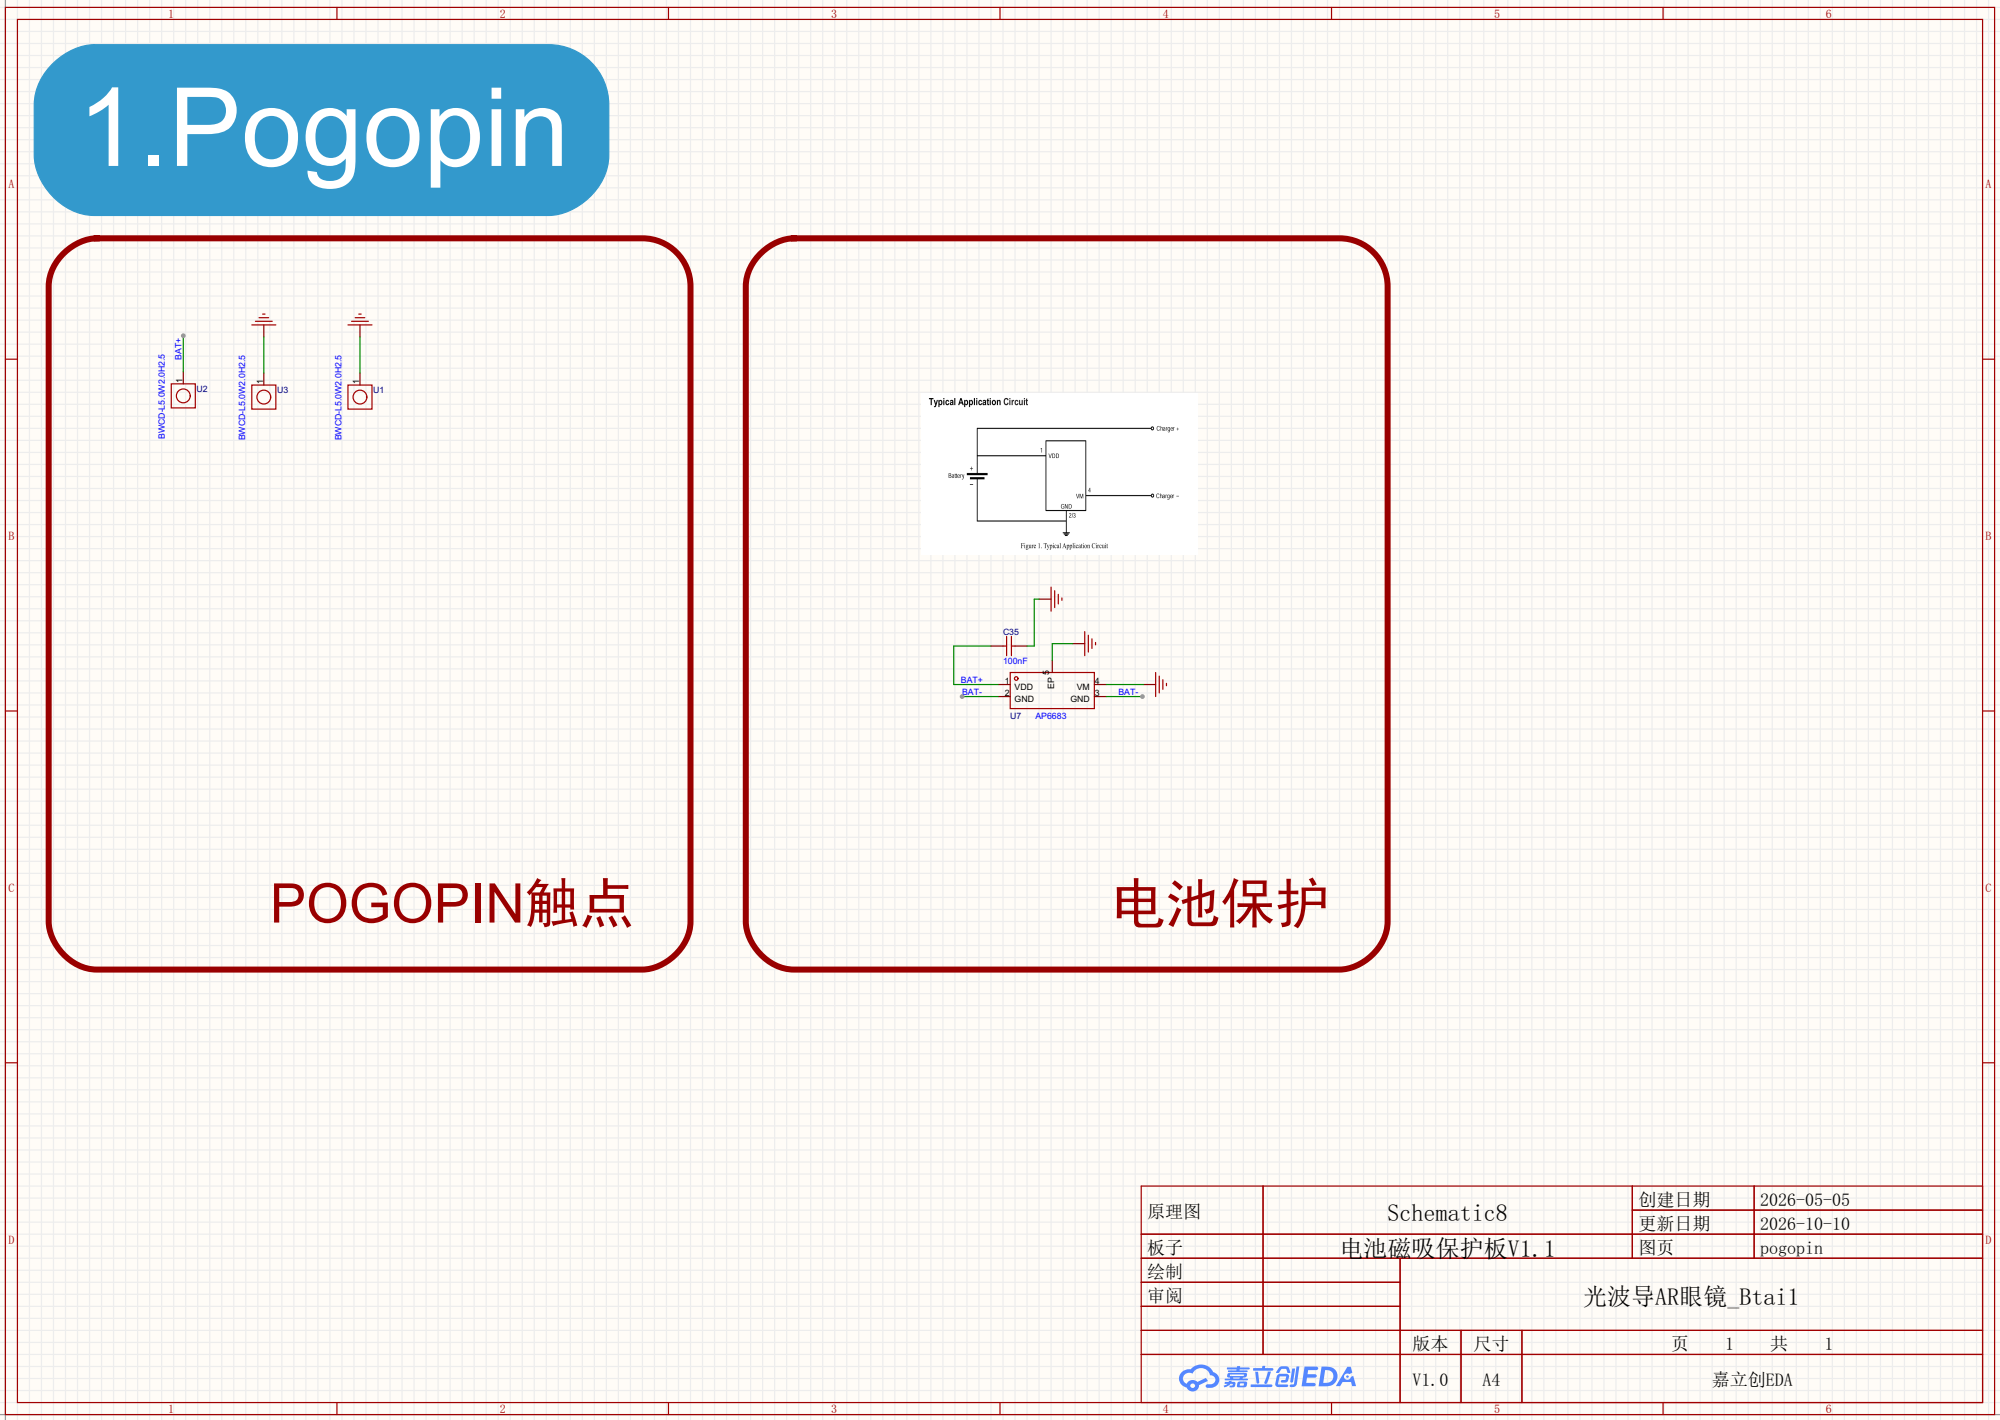
[picture p43: page 1]
