kemomi/Btai-AR/PDF_光波导AR眼镜_Btai1_PCB/SCH_Schematic9_2026-10-13.pdf

# 1.conector

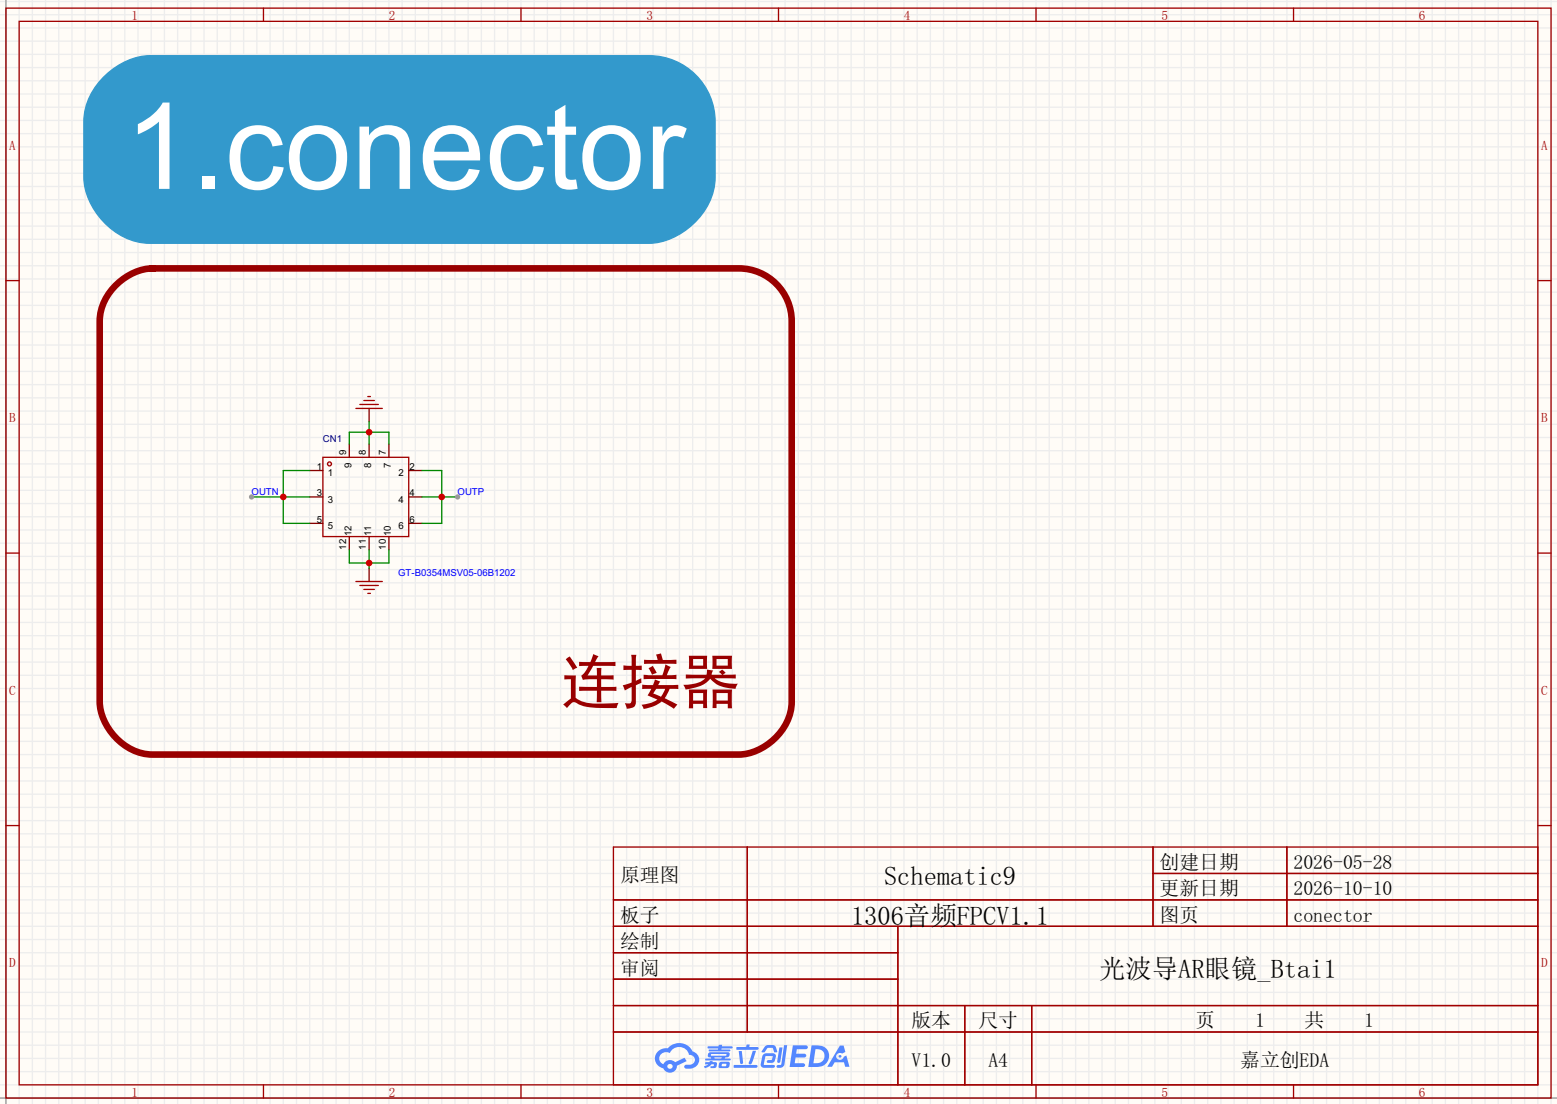
[picture p44: page 1]

OUTN | OUTP

连接器

更新日期 | 2026-10-10

板子 | 1306音频FPCV1.1 | | 图页 | conector
绘制

D | 审阅 | | 光波导AR眼镜_Btai1 | | | D
